greencardigan/TC4-shield/trunk/hardware/LCDapter/P1000953-BARE-800.jpg

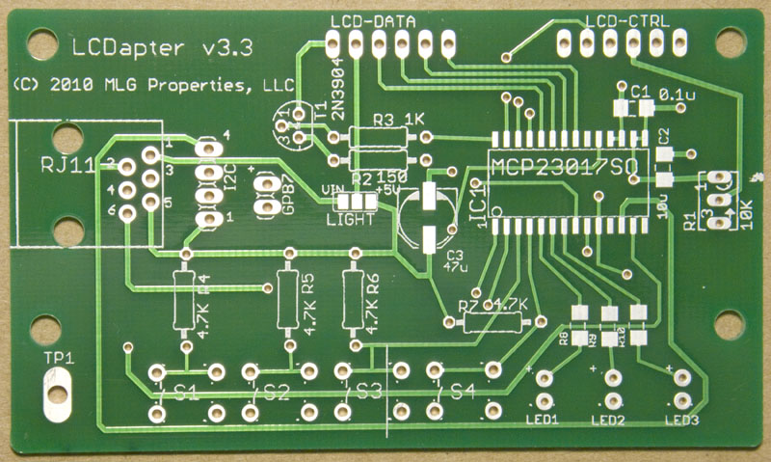
trunk/hardware/LCDapter/P1000953-BARE-800.jpg
