greencardigan/TC4-shield/trunk/README.txt

README.txt for /svn/trunk

/svn/trunk and subfolders have been superseded by a
new Subversion repository organization as of April 4, 2011.

For historical and references purposes, the old folder tree is left
intact.

No new development work should be done in this tree.  Current versions
of all project documents can be found as follows:

/svn/applications:  applications software
/svn/hardware:  PCB designs and related information
/svn/wiki:  various wiki files
