greencardigan/TC4-shield/applications/Bourbon/docs/README.txt

Bourbon 2_3 Arduino 0022 Win 7 Setup
------------------------------------

Kindly contributed by Larry Lofthouse (LoftyNotions on Homeroasters.org). Updates
and supersedes the original guide written by Randy T.

Jim Gallt
31-Jan-2012
