greencardigan/TC4-shield/trunk/arduinosoftware/sketches/demo1/README.TXT

this demo uses 18-bit samples and reports every 2 seconds
channels 0-3 assume K-type thermocouples and report temps in F.
