greencardigan/TC4-shield/applications/util/pCOMlist/trunk/pCOMlist/README.txt

pCOMlist
--------

Processing sketch that reads system information
and returns a list of the current active COM
ports.

Nothing fancy, but handy when using Arduino boards
connected remotely.

Executable versions located in the application.* folders
for various platforms.

Jim Gallt
4/16/2011
