greencardigan/TC4-shield/trunk/arduinosoftware/sketches/aGesha/cal/Readme.txt

wdw 8 mar '11

With JimG's help, we've tracked down the major cause for the non-linearity --
the two diode drops in the full-wave bridge.

So, with any luck the files in this directory will become obsolete.
