greencardigan/TC4-shield/hardware/TC4/docs/TC4-pins.pdf

5/12/2014

Pin | Descrip. | TC4 Use
D0 | RX
D1 | TX
D2 | INT0 | IO2
D3 | PWM / INT1 | IO3 & Jee3-6
D4
D5** | PWM
D6** | PWM | Jee3-2 | Note: Many Jee devices are 3.3V
D7 | | | and will not be compatible with
D8 | | | the 5V signals from Arduino.
D9 | PWM | OT1 | JeePort header
D10* | PWM | OT2
D11* | PWM | | Header | Pin | Signal
D12* | | | Jee3 | 1 | VIN
D13* | | | | 2 | D6
| | | | 3 | GND
A0 | | ANLG1 | | 4 | +3.3V
A1 | | ANLG2 | | 5 | A2
A2 | | Jee3-5 | | 6 | D3
A3
A4 | | I2C (SDA)
A5 | | I2C (SCL)

* These pins support SPI communication, which, although provided
by the underlying hardware, is not currently included in the Arduino language.

** These pins support PWM provided by timer0. Timer0 is also used
for the millis() and analogWrite() functions.
Arduino pin descriptions | Updated 5/12/14
