greencardigan/TC4-shield/applications/Bourbon/aBourbon/tags/REL-200/pBourbon/logs/roast201104072021-4435.jpg

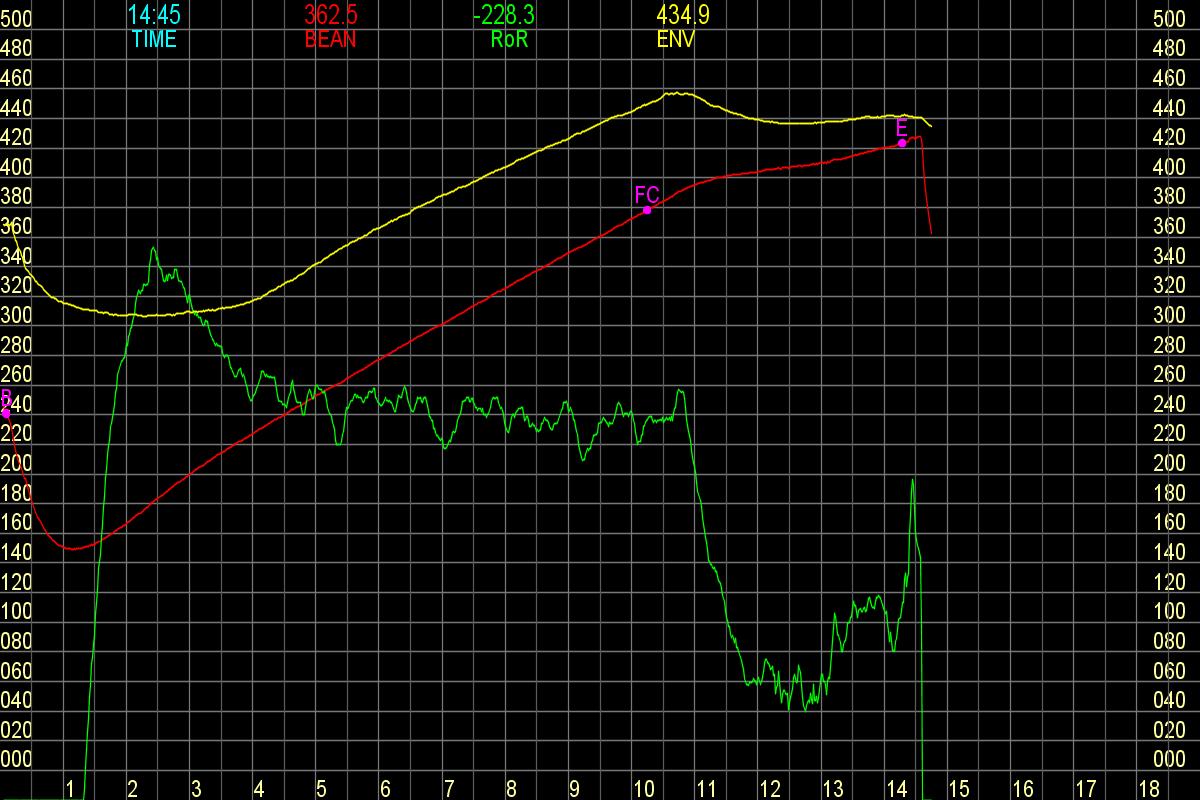
applications/Bourbon/aBourbon/tags/REL-200/pBourbon/logs/roast201104072021-4435.jpg
