greencardigan/TC4-shield/applications/Bourbon/aBourbon/tags/REL-200/pBourbon/logs/roast201104072110-3110.jpg

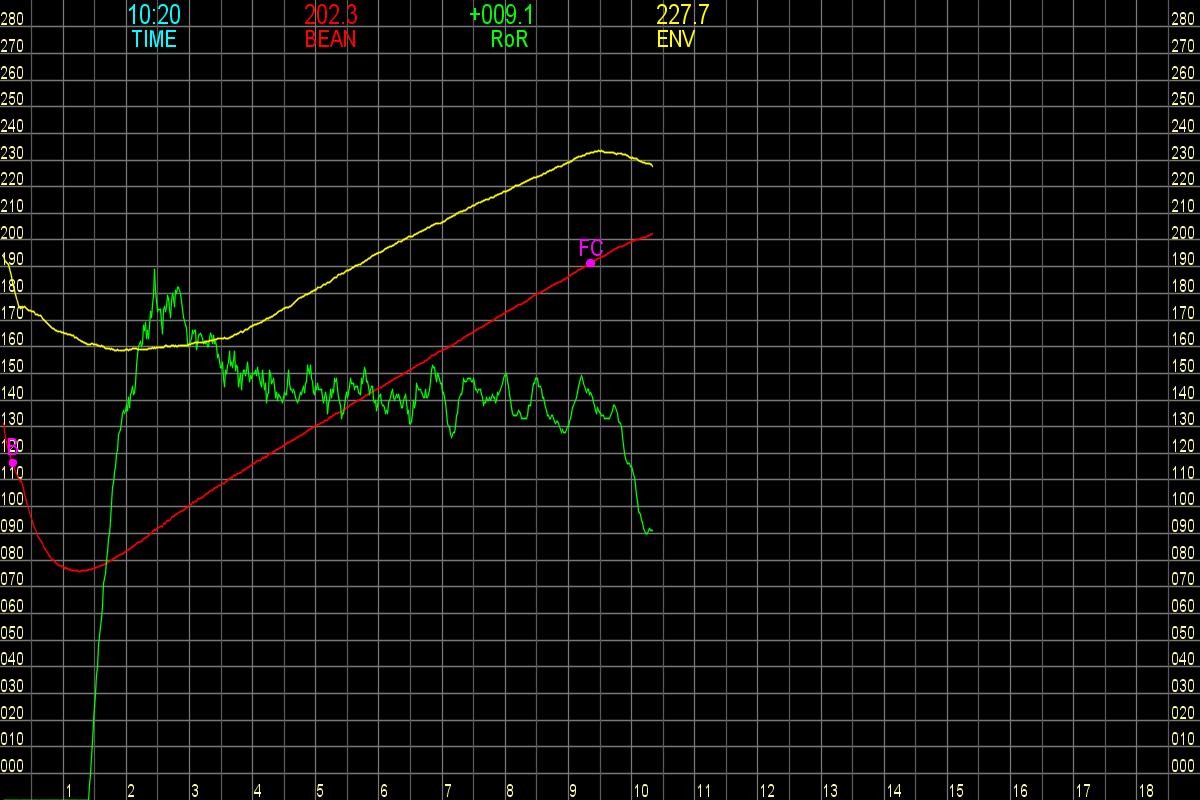
applications/Bourbon/aBourbon/tags/REL-200/pBourbon/logs/roast201104072110-3110.jpg
