greencardigan/TC4-shield/hardware/TC4C/V1.33/tc4c133-800.jpg

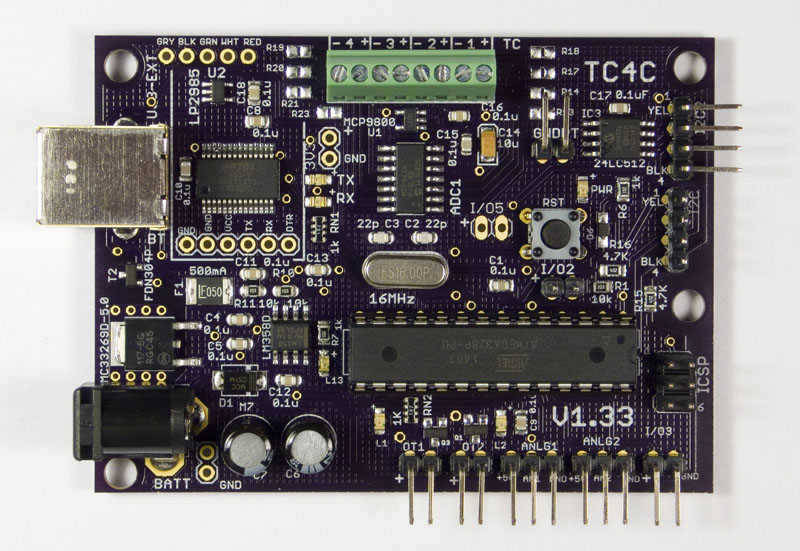
hardware/TC4C/V1.33/tc4c133-800.jpg
