greencardigan/TC4-shield/trunk/arduinosoftware/sketches/aGesha/juice_monitor.jpg

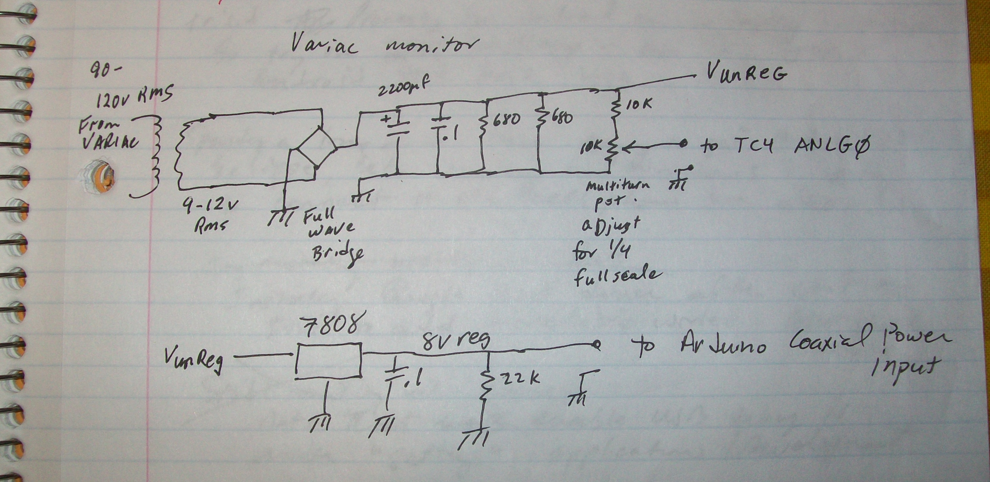
trunk/arduinosoftware/sketches/aGesha/juice_monitor.jpg
