greencardigan/TC4-shield/trunk/hardware/LCDapter/LCDcable-800.jpg

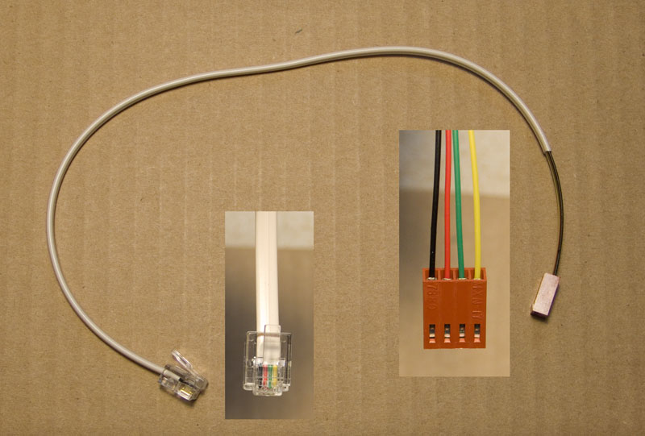
trunk/hardware/LCDapter/LCDcable-800.jpg
