greencardigan/TC4-shield/trunk/hardware/LCDapter/P1000949-SMD-800.jpg

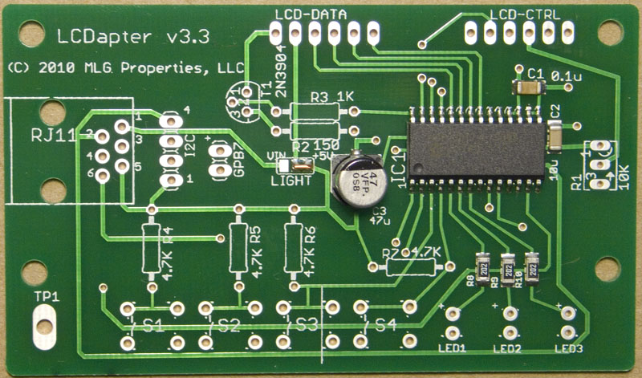
trunk/hardware/LCDapter/P1000949-SMD-800.jpg
