greencardigan/TC4-shield/trunk/hardware/LCDapter/P1000961-800.jpg

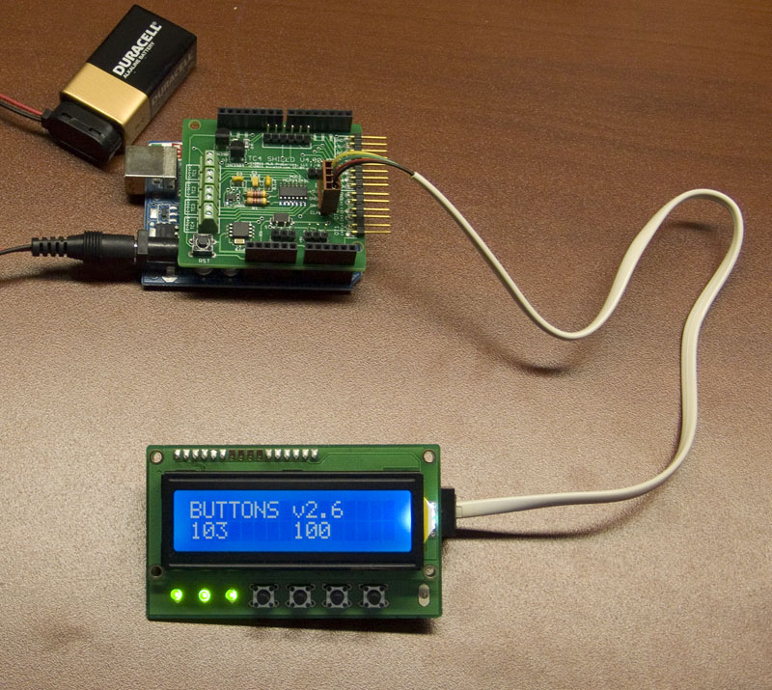
trunk/hardware/LCDapter/P1000961-800.jpg
