greencardigan/TC4-shield/trunk/hardware/TC4 V400/P1000915-600.jpg

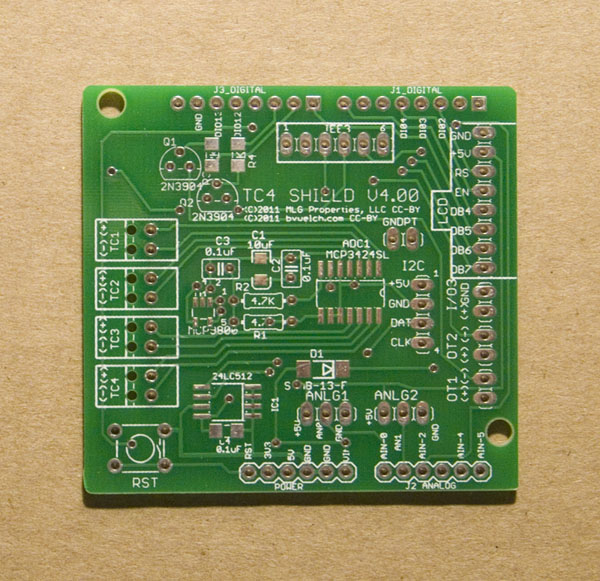
trunk/hardware/TC4 V400/P1000915-600.jpg
