greencardigan/TC4-shield/trunk/hardware/TC4 V400/P1000938-SMD.jpg

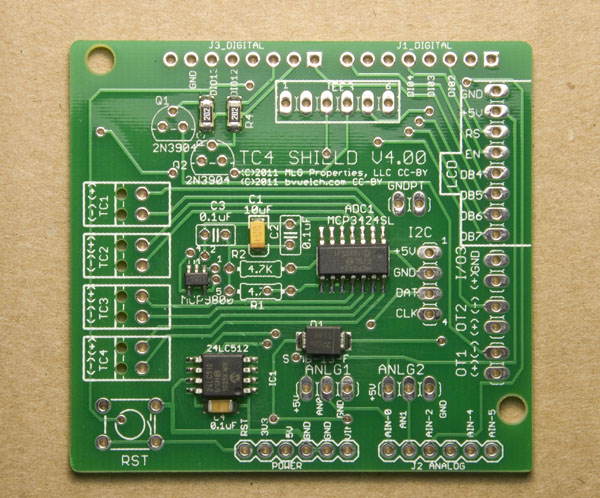
trunk/hardware/TC4 V400/P1000938-SMD.jpg
