greencardigan/TC4-shield/trunk/hardware/docs/TC4-pins.xlsx

Arduino pin assignments |  |  | LCD pin header
Pin | Descrip. | TC4 Use | Header | Pin | Signal
D0 | RX |  | LCD | 1 | GND
D1 | TX |  |  | 2 | 5V
D2 | INT0 | LCD 4 RS |  | 3 | D2
D3 | PWM / INT1 | I/O3 & Jee3-6 |  | 4 | D4
D4 |  | LCD 6 EN |  | 5 | D7
D5 | PWM/millis() |  |  | 6 | D8
D6 | PWM/millis() | Jee3-2 |  | 7 | D12
D7 |  | LCD 11 DB4 |  | 8 | D13
D8 |  | LCD 12 DB5
D9 | PWM | OT1 | JeePort header
D10* | PWM | OT2
D11* | PWM |  | Header | Pin | Signal
D12* |  | LCD 13 DB6 | Jee3 | 1 | VIN
D13* |  | LCD 14 DB7 |  | 2 | D6
 |  |  |  | 3 | GND
A0 |  | ANLG1 |  | 4 | +3.3V
A1 |  | ANLG2 |  | 5 | A2
A2 |  | Jee3-5 |  | 6 | D3
A3 |  | button interface
A4 |  | I2C
A5 |  | I2C
* These pins support SPI communication, which, although provided
by the underlying hardware, is not currently included in the Arduino language.
16 x 2 LCD pin assignments
 |  | Arduino | Jumper - Pin | LCD board
1 | VSS | GND | LCD-1 | ground, POT-1
2 | VDD | 5V | LCD-2 | Vdd, POT-3
3 | V0 |  |  | POT-2 (wipe)
4 | RS | D2 | LCD-3
5 | R/W | GND |  | ground
6 | EN | D4 | LCD-4
7 | DB0 |  |  | nc
8 | DB1 |  |  | nc
9 | DB2 |  |  | nc
10 | DB3 |  |  | nc
11 | DB4 | D7 | LCD-5
12 | DB5 | D8 | LCD-6
13 | DB6 | D12 | LCD-7
14 | DB7 | D13 | LCD-8
15 | (optional) |  |  | Vdd (backlight)
16 | (optional) |  |  | ground (backlight)
POT = 10K LCD contrast adjustment potentiometer
Current TC-4 shield v1.06R shown in normal text.
Proposed TC-4 shield v2.00 shown in italics text.
