greencardigan/TC4-shield/hardware/TC4C/V1.32/tc4c132.dxf

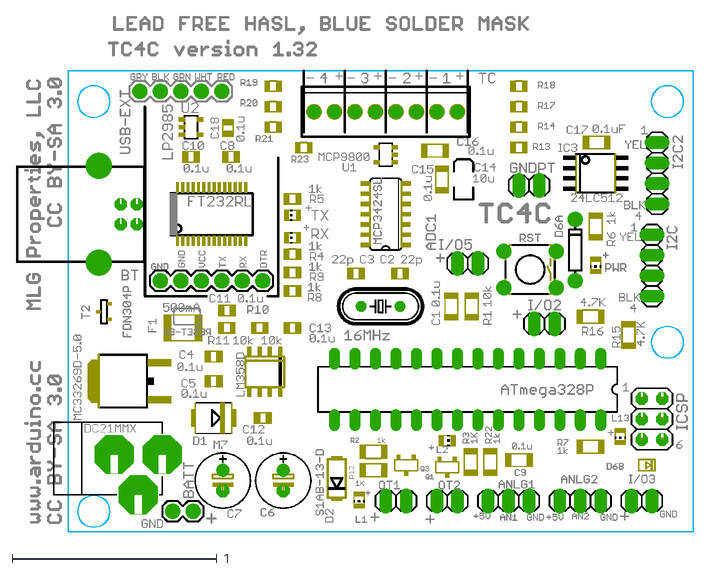
[picture p14: CAD file, 2015-12-07, an earlier design]
hardware/TC4C/V1.32/tc4c132.dxf
3.30 x 2.52
