greencardigan/TC4-shield/applications/Artisan/aArtisan_PID/branches/aArtisanQ_PID 6.5 IO11 Test/aArtisanQ_PID/tc4-wiring-small-20111120.jpg

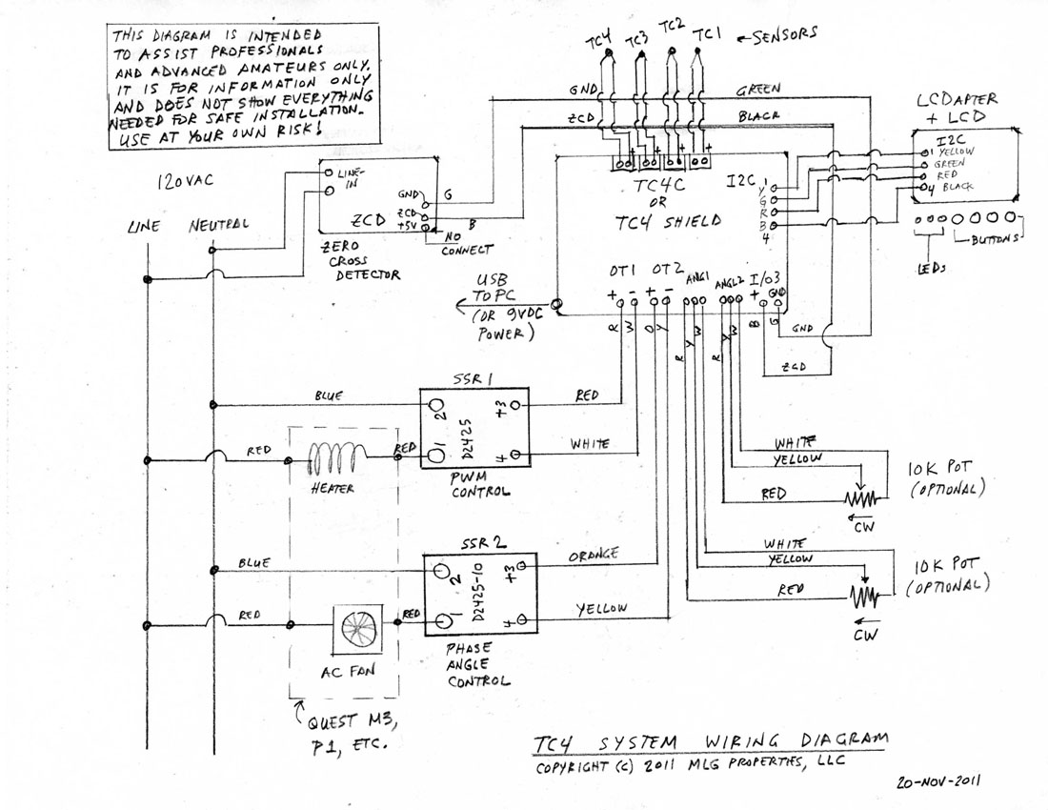
applications/Artisan/aArtisan_PID/branches/aArtisanQ_PID 6.5 IO11 Test/aArtisanQ_PID/tc4-wiring-small-20111120.jpg
