greencardigan/TC4-shield/trunk/hostsoftware/pj_logger/testlog001.csv

# time | ambient | T0 | T1 | T2 | T3
# mcp9800 Config reg OK
10 | 73 | 32 | 71 | 71 | 72
12 | 73 | 32 | 71 | 71 | 72
13 | 73 | 32 | 71 | 71 | 72
14 | 73 | 32 | 71 | 71 | 72
15 | 73 | 32 | 71 | 71 | 72
17 | 73 | 32 | 71 | 71 | 72
18 | 73 | 200 | 71 | 72 | 72
19 | 73 | 200 | 71 | 71 | 72
20 | 73 | 200 | 71 | 71 | 72
21 | 73 | 200 | 71 | 71 | 72
23 | 73 | 200 | 71 | 71 | 72
24 | 73 | 200 | 71 | 72 | 72
25 | 73 | 200 | 71 | 72 | 73
26 | 73 | 200 | 71 | 71 | 73
28 | 73 | 200 | 71 | 71 | 73
29 | 73 | 200 | 71 | 71 | 73
30 | 73 | 200 | 71 | 71 | 73
31 | 73 | 200 | 71 | 71 | 73
32 | 73 | 200 | 71 | 71 | 72
34 | 73 | 200 | 71 | 71 | 72
35 | 73 | 200 | 71 | 71 | 82
36 | 73 | 200 | 71 | 72 | 86
37 | 73 | 200 | 71 | 71 | 87
39 | 73 | 200 | 71 | 71 | 88
40 | 73 | 200 | 71 | 71 | 89
41 | 73 | 200 | 71 | 71 | 89
42 | 73 | 200 | 71 | 71 | 90
44 | 73 | 200 | 78 | 71 | 90
45 | 73 | 200 | 87 | 71 | 90
46 | 73 | 200 | 88 | 71 | 91
47 | 73 | 200 | 90 | 72 | 91
48 | 73 | 200 | 90 | 72 | 91
50 | 73 | 200 | 91 | 72 | 91
51 | 73 | 200 | 91 | 72 | 91
52 | 73 | 200 | 92 | 72 | 90
53 | 73 | 200 | 92 | 72 | 89
55 | 73 | 200 | 92 | 85 | 88
56 | 73 | 200 | 92 | 87 | 87
57 | 73 | 200 | 92 | 88 | 86
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
