greencardigan/TC4-shield/(threads)

Thread 1 (2017-01-12):

Disabling pwmio3 variable may effect PWM prescaler setup for DC Fan

James-NZ, 2017-01-12:
Could you please check if the following commit means that the PWM prescaler is no longer configured when using CONFIG_PWM (DC Fan):
https://github.com/greencardigan/TC4-shield/commit/1a43b605e0eeed1d8f1c8d5bd6899b52d568b04e

As far as I can tell, calling pwmio3.Setup is the only way that the prescaler is configured which is still relevant for analogWrite() as this is equivalent to pwmio3.Out().

Just to be sure, I have changed my fork to :
#ifndef CONFIG_PAC3
  pwmio3.Setup( IO3_PCORPWM, IO3_PRESCALE_128 ); // setup pwm frequency on IO3
#endif

And used pwmio3.Out() instead of analogWrite() in outIO3() just to be consistent. Refer to this merge:
https://github.com/James-NZ/TC4-shield/commit/e5bec38d448a953b3f53fba392a26abc10d823d0

This commit for bumpless PID transfer may also be of interest:
https://github.com/James-NZ/TC4-shield/commit/82f7914ceee186b2ed3b74054522580cb488c435

Cheers,
James

greencardigan, 2017-01-12:
Thanks James,
I might forward this to Jim to look at.
Cheers,
Brad

greencardigan, 2017-03-21:
Hi James,
Does this commit address your issue?
https://github.com/greencardigan/TC4-shield/commit/6602013d9a99aa43e575d62d287cea674e6788f0

Closed 2017-08-04.

Thread 5 (2021-11-09):

Conflict between CONFIG_PAC2 or CONFIG_PAC2_IO3HTR, and parallel LCD

timbarnes, 2021-11-09:
This issue has been seen with version aArtisanQ_PID 6_3, installed in a genuine Arduino UNO.

Line IO2 is assigned to Arduino D2, and is used to read the ZCD in the case that CONFIG_PAC2 or CONFIG_PAC2_IO3HTR have been selected.

The same Arduino D2 line is used for RS in the configuration of the parallel LCD display.

The CONFIG_PWM and CONFIG_PAC3 work correctly with the parallel LCD display.

The result of the conflict is incorrect data being written to the display.

One tested workaround is to redefine the LCD's RS line to use D5: this removes the conflict and will work in the case that the LCD is hand-wired to the Arduino.

greencardigan, 2021-12-15:
https://github.com/greencardigan/TC4-shield/commit/6405a10419cd8967fb9f39c79285bbbecf306dd1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

Closed 2021-12-15.

Thread 6 (2021-12-10):

PID profile number

renatoa, 2021-12-10:
Why is the parsed value of profile number incremented by one at the line below?
https://github.com/greencardigan/TC4-shield/blob/master/applications/Artisan/aArtisan_PID/trunk/src/aArtisanQ_PID/cmndreader.cpp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
This increment led to strange behavior in my practice... for example if I want to set manual mode, I have to send PID;P;-1 command, which is weird...

Also, I think that profile_number_new variable should be synced with profile_number, because it is used in many places instead.
For example, if the user switch LCD_mode to 1, after a PID;P;x command is issued, will have the screen initialized with former profile_number, instead the new profile_number x, modified by PID;P;x command.

greencardigan, 2021-12-14:
I don’t recall why I had incremented the profile number. Maybe it was old code prior to adding the PID feature and using profile 0. I will remove the increment.

I think I will sync profile_number and profile_number_new in cmndreader after line 577. That should work? However, most users that are using eeprom profiles and buttons would be in standalone mode and would not be using roasting software or the PID;P command.

renatoa, 2021-12-14:
Yes, it's ok after 577, same location added in my code too.

Closed 2021-12-15.

Thread 7 (2022-02-23):

Setpoint used instead SV, out of visibility scope

renatoa, 2022-02-23:
Trying today to debug something, activated ACKS_ON, and got the following compile error:

```
sketch\cmndreader.cpp: In member function 'virtual boolean pidCmnd::doCommand(CmndParser*)':
cmndreader.cpp:636:60: error: 'Setpoint' was not declared in this scope
       Serial.print(F("# PID setpoint = ")); Serial.println(Setpoint);

```

...at this line:
https://github.com/greencardigan/TC4-shield/blob/master/applications/Artisan/aArtisan_PID/trunk/src/aArtisanQ_PID/cmndreader.cpp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

My guess is that the author intended to print SV, not Setpoint, which is not declared External in cmndreader.cpp
And nobody used ACKS_ON since then :)

greencardigan, 2022-02-25:
https://github.com/greencardigan/TC4-shield/commit/1af3a99a78ed36d4f7126ab66c72f3f1bc9e5203

Closed 2022-02-25.

Thread 8 (2022-02-23):

Wrong parameter index in PID;P command

renatoa, 2022-02-23:
Please check here:
https://github.com/greencardigan/TC4-shield/blob/master/applications/Artisan/aArtisan_PID/trunk/src/aArtisanQ_PID/cmndreader.cpp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

paramStr(1) is not the profile number, but the P command
Should be paramStr(2)

greencardigan, 2022-02-24:
This command was originally intended to be used as per the documentation PID,Px.

However, I think it makes sense to change it to PID,P,x so it is consistent with the other command formats.

greencardigan, 2022-02-25:
https://github.com/greencardigan/TC4-shield/commit/1af3a99a78ed36d4f7126ab66c72f3f1bc9e5203

Closed 2022-02-25.

Thread 9 (2022-06-25):

'P_ON_M' was not declared in this scope

haidermri, 2022-06-25:
Trying to compile latest aArtisanQ_PID for TC4+ and running into this error

Arduino: 1.8.19 (Windows Store 1.8.57.0) (Windows 10), Board: "Arduino Uno"
D:\git\TC4-shield\applications\Artisan\aArtisan_PID\trunk\src\aArtisanQ_PID\cmndreader.cpp: In member function 'virtual boolean pidCmnd::doCommand(CmndParser*)':

cmndreader.cpp:601:39: error: 'P_ON_M' was not declared in this scope

         myPID.SetTunings( kp, ki, kd, P_ON_M ); // Proportional on Measurement

                                       ^~~~~~

cmndreader.cpp:603:39: error: 'P_ON_E' was not declared in this scope

         myPID.SetTunings( kp, ki, kd, P_ON_E ); // Proportional on Error

                                       ^~~~~~

aArtisanQ_PID:256:46: error: 'P_ON_E' was not declared in this scope

   PID myPID(&Input, &Output, &Setpoint,2,5,1,P_ON_E,DIRECT);

                                              ^~~~~~

D:\git\TC4-shield\applications\Artisan\aArtisan_PID\trunk\src\aArtisanQ_PID\aArtisanQ_PID.ino: In function 'void setup()':

aArtisanQ_PID:1488:35: error: 'P_ON_E' was not declared in this scope

   myPID.SetTunings(PRO, INT, DER, P_ON_E); // set initial PID tuning values and set Proportional on Error mode

                                   ^~~~~~

exit status 1

'P_ON_M' was not declared in this scope

renatoa, 2022-06-25:
PID library is not updated to the Proportional On Measurement version V1.2.1
You can get it from: https://github.com/br3ttb/Arduino-PID-Library

haidermri, 2022-06-25:
Thank you
That fixed it

Closed 2022-06-27.

Thread 10 (2022-08-19):

Probes not recognized?

oliverschirmer, 2022-08-19:
Hi,
long time since something happend here. Hope i'm not disturbing the silence :)
Got my setup a while ago and wanted to resume roasting...

TC4Shield + Arduino UNO
via USB to Artisan Roaster Scope (via Ubuntu 22.04 LTS)
3 working Type-K probes with the socket removed. (Tested on an other temp device)

I got a valid read out if the TC4 with the probes disconnected. 26-27°C ambient temp.. Touching the green clamps for probes makes the read out rise to 30°C... as expected.

Connecting the probes and activating the data collection still shows the ambient temp. Touching the green clamps makes the temp rise. Touching the probes end won't make a change.
I tested all channels with both polarities and different probes.

How do I debug from here?

Thanks a lot!
Oliver

greencardigan, 2022-08-24:
Hi, If your thermocouples are definitely working, the only thing I can think of is the ADC chip isn't working properly.

oliverschirmer, 2022-08-24:
Thanks for writing back! Can you elaborate? Why is it sending correct temp data from the "socket" (where the probes get connected to the TC4) if the chip is not working? The ADCs function is to convert analog to digital, right?

How can i verify the status of the components on the board?

I thought it could be a setup issue or because it's version 4.0 (which i forgot to mention...)
Replacing the chip is out of my skill level. Maybe I can use it to automatically open the door of the roasters drum if the drop event is triggered...

Is there a better plattform to continue? This is for coding issues, not a repairing forum, right?

greencardigan, 2022-08-24:
The cold junction/ambient temperature is measured the small temperature sensor chip with 5 pins located just behind the thermocouple connectors. Then the voltage across the thermocouple is measured by the ADC and is converted to a temperature, then added to the cold junction temperature to get the thermocouple temperature. So getting ambient temperature readings only confirms that the cold junction temperature sensor is working.

Version 4 may not have the small capacitors that help protect the ADC.

It seems strange that all channels aren't working. Have you got any different thermocouples to try?

Probably best to ask on the homeroasters.org forum. Maybe this thread. https://homeroasters.org/forum/viewthread.php?thread_id=2180

renatoa, 2022-08-24:
What you mean by " Touching the green clamps"... is this the same as  "the "socket" (where the probes get connected"?
What's the point to test by touching that area, are you trying to induce a shift the cold junction temperature ?

Is not strange that all behave the same, it's only a single ADC and an input mux.

Thread 12 (2023-07-02):

Can you please add functionality for a second DC fan?

arash-ops, 2023-07-02:
Hi, I've redesigned a TC4 type of shield which includes two DC fan outputs and ESP01 wifi module. Everything else stays the same as the current TC4 shield. I need the second DC fan capability for exhaust setup on my DIY coffee roaster using Artisan. Any chance you are able to update your code to add functionality for the second DC fan please? I can try to figure out the ESP01 wifi module programming separately myself. Thank you for all your work on this code

GRIMORIO, 2023-07-02:
tc4 is obsolete, I replaced it with phidgets

arash-ops, 2023-07-02:
I meant I’ve designed a board similar to TC4+ except it has two dc fan motors. How much work would it be to add a second dc fan into your code?

MAKOMO, 2023-07-03:
The TC4 protocol does not support two fans, but only one fan and one heater. We have no intention to extend that protocol any further or change its implementation on the Artisan side. Either use the heater data for your second fan or use a different protocol like MODBUS.

renatoa, 2023-07-03:
> tc4 is obsolete, I replaced it with phidgets

This was your choice, but this not make TC4 is obsolete.
An open source project lives as long as his users decide.
You can't write code for phidgets, for TC4 it's possible.
Added a lot of additional hardware to my TC4, foe example Pt sensors and pressure measurement support are the most noticeable I am remember atm.
Even a second fan addition is possible, there are examples of a second IO3 additions in the HRO forum, coded by me and others.

renatoa, 2023-07-03:
> The TC4 protocol does not support two fans, but only one fan and one heater. We have no intention to extend that protocol any further or change its implementation on the Artisan side. Either use the heater data for your second fan or use a different protocol like MODBUS.

He didn't asked for Artisan support, but for TC4.

greencardigan, 2023-07-03:
Correct, control of a second fan can be added to the TC4 code.  You can even have it work with serial commands sent from Artisan to control it.  You just can't plot the additional fan value on the Artisan graph unless you do a work around like Marko mentioned.

It wouldn't take long to add some basic control of a second fan, but I do not have the time available to do it for you unfortunately.

arash-ops, 2023-07-04:
Ok thanks all for the comments. @renatoa - can you send a link to the HRO forum you are referring to please?
Also I’m curious, do you use pt sensors for coffee roasting?

@greencardigan - I’m not looking to plot the second fan in Artisan. I just need to be able to operate it from artisan. Do you have any general guidance on what I need to update in the code? I can have a go and see if I can get it to work. I have basic enough knowledge to be able to have a go at it if I have some direction and with a lot of google help!

greencardigan, 2023-07-04:
@arash-ops - If you're using CONFIG_PAC2 mode, then you might already be able to use a second fan on the IO3 output and use the IO3;xxx serial command in Artisan.

Otherwise you would have to modify the code for an existing command (in cmndreader.cpp) or create a new command to do an analogWrite.

renatoa, 2023-07-04:
> Ok thanks all for the comments. @renatoa - can you send a link to the HRO forum you are referring to please?
Also I’m curious, do you use pt sensors for coffee roasting?

Ask @timbarnes here:
https://homeroasters.org/forum/viewthread.php?thread_id=6683&highlight=IO4&pid=74502#post_74502
...if no reply will send you my (untested) code

Yes, Pt support was been added for a coffee roaster, to replace TC, in a setup where TC don't perform very well.

arash-ops, 2023-07-11:
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

@greencardigan - I am using the Config_pwm mode. Would I still be able to use AWRITE;ppp;ddd command with this for a second DC fan?

greencardigan, 2023-07-11:
@arash-ops
I think so. The AWRITE command should just be doing a standard arduino analogwrite to the chosen arduino pin.

renatoa, 2023-07-11:
Sent you a PM with a solution on HR forum, noticed ?

arash-ops, 2023-07-13:
@renatoa - only got an email this morning from you. It didn't send me a notification when you send the PM, sorry. Let me see if I can change my email preferences on there.

Thread 13 (2024-02-07):

Setting up artisan with EMKO TCE

JugoOriginal, 2024-02-07:
Hey,
i am trying to setup a EMKO TCE with an arduino and TC4+ in artisan but i am kind of struggling and i stumbled on your page and you seem to know quite a bit about this topic.
My end goal is to send the measured temperature via WiFi to artisan.
Could you help me out please?
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

JugoOriginal, 2024-02-08:
first of all,  thanks for the fast reply!

1. i would like to get the measurements from the sensor into artisan... i never used this before and couldnt get this setup

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

2. in the second step, i would like to send the data remotely to artisan.. basically establish a wireless communication... initially i wanted to use wifi but apparently that is not a good idea.

3. does anyone have experience with such a setup or are there anywhere detailed instructions that i can simply follow? which bluetooth device i need to buy, arduino code etc.

Thank you for your help!

renatoa, 2024-02-09:
BT module is good, it is known also as HC-05. Tons of resources if you search by this name and Arduino. For example:
https://www.instructables.com/Arduino-Bluetooth-Remote-Control-Part-1-Bluetooth-/

For TC4 the main rsources are hosted here:
https://homeroasters.org/forum/viewforum.php?forum_id=133
Just browse the threads about install and setup.

JugoOriginal, 2024-02-09:
thank you very much i´ll do my best to figure this out!

Closed 2024-02-09.

Thread 14 (2024-02-11):

HC-05 modul not discoverable and no resonse in serial monitor

JugoOriginal, 2024-02-11:
Hey there!
I followed the bluetooth configuration sheet online and uploaded the sketch to my arduino mega 2560 but when i type in for example "AT" in my serial monitor i dont get the respose "OK". Furthermore, even though the HC-05 is blinking rapidly, my laptop cant find it. Is there something wrong with the module or is it something else?
Thank you!

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

Thread 15 (2025-01-06):

How to change the frequency on io3

ziomina, 2025-01-06:
I want to replace DCFAN with brushless motor.it need to change PWM frequency to 50Hz on io3. I know it can be changed but I don’t know how.thanks

renatoa, 2025-01-06:
Check PWM_IO3 class for prescaler values for various pwm frequencies.

greencardigan, 2025-01-07:
And then adjust the pwmio3.setup line [here](https://github.com/greencardigan/TC4-shield/blob/20af771463f8a5691169e29d02a686a4cd54e224/applications/Artisan/aArtisan_PID/trunk/src/aArtisanQ_PID/aArtisanQ_PID.ino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)

50Hz is not an option, see below.

```
PWM Frequencies

fast = 16,000,000 / prescale / 256
pcor = 16,000,000 / prescale / 2 / 255

Mode        Prescale              Frequency
----        --------              ---------
fast            1                  62.5kHz
fast            8                  7.8125kHz
fast           32                  1.953125kHz
fast           64                  976.5625Hz
fast          128                  488.28125Hz
fast          256                  244.140625Hz
fast         1024                  61.03515625Hz (PWM16 library default)

pcor            1                  31.37kHz
pcor            8                  3.922kHz
pcor           32                  980.4Hz
pcor           64                  490.2Hz (arduino default)
pcor          128                  245.1Hz
pcor          256                  122.5Hz
pcor         1024                  30.64Hz
```

```
#define IO3_FASTPWM _BV(COM2A1) | _BV(COM2B1) | _BV(WGM21) | _BV(WGM20) // fast PWM
#define IO3_PCORPWM _BV(COM2A1) | _BV(COM2B1) | _BV(WGM20) // phase correct PWM

// BOTTOM to TOP 00 to TOP, setting TOP value in OCR2A:
#define IO3_FASTPWM_TOP _BV(COM2A0) | _BV(COM2B1) | _BV(WGM21) | _BV(WGM20) // fast PWM
#define IO3_PCORPWM_TOP _BV(COM2A0) | _BV(COM2B1) | _BV(WGM20) // phase correct PWM

#define IO3_PRESCALE_1 _BV(CS20) // 0x01, divide by 1
#define IO3_PRESCALE_8 _BV(CS21) // 0x02, divide by 8
#define IO3_PRESCALE_32 _BV(CS21) | _BV(CS20) // 0x03, divide by 32
#define IO3_PRESCALE_64 _BV(CS22) // 0x04, divide by 64
#define IO3_PRESCALE_128 _BV(CS22) | _BV(CS20) // 0x05, divide by 128
#define IO3_PRESCALE_256 _BV(CS22) | _BV(CS21) // 0x06, divide by 256
#define IO3_PRESCALE_1024 _BV(CS22) | _BV(CS21) | _BV(CS20) // 0x07, divide by 1024
```

renatoa, 2025-01-07:
What about this...

```
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
```

Thread 16 (2025-01-23):

Errors in Artisan logger section when not using PID

renatoa, 2025-01-23:
The section starting here:
https://github.com/greencardigan/TC4-shield/blob/master/applications/Artisan/aArtisan_PID/trunk/src/aArtisanQ_PID/aArtisanQ_PID.ino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

... should be conditionally compiled, i.e. enclosed in a PID related #ifdef, else errors about my PID and setpoint not defined are issued when PID is not used.

Thread 17 (2025-03-17):

RC Brushless and 50Hz ESC

ser872, 2025-03-17:
Hello, I am using Arduino UNO + TC4plus + ESC 50Hz + RC Brushless 2200KV (Used in aeromedalism) on modified popcorn roasting machine.
On the OT1 port I use an SSR Relay for the heater, on the IO3 port instead I use the ESC that controls the brushless motor.
At the moment I can have a difference in RPM of the motor for each click on the Artisan slider of about 180 - 200 rpm, I would like to reduce this number to a maximum of 100 rpm. To do this I necessarily have to use a PWM frequency of 50Hz. My question is: how can I implement this frequency, are there any updates planned in the future that will allow it to be added? Or is it possible to add the Servo Library that in theory would allow it to be done?
Many thanks to anyone who can help me!

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

renatoa, 2025-03-17:
As already explained in issue #15, back in January, the best you can get is 60 HZ
https://github.com/greencardigan/TC4-shield/issues/15#issuecomment-2574404974

ser872, 2025-03-19:
Thank you Renato, unfortunately if I use prescale 1024 then the rpm difference increase significantly, instead of decreasing.

ser872, 2025-03-19:
I'm using a 2200KV motor with 12V, usually I'm starting the roasting with 17.100rpm and finishing with 14.000rpm (I use an optic rpm reader).
I also have modified the Artisan Fan slider scale to 0 - 150.

Thread 18 (2025-08-15):

Attempt to port aArtisanQ_PID to esp8266 or esp32

StrobesAV, 2025-08-15:
Hi, can you please give some pointers how to port this code to ESP platform?
I just compiled the code for Arduion Uno to realize that there is no inventory of TC4+ on entire Web.

Are these errors because  GPIO is not correctly defined to match ESP board?
Thank you.

```
C:\Users\pilot\Documents\Arduino\aArtisanQ_PID_copy_esp8266\phase_ctrl.cpp:103:3: error: 'TIMSK1' was not declared in this scope
  103 |   TIMSK1 = 0; // disable all interrupts
      |   ^~~~~~
C:\Users\pilot\Documents\Arduino\aArtisanQ_PID_copy_esp8266\phase_ctrl.cpp:104:3: error: 'TCCR1A' was not declared in this scope
  104 |   TCCR1A =  0; // put timer1 in normal mode; output pins under sketch control
      |   ^~~~~~
C:\Users\pilot\Documents\Arduino\aArtisanQ_PID_copy_esp8266\phase_ctrl.cpp:105:3: error: 'TCCR1B' was not declared in this scope
  105 |   TCCR1B = _BV(TCCR1B_CS11); // set prescaler to clk/8 (1 count = 0.5 uS)
      |   ^~~~~~
C:\Users\pilot\Documents\Arduino\aArtisanQ_PID_copy_esp8266\phase_ctrl.cpp:106:3: error: 'OCR1A' was not declared in this scope
  106 |   OCR1A = 0xFFFF; // initialize output compare register A to max value
      |   ^~~~~
C:\Users\pilot\Documents\Arduino\aArtisanQ_PID_copy_esp8266\phase_ctrl.cpp:108:3: error: 'TCNT1' was not declared in this scope
  108 |   TCNT1 = 0; // set the timer to zero
      |   ^~~~~
C:\Users\pilot\Documents\Arduino\aArtisanQ_PID_copy_esp8266\phase_ctrl.cpp: In function 'void ISR_ZCD()':
C:\Users\pilot\Documents\Arduino\aArtisanQ_PID_copy_esp8266\phase_ctrl.cpp:113:3: error: 'TCNT1' was not declared in this scope
  113 |   TCNT1 = 0;  // reset timer1 counter
      |   ^~~~~
C:\Users\pilot\Documents\Arduino\aArtisanQ_PID_copy_esp8266\phase_ctrl.cpp:121:3: error: 'OCR1A' was not declared in this scope

c:\Users\pilot\Documents\Arduino\libraries\PWM16/PWM16_FAST.h:173:31: note: in expansion of macro 'IO3_FASTPWM'
  173 |     void Setup( uint8_t pwm = IO3_FASTPWM, uint8_t prescale = IO3_PRESCALE_1024 );
      |                               ^~~~~~~~~~~
c:\Users\pilot\Documents\Arduino\libraries\PWM16/PWM16_FAST.h:156:66: error: 'WGM20' was not declared in this scope
  156 | #define IO3_FASTPWM _BV(COM2A1) | _BV(COM2B1) | _BV(WGM21) | _BV(WGM20) // fast PWM
      |                                                                  ^~~~~
C:\Users\pilot\AppData\Local\Arduino15\packages\esp32\hardware\esp32\3.0.7\cores\esp32/Arduino.h:111:25: note: in definition of macro '_BV'
  111 | #define _BV(b) (1UL << (b))
      |                         ^
c:\Users\pilot\Documents\Arduino\libraries\PWM16/PWM16_FAST.h:173:31: note: in expansion of macro 'IO3_FASTPWM'
  173 |     void Setup( uint8_t pwm = IO3_FASTPWM, uint8_t prescale = IO3_PRESCALE_1024 );
      |                               ^~~~~~~~~~~
c:\Users\pilot\Documents\Arduino\libraries\PWM16/PWM16_FAST.h:169:31: error: 'CS22' was not declared in this scope
  169 | #define IO3_PRESCALE_1024 _BV(CS22) | _BV(CS21) | _BV(CS20) // 0x07, divide by 1024
      |                               ^~~~
C:\Users\pilot\AppData\Local\Arduino15\packages\esp32\hardware\esp32\3.0.7\cores\esp32/Arduino.h:111:25: note: in definition of macro '_BV'
  111 | #define _BV(b) (1UL << (b))
      |                         ^
c:\Users\pilot\Documents\Arduino\libraries\PWM16/PWM16_FAST.h:173:63: note: in expansion of macro 'IO3_PRESCALE_1024'
  173 |     void Setup( uint8_t pwm = IO3_FASTPWM, uint8_t prescale = IO3_PRESCALE_1024 );
```

greencardigan, 2025-08-16:
Sorry I can not provide advice on how to port to Esp, but maybe have a look at Renatoa's fork for ESP.

https://github.com/renatoa/TC4-shield/tree/master/applications/Artisan/aArtisanESP

StrobesAV, 2025-08-16:
Just wanted to mention: If I download zip from here: https://github.com/greencardigan/TC4-shield it is missing aArtizaESP.
If I try to clone using Git Desktop I'm getting this error:

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

StrobesAV, 2025-08-17:
Hi, I'm happy to report that code compiled fine with esp8266 board core 2.4.2.
I see in documents that WiFI was causing problems. Is this the same for ESP32?
The code show that ESP32 was considered?
