greencardigan/TC4-shield/trunk/hostsoftware/pj_logger/testlog001.pdf

## Test of TC‐4 Arduino Shield

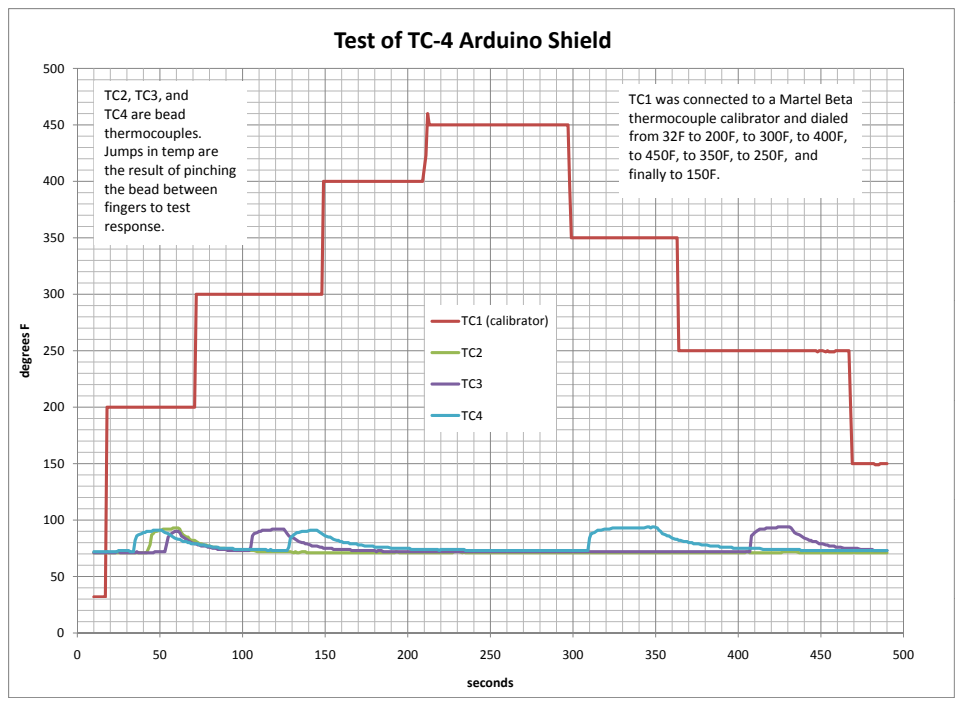
[picture p27: page 1]
degrees; FTC1 (calibrator); seconds

TC2 | TC1 was connected to a Martel Beta , TC3, and TC1 was connected to a Martel Beta
TC4 are bead
thermocouples. | from 32F to 200F, to 300F, to 400F,
Jumps in temp are | to 450F, to 350F, to 250F, | and
the result of pinching
the bead between
fingers to test
response.

thermocouple calibrator and dialed

finally to 150F.
