greencardigan/TC4-shield/hardware/LCDapter/LCDapterC V122/LCDapterC-122-sch.pdf

A

A

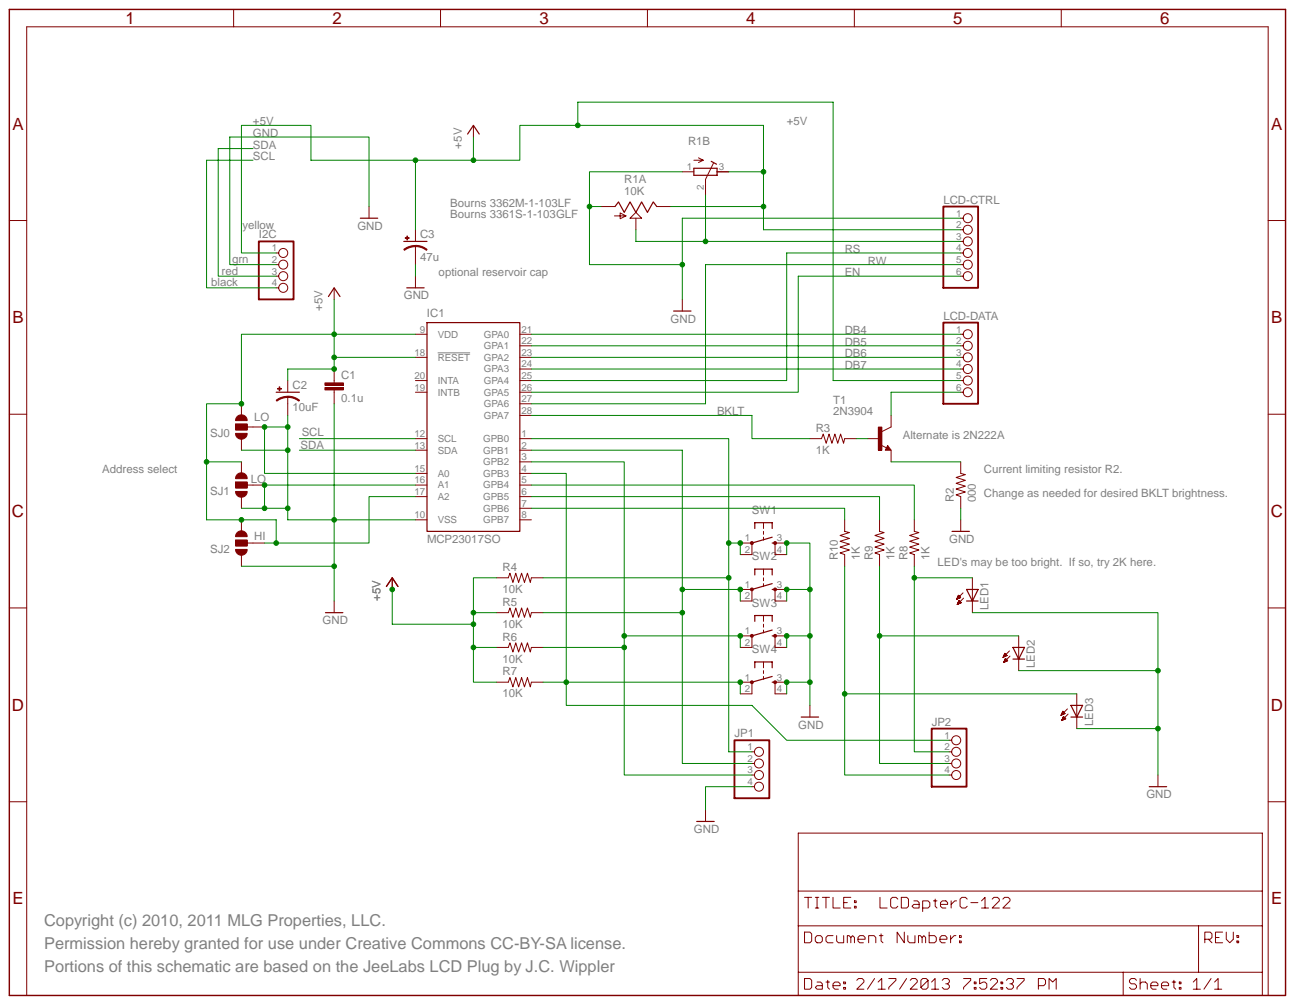
[picture p28: page 1]

Current limiting resistor R2.
Change as needed for desired BKLT brightness.

LED's may be too bright. If so, try 2K here.

Copyright (c) 2010, 2011 MLG Properties, LLC.
Permission hereby granted for use under Creative Commons CC-BY-SA license.
Portions of this schematic are based on the JeeLabs LCD Plug by J.C. Wippler
