greencardigan/TC4-shield/hardware/TC4/TC4 V600/tc4-controller-0600-sch.pdf

## TC inputs

## RESET

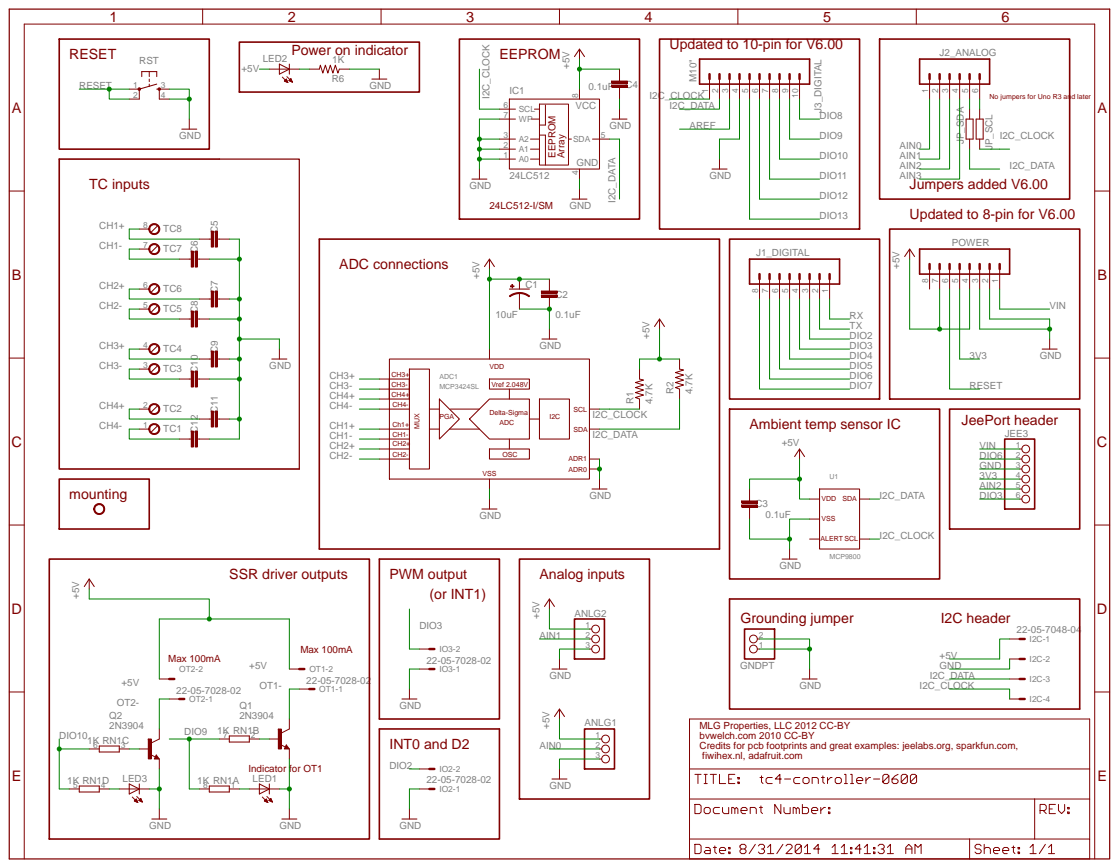
[picture p29: page 1]

Updated to 10-pin for V6.00

No jumpers for Uno R3 and later

Updated to 8-pin for V6.00

Ambient temp sensor IC

MLG Properties, LLC 2012 CC-BY
bvwelch.com 2010 CC-BY
Credits for pcb footprints and great examples: jeelabs.org, sparkfun.com,
fiwihex.nl, adafruit.com
