greencardigan/TC4-shield/trunk/hardware/LCDapter/LCD01v200.sch.pdf

A

A

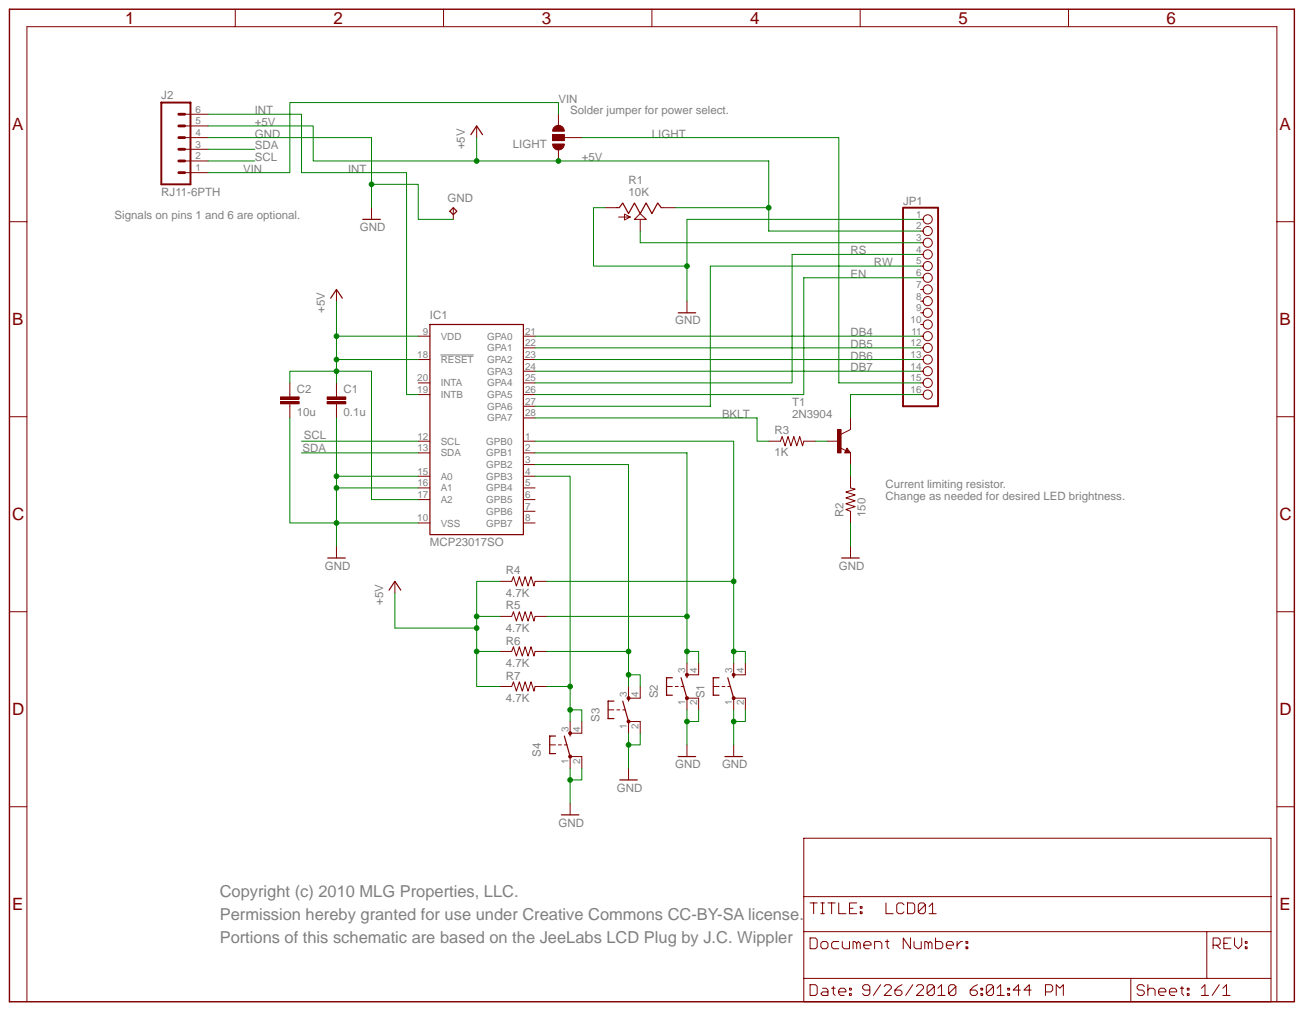
[picture p32: page 1]

VIN
Solder jumper for power select.

Signals on pins 1 and 6 are optional.

Current limiting resistor.
Change as needed for desired LED brightness.

Copyright (c) 2010 MLG Properties, LLC.
Permission hereby granted for use under Creative Commons CC-BY-SA license.
Portions of this schematic are based on the JeeLabs LCD Plug by J.C. Wippler
