greencardigan/TC4-shield/trunk/hardware/TC4 V400/tc4-controller-0400-brd.pdf

### GND

+5V

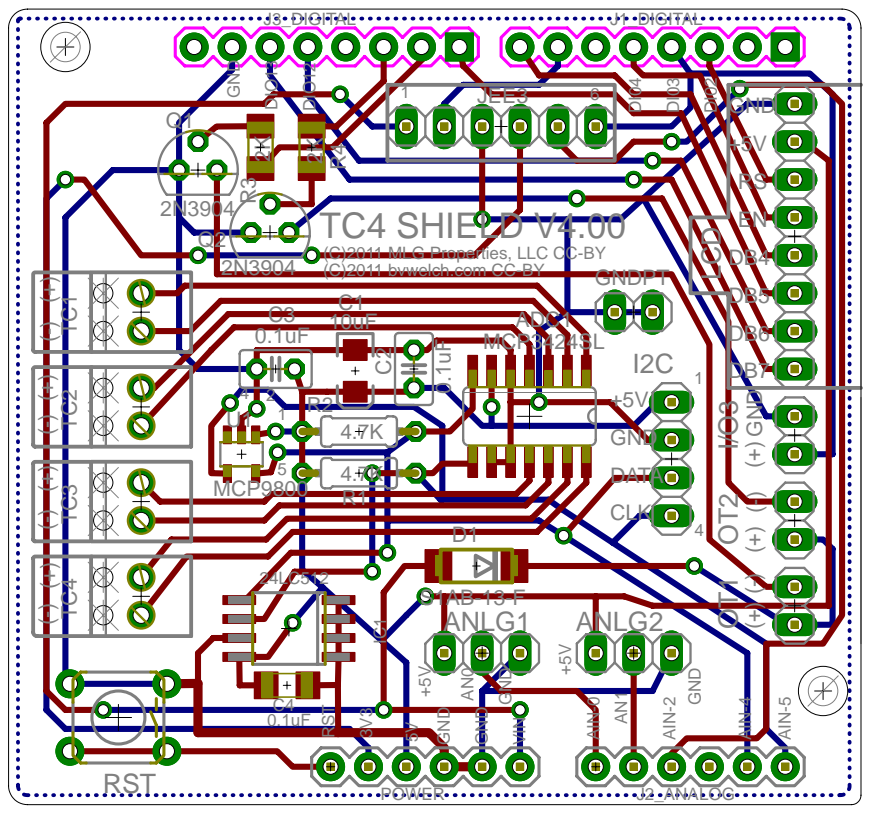
[picture p33: page 1]

(C)2011 MLG Properties, LLC CC-BY
(C)2011 bvwelch.com CC-BY
