greencardigan/TC4-shield/trunk/hardware/TC4 V400/tc4-controller-0400-sch.pdf

## TC inputs

RESET | Ambient temp sensor IC

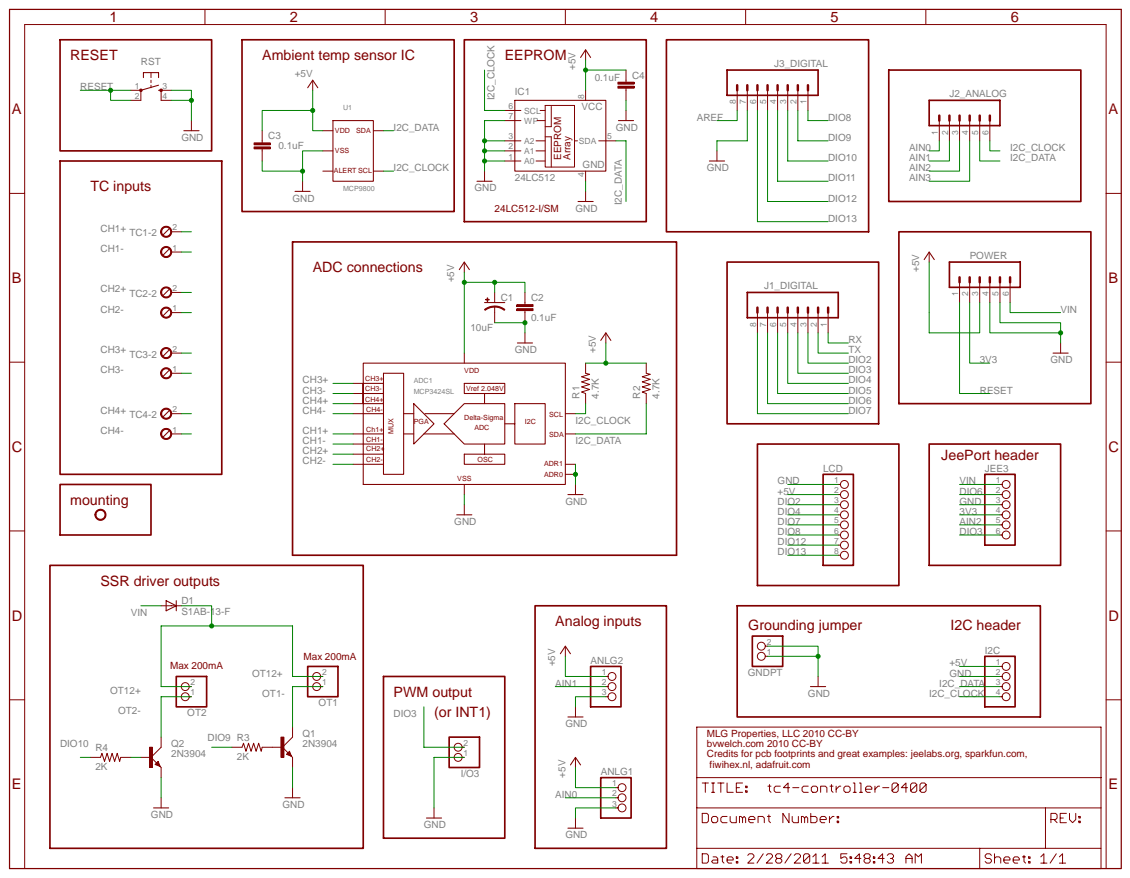
[picture p34: page 1]

8 4 SCL 6 SDA 5 A0 1 A1 2 A2 3 WP 7 VCC GND IC1

MLG Properties, LLC 2010 CC-BY
bvwelch.com 2010 CC-BY
Credits for pcb footprints and great examples: jeelabs.org, sparkfun.com,
fiwihex.nl, adafruit.com
