greencardigan/TC4-shield/hardware/LCDapter/LCDapterC V122/LCDapterC-122-brd.pdf

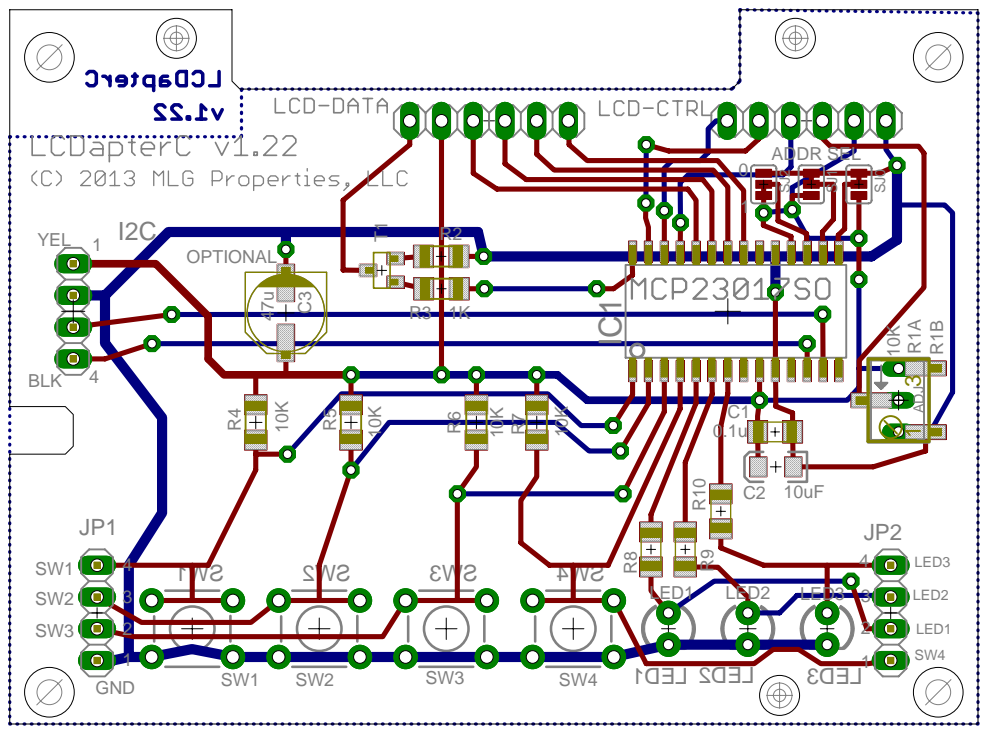
[picture p35: page 1]
