greencardigan/TC4-shield/hardware/TC4/TC4 V600/tc4-controller-0600-brd.pdf

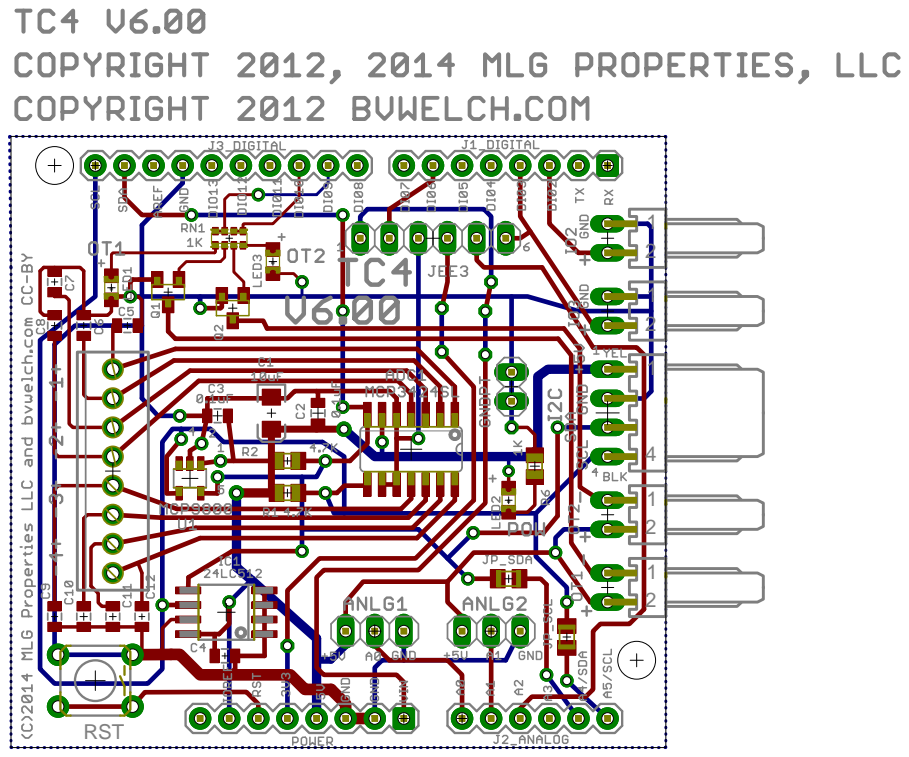
[picture p36: page 1]
RST
