greencardigan/TC4-shield/hardware/TC4C/V1.33/tc4c133-brd.pdf

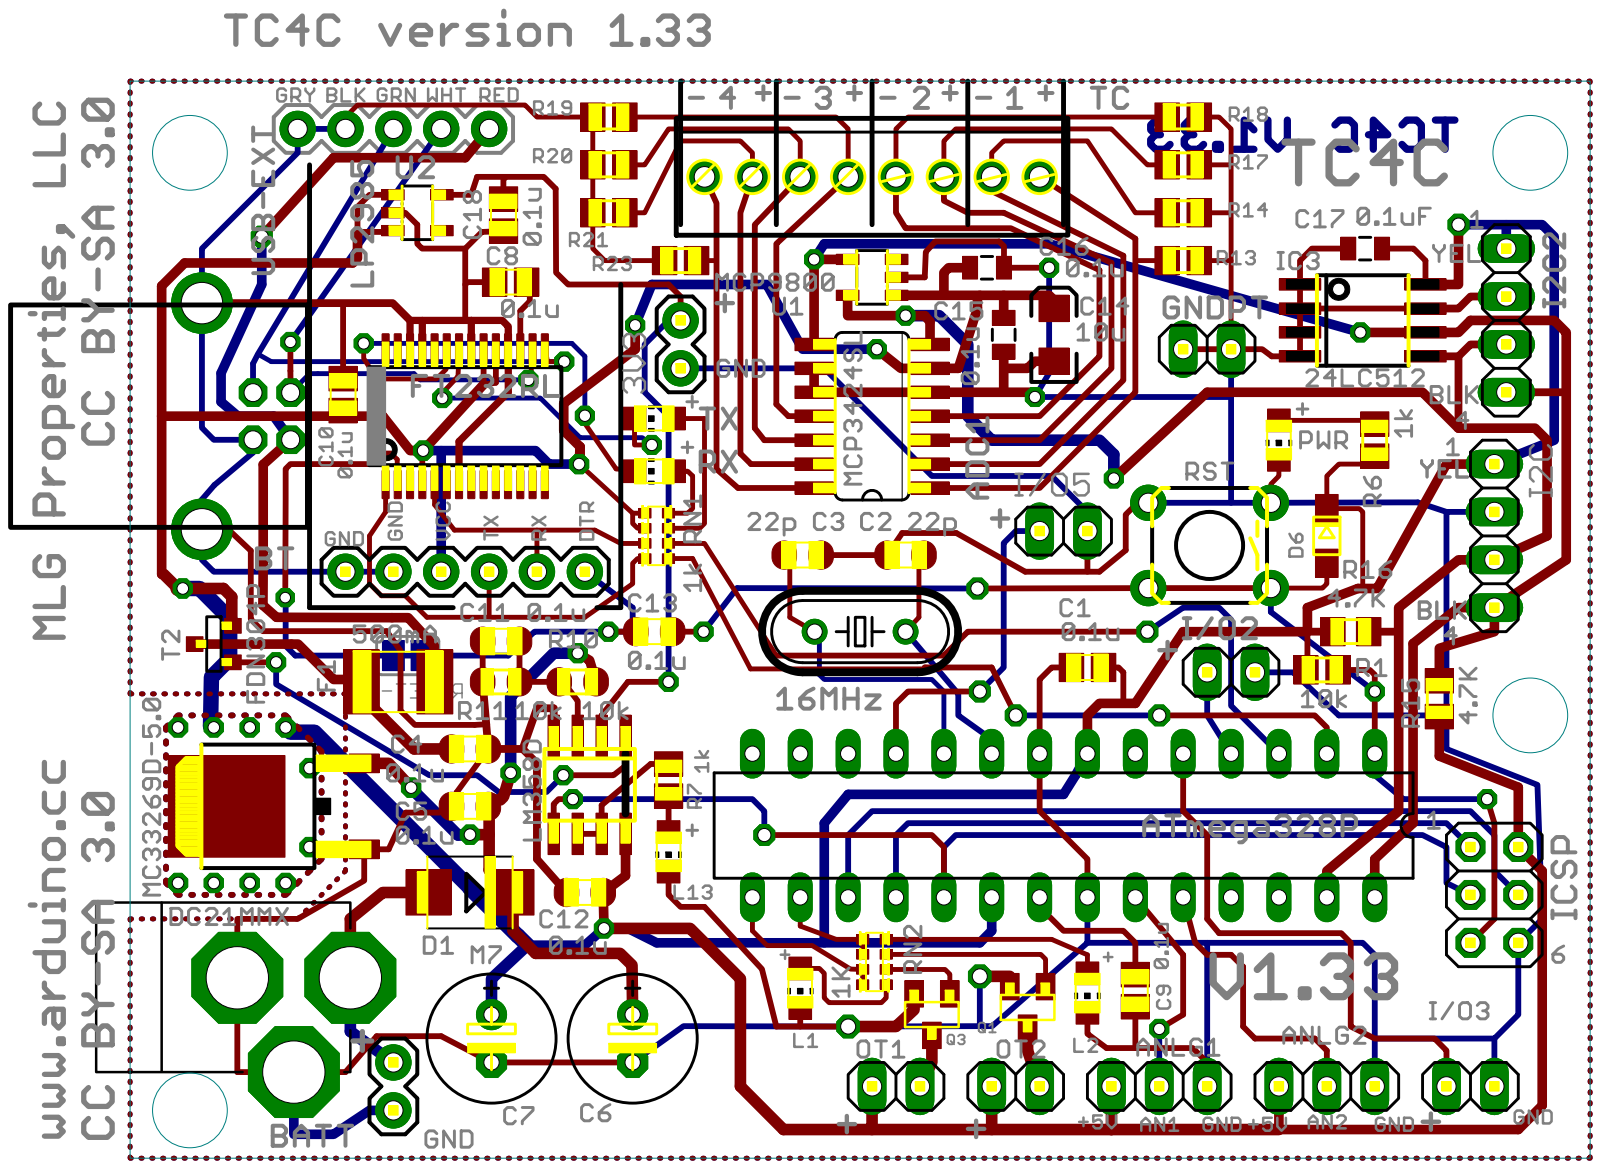
[picture p37: page 1]
