greencardigan/TC4-shield/trunk/hardware/LCDapter/LCD01v200.brd.pdf

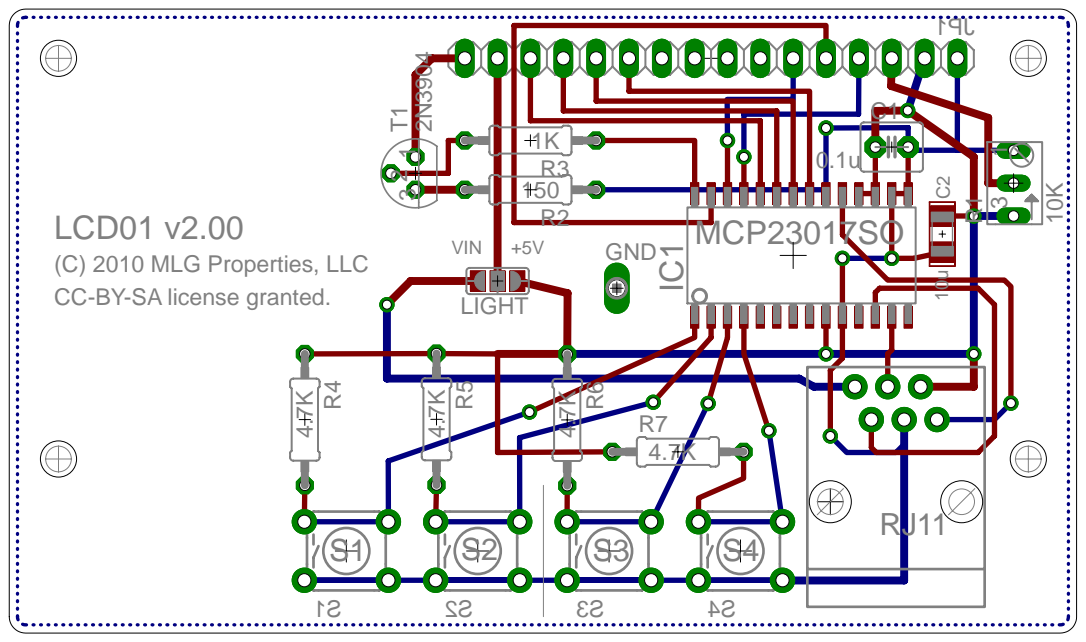
[picture p38: page 1]

LCD01 v2.00
(C) 2010 MLG Properties, LLC
CC-BY-SA license granted.
