greencardigan/TC4-shield/trunk/hardware/LCDapter/LCDapter-330-brd.pdf

## LCDapter v3.3

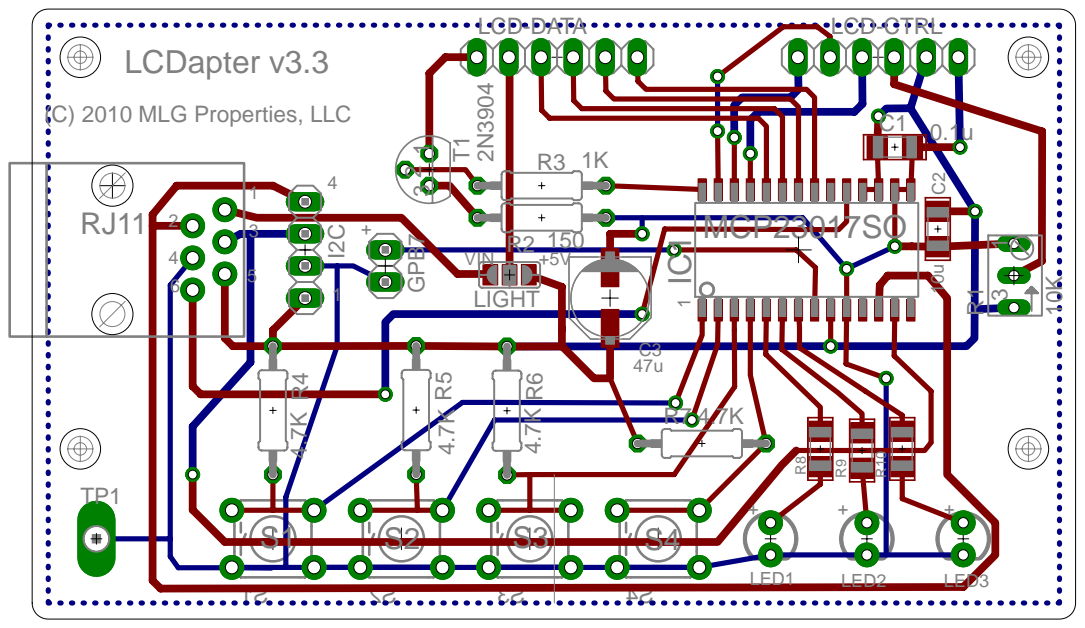
[picture p39: page 1]
