greencardigan/TC4-shield/hardware/TC4C/V1.10/tc4c110-sch.pdf

A

A

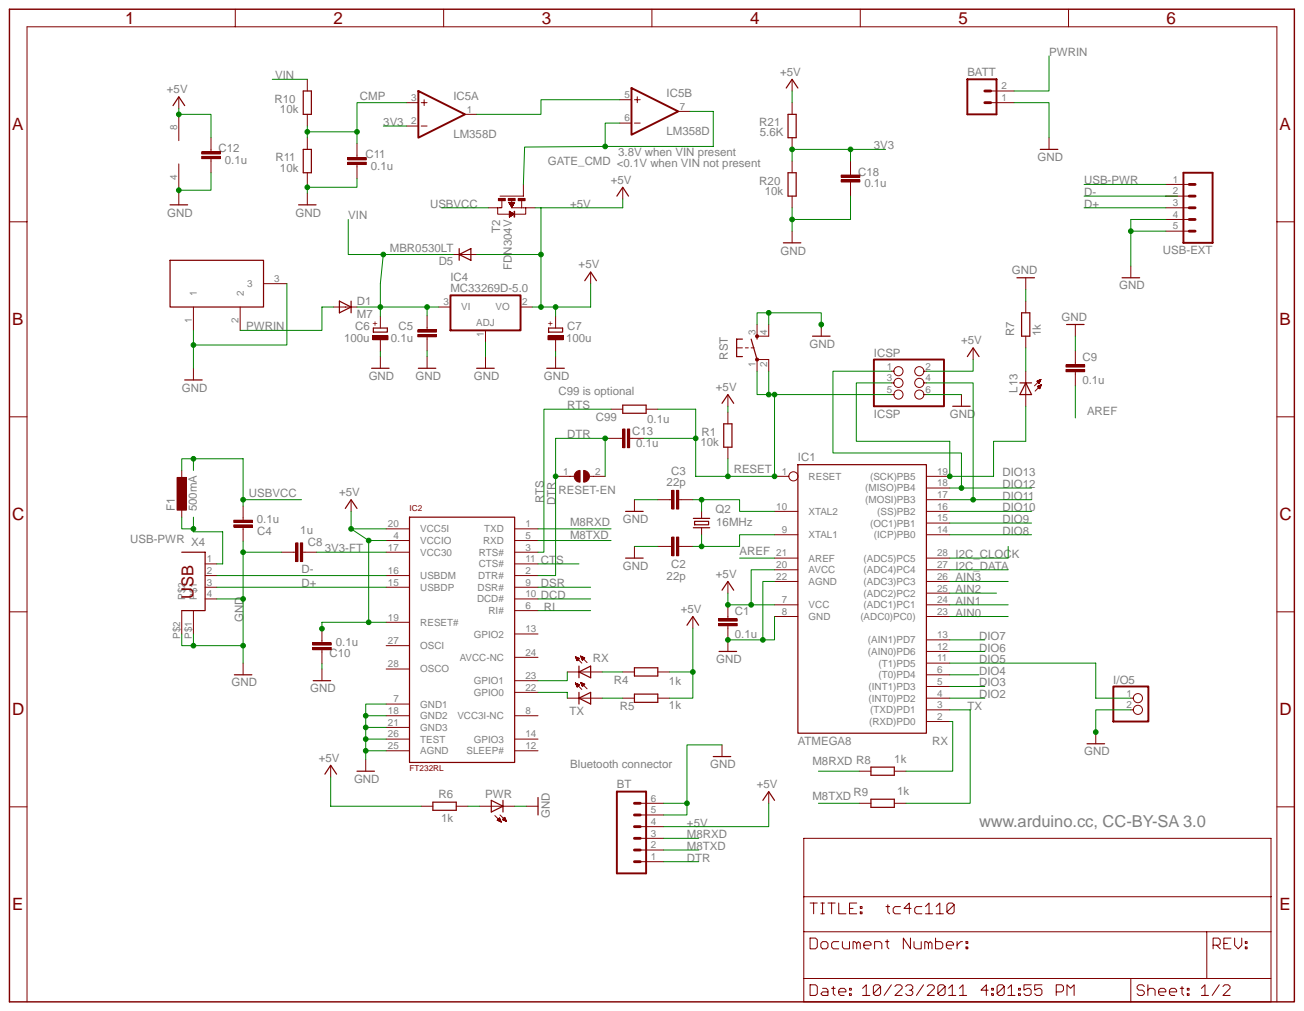
[picture p40: page 1]

3.8V when VIN present <0.1V when VIN not present

www.arduino.cc, CC-BY-SA 3.0

Ambient temp sensor IC | EEPROM
Grounding jumper | I2C header

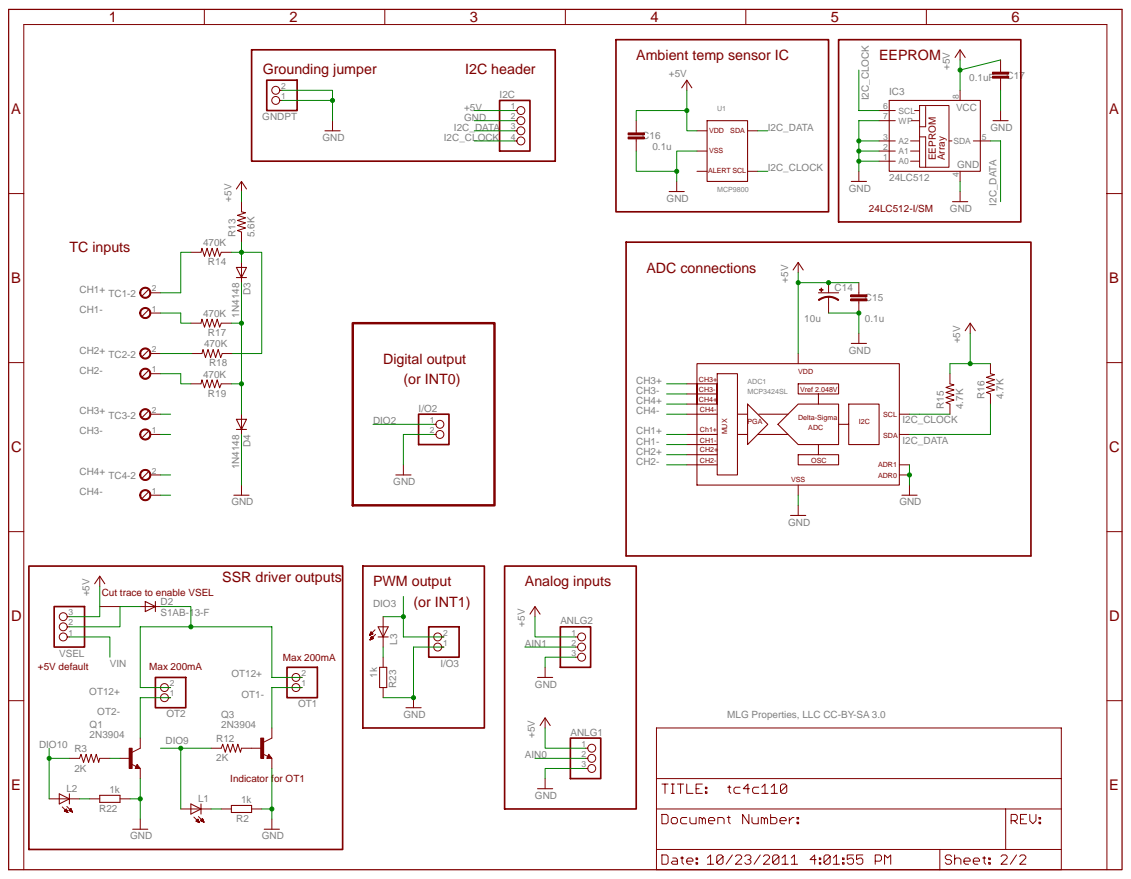
[picture p41: page 2]

Cut trace to enable VSEL

MLG Properties, LLC CC-BY-SA 3.0
