greencardigan/TC4-shield/hardware/TC4C/V1.32/tc4c132-sch.pdf

A

A

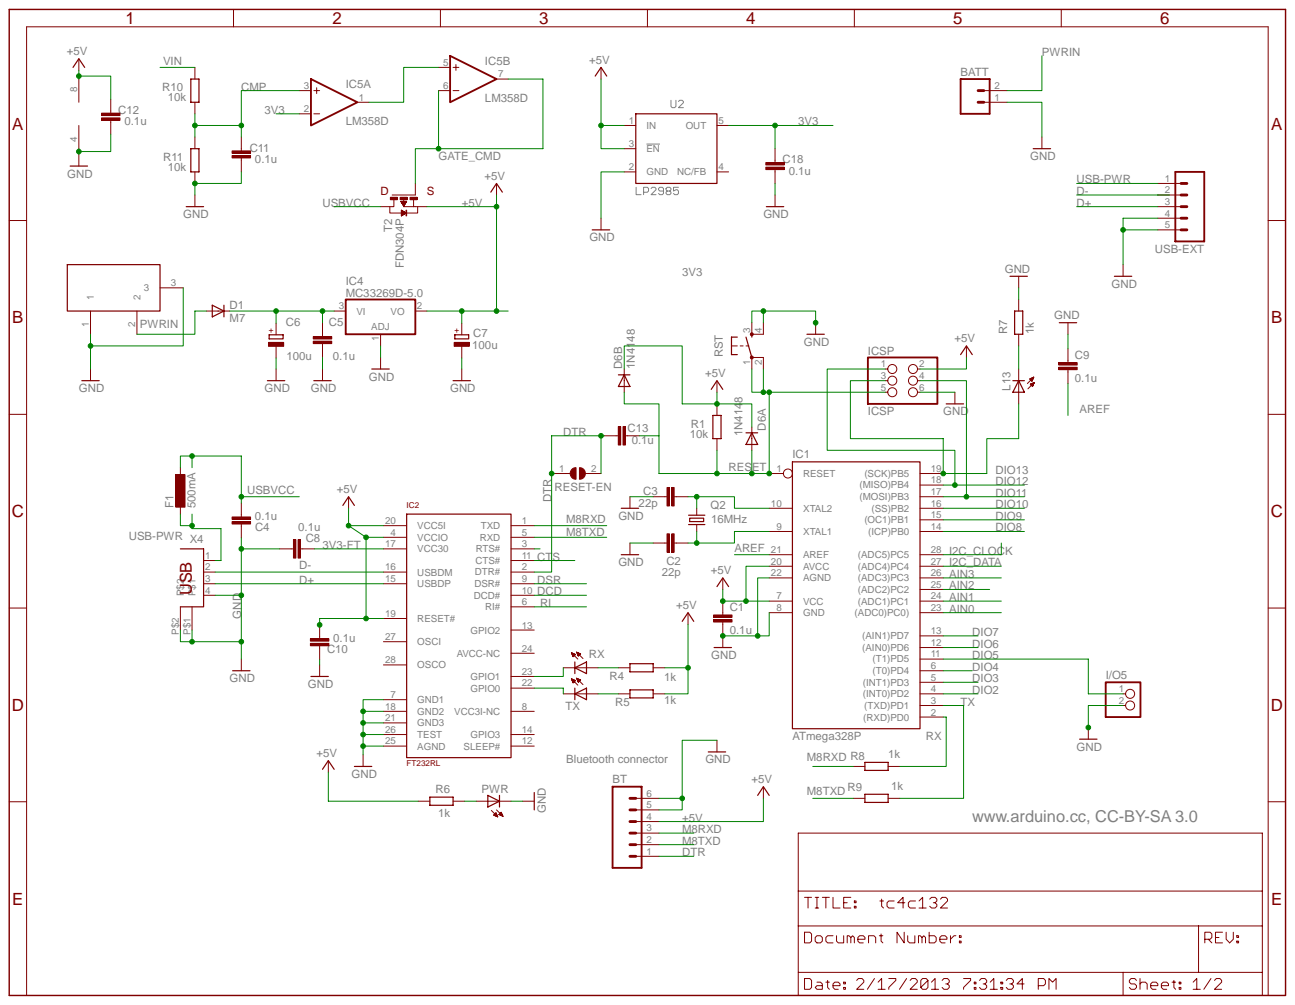
[picture p44: page 1]

www.arduino.cc, CC-BY-SA 3.0

Ambient temp sensor IC | EEPROM
Grounding jumper | I2C header

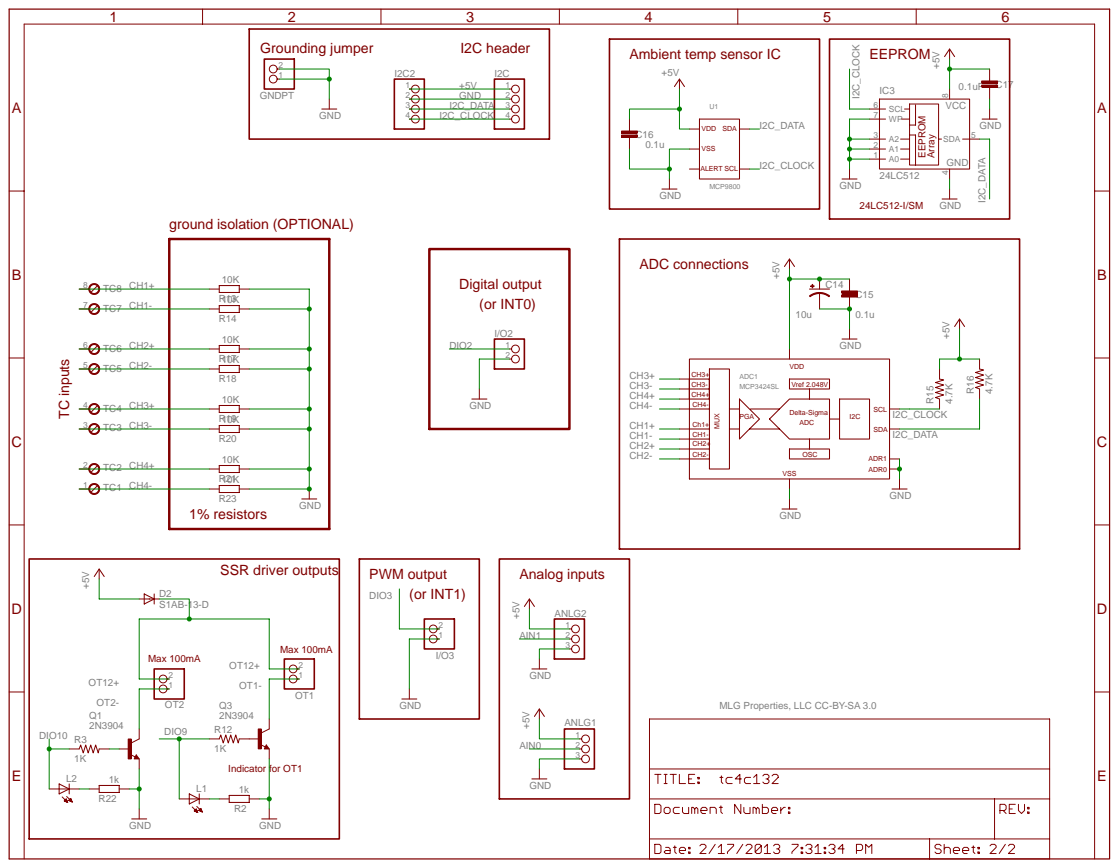
[picture p45: page 2]

MLG Properties, LLC CC-BY-SA 3.0
