greencardigan/TC4-shield/hardware/LCDapter/LCDapterC V121/LCDapterC-121-brd.pdf

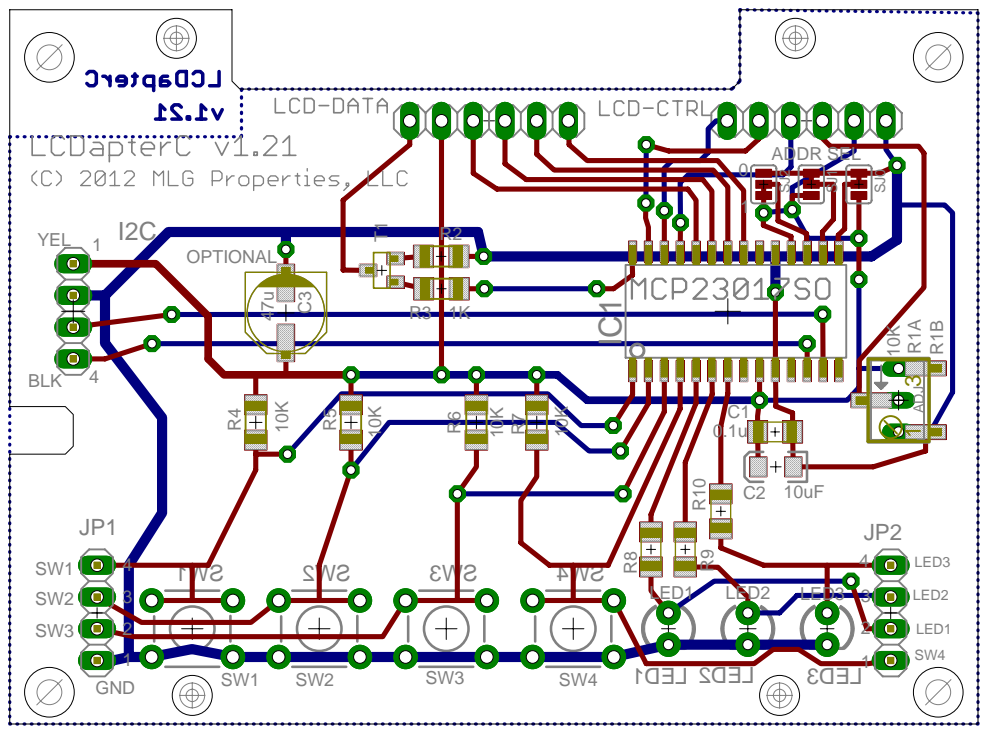
[picture p46: page 1]
