greencardigan/TC4-shield/hardware/TC4/TC4 V520/tc4-controller-0520-brd.pdf

### JEE3

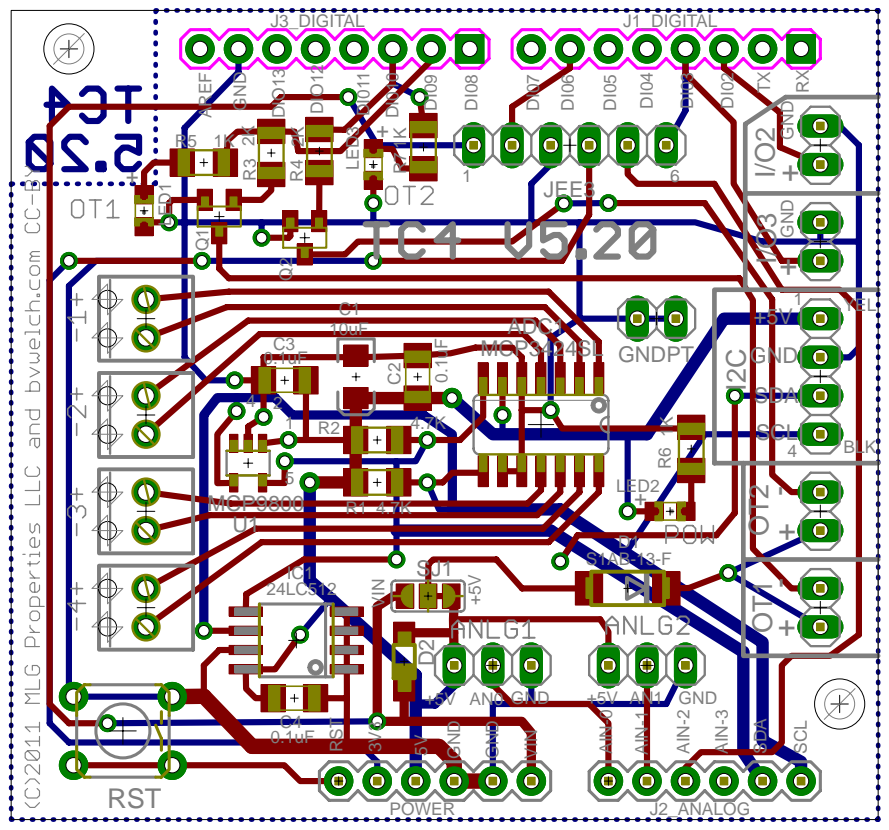
[picture p47: page 1]
