greencardigan/TC4-shield/hardware/TC4/TC4 V530/tc4-controller-0530-brd.pdf

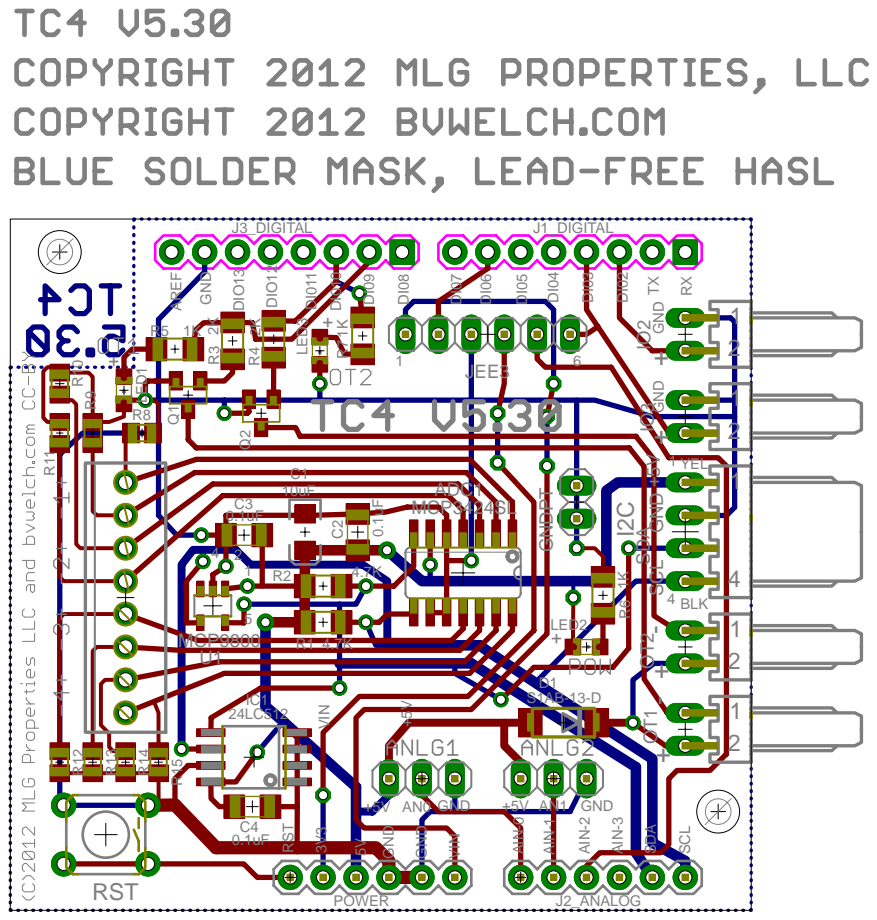
[picture p48: page 1]
