greencardigan/TC4-shield/hardware/TC4/TC4 V531/tc4-controller-0531-brd.pdf

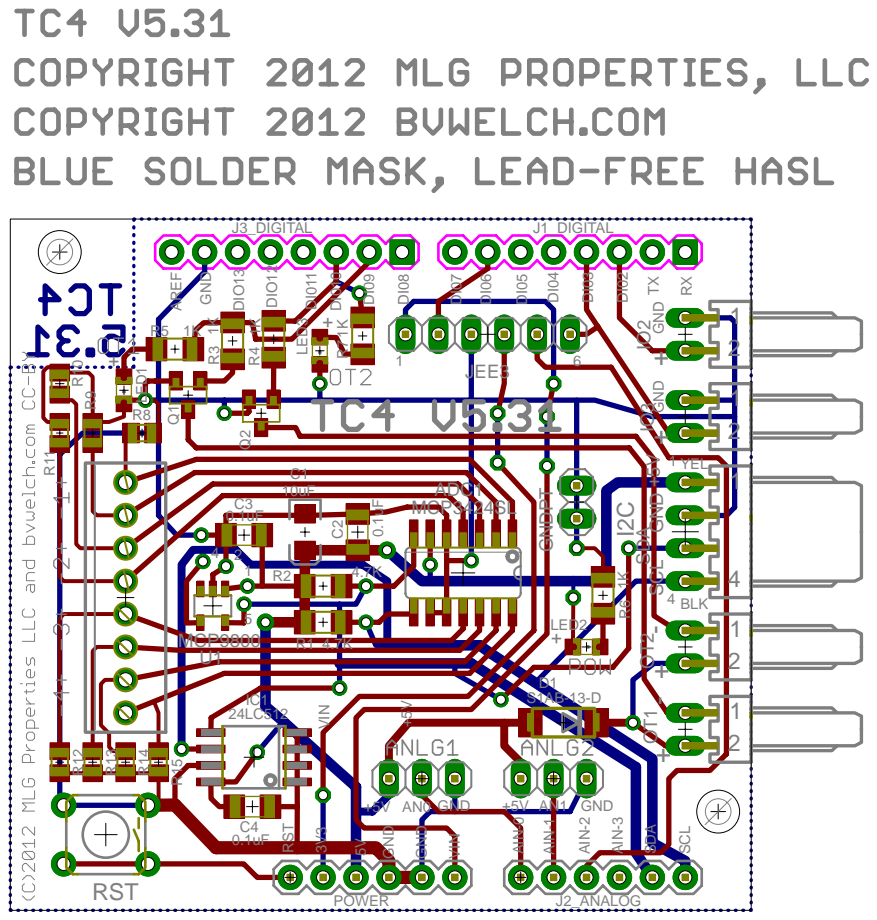
[picture p49: page 1]
