greencardigan/TC4-shield/hardware/TC4C/V1.10/tc4c110-brd.pdf

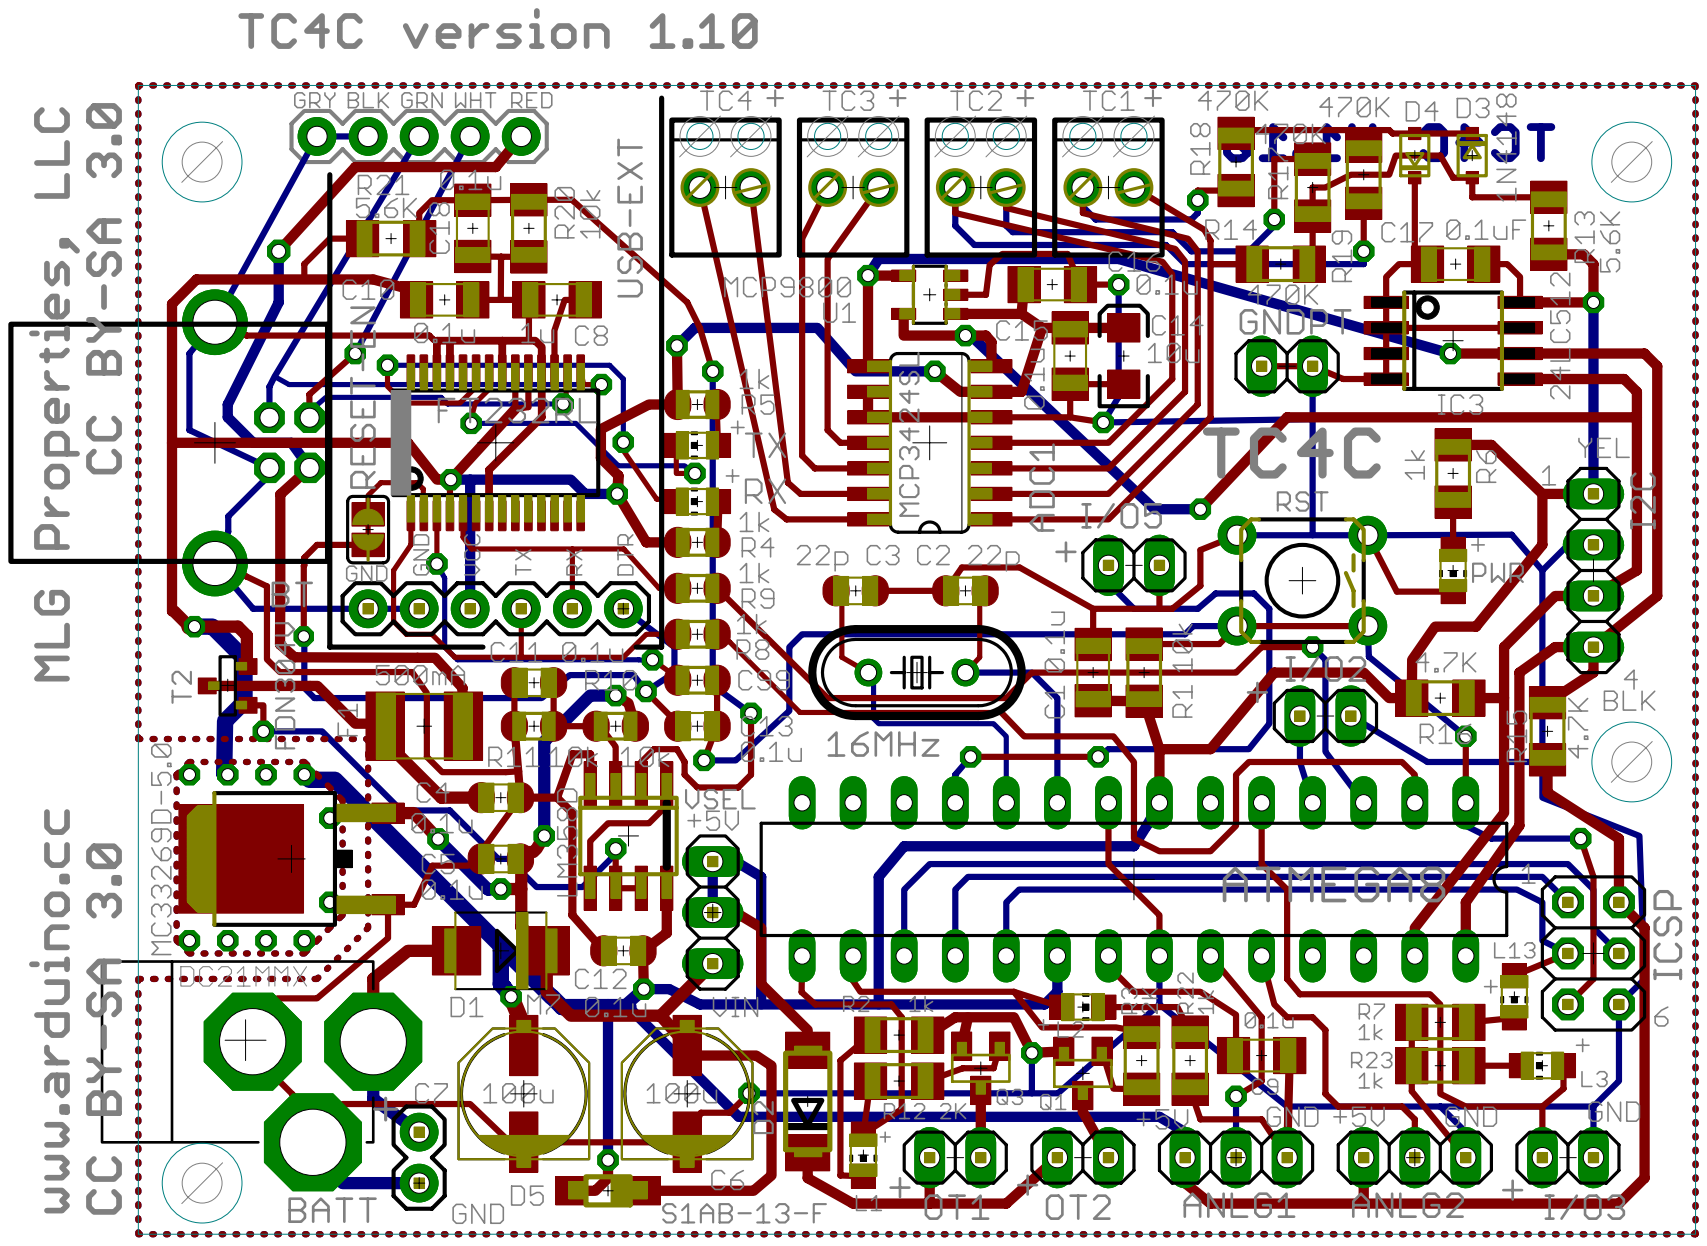
[picture p50: page 1]
