greencardigan/TC4-shield/hardware/TC4C/V1.31/tc4c131-brd.pdf

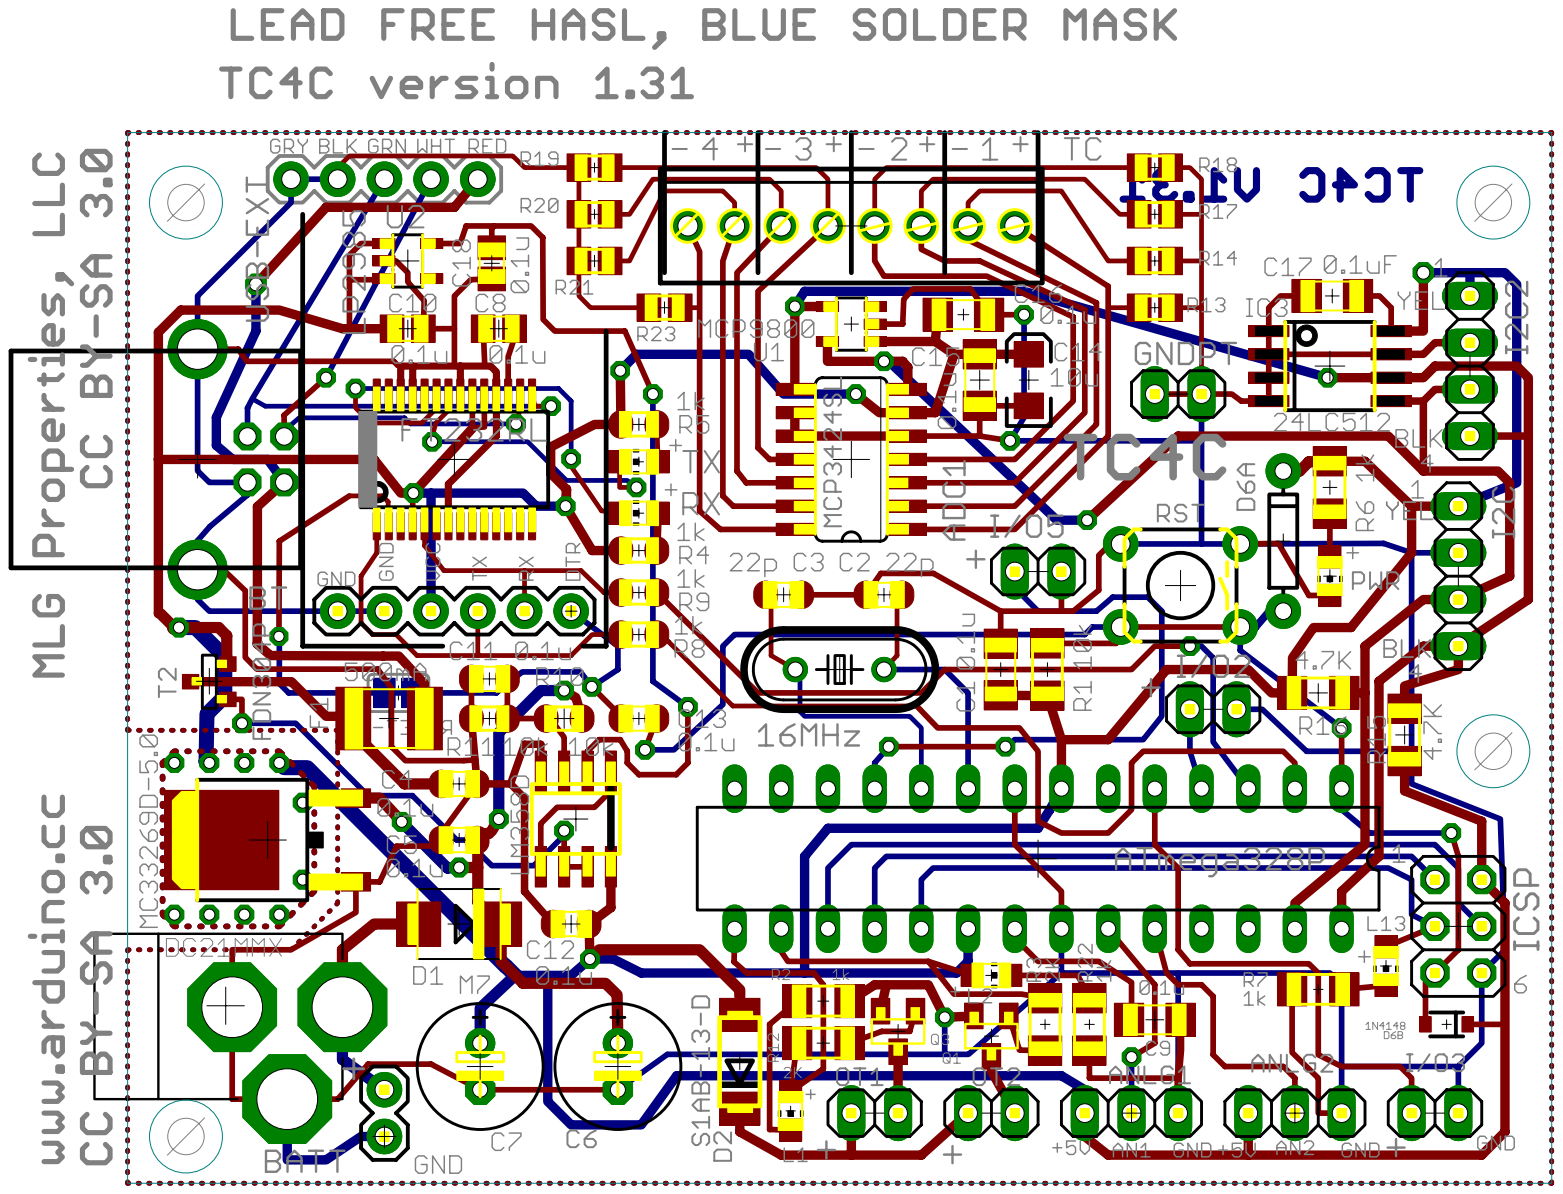
[picture p51: page 1]
