greencardigan/TC4-shield/hardware/TC4C/V1.32/tc4c132-brd.pdf

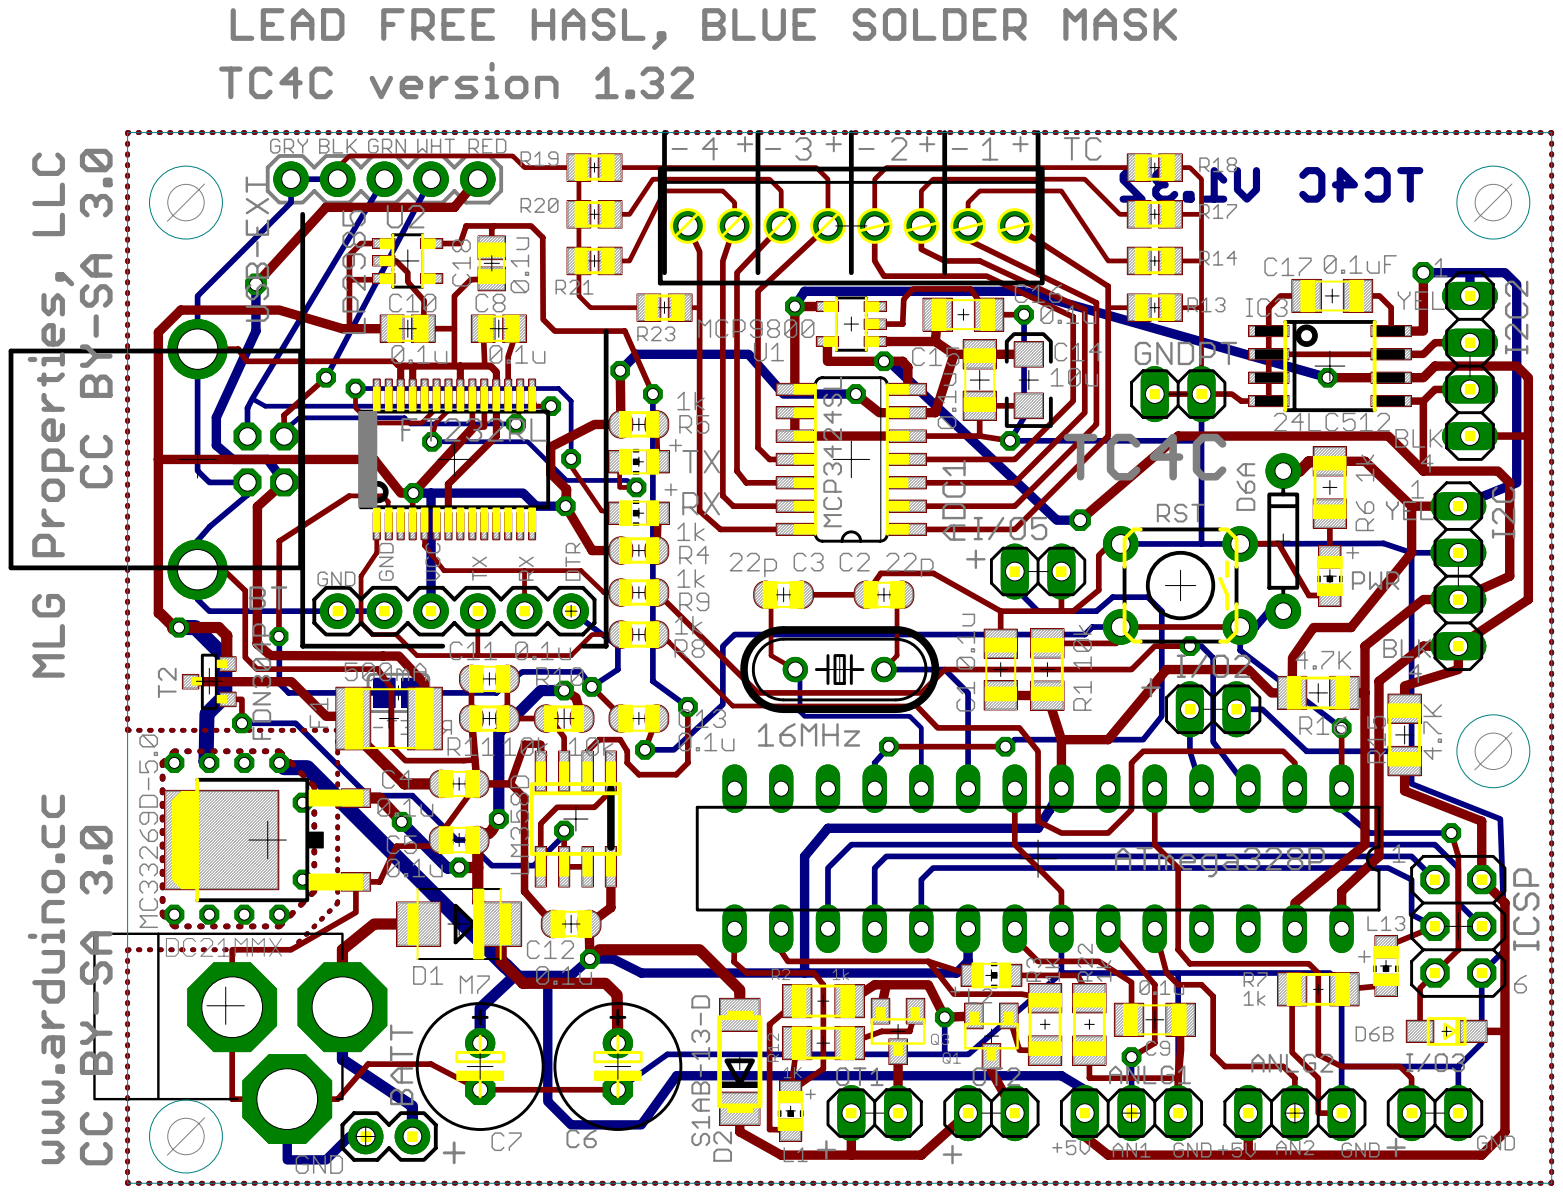
[picture p52: page 1]
