greencardigan/TC4-shield/trunk/hardware/TC4 V106/tc4-controller-01-brd.pdf

J3_DIGITAL | J1_DIGITAL
JP10

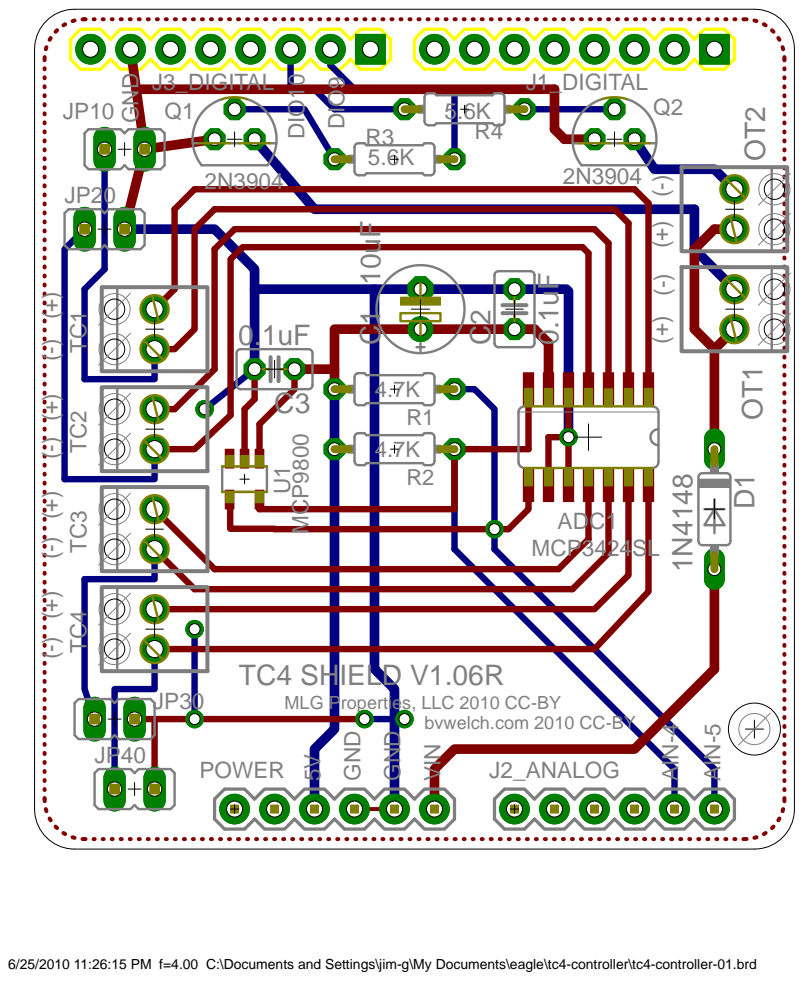
[picture p53: page 1]

TC4 SHIELD V1.06R
MLG Properties, LLC 2010 CC-BY

bvwelch.com 2010 CC-BY VIN
