greencardigan/TC4-shield/trunk/hardware/TC4 V300/tc4-controller-brd-03.pdf

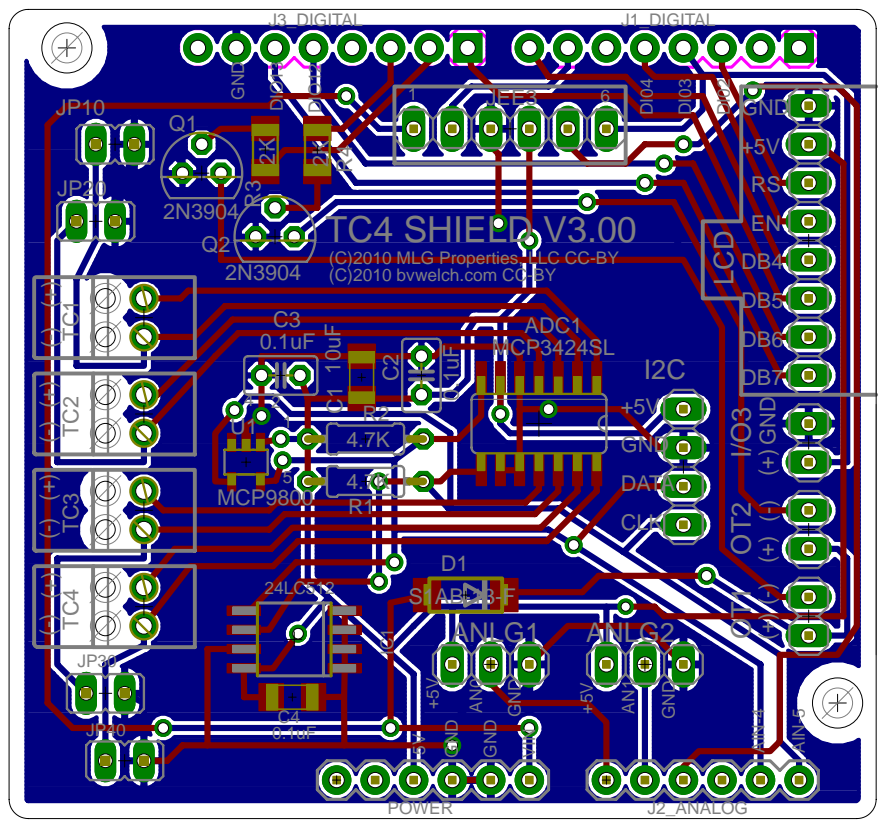
[picture p54: page 1]

(C)2010 MLG Properties, LLC CC-BY
(C)2010 bvwelch.com CC-BY
