greencardigan/TC4-shield/applications/RoastLoggerTC4/tags/REL-2.0/RoastLoggerTC4/RoastLoggerTC4.ino

/********************************************************************************************
 *  RoastLoggerTC4.ino  by GreenBean and Jim Gallt (see revision history below)
 *  
 *  TC4 Arduino sketch for use with Roast Logger by GreenBean http://www.toomuchcoffee.com/
 *  For information on the RoastLogger see:
 * 
 *        http://homepage.ntlworld.com/green_bean/coffee/roastlogger/roastlogger.htm
 *
 *  This version modified to compile/verify on Arduino IDE version 1.0.
 *  Compiles on Arduino Duemilanove 328 and Uno boards.
 *
 *  Based on aBourbon.pde:
 *  Bourbon-REL-300  downloaded from http://code.google.com/p/tc4-shield/downloads/list
 *  Quote
 *  aBourbon, as a standalone application, displays elapsed roast time, ET, BT, and BT-RoR on 
 *  LCD.  When connected to LCDapter board, buttons provide ability to identify 4 roast 
 *  markers (start, first crack, second crack, eject).
 *  Unquote
 *
 *  Modified to be compatible with the Roast Logger and renamed RoastLoggerTC4.pde
 *  Changed baud rate in user.h to 115200
 *  Default output is Celsius - add jumper on ANLG2 to output in Fahrenheit.
 *  Added communication for heater power control for OT1 
 *  Changed serial output to report T1, T2, rorT1, rorT2 and power level.
 *  
 *
 ********************************************************************************************/
/********************************************************************************************

 Please note that you must install the included libraries (in the libraries folder) before 
  the sketch will verify/compile.

  See the "Contributed Libraries" section of http://www.arduino.cc/en/Reference/Libraries
  for details of how to install them.

 ********************************************************************************************/

// *** BSD License ***
// ------------------------------------------------------------------------------------------
// Copyright (c) 2011, 2012, MLG Properties, LLC
// All rights reserved.
//
// Contributor:  Jim Gallt
//
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
//   Neither the name of the MLG Properties, LLC nor the names of its contributors may be 
//   used to endorse or promote products derived from this software without specific prior 
//   written permission.
//
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
//#define LOGIC_ANALYZER 

#define BANNER_RL1 "RoastLoggerTC4"
#define BANNER_RL2 "version 2.0"

// Revision history: - of RoastLoggerTC4
//  20120112:  Version 0.3 - Released for testing
//  20120127:  Version 0.4 - Modified to compile under Arduino IDE 1.0
//  20120312:  Version 0.5 - Modified by Jim Gallt to use standard PWM outputs on OT1 and IO3
//                           Added fan output command capability
//  20120403:  Version 0.6 - Minor modification to logger method to change order of output and clean up RoR output
//  20120425:  Version 0.7 - Select F units using jumper on ANLG2 port (IN -- GND)
//  20120511:  Version 0.8 - Turn fan, heater off by default in setup; 
//                           use 4 sec timebase for heater PWM;
//                           allow mapping of physical input channels;
//                           round heater, fan output levels to nearest 5%;
//                           enable use of LCDapter, if present;
//                           set default filter level to 90% for ambient sensor;
//                           enabled button functions (in standalone mode)
//  20120513   Version 0.9x  Standalone user interface
//  20120516   Version 0.9y  Respond to LOAD command from host (resets timer)
//                           Split LCD display refreshes into two cycles
//  20120517                 Eliminated the banner display delay
//                           Moved hid.refresh() out of logger() and into loop()
//  20120518                 Optimizations for display
//  20120518   Version 1.0b  beta release for firmware with standalone option
//  20120607                 Changed PWM frequency for fan to 7808Hz
//  20120710   Version 2.0   Release supports standalone operation using LCDapter buttons
//                           Set default fan PWM frequency to 61Hz (7808 is too fast for HTC controller)

// This code was adapted from the a_logger.pde file provided
// by Bill Welch.

// The user.h file contains user-definable compiler options
#include "user.h"
#include "basicHID.h" // standard interface

// this library included with the arduino distribution
#include <Wire.h>

// these "contributed" libraries must be installed in your sketchbook's arduino/libraries folder
#include <thermocouple.h>
#include <cADC.h>
#include <PWM16.h>
#include <mcEEPROM.h>
#include <cLCD.h>
#include <cButton.h>

// ------------------------ other compile directives
#define MIN_DELAY 300   // ms between ADC samples (tested OK at 270)
#define NCHAN 2   // number of TC input channels
#define DP 1  // decimal places for output on serial port
#define D_MULT 0.001 // multiplier to convert temperatures from int to float
#define MAX_COMMAND 80 // max length of a command string
#define LOOPTIME 1000 // cycle time, in ms

#define ANLG2 A1 // arduino pin A1
#define UNIT_SEL ANLG2 // select temperature scale

#define CMD_POWER "POWER"
#define CMD_FAN "FAN"
#define CMD_PCCONTROL "PCCONTROL"
#define CMD_ARDUINOCONTROL "ARDUINOCONTROL"
#define CMD_LOAD "LOAD"

#ifdef LOGIC_ANALYZER
#define BLIP_PIN 2  
#endif

// --------------------------------------------------------------
// global variables

mcEEPROM eeprom;
calBlock caldata;

// class objects
cADC adc( A_ADC ); // MCP3424
ambSensor amb( A_AMB ); // MCP9800
filterRC fT[NCHAN]; // filter for displayed/logged ET, BT
filterRC fRise[NCHAN]; // heavily filtered for calculating RoR
filterRC fRoR[NCHAN]; // post-filtering on RoR values
HIDbase hid; // interface

tcBase* tc[NCHAN]; // array of pointers to thermocouples

TC_TYPE1 tc1; // input 1
TC_TYPE2 tc2; // input 2

// arrays to store temperatures, times for each channel
int32_t temps[NCHAN]; //  stored temperatures are divided by D_MULT
int32_t ftemps[NCHAN]; // heavily filtered temps
int32_t ftimes[NCHAN]; // filtered sample timestamps
int32_t flast[NCHAN]; // for calculating derivative
int32_t lasttimes[NCHAN]; // for calculating derivative

// allows choice of TC4 input channels (see user.h for mapping)
uint8_t chan_map[NCHAN] = { LOGCHAN1, LOGCHAN2 };

//RoastLogger global variables for heater, fan power %
int8_t heater; // power for 1st output (heater)
int8_t fan; // power for 2nd output (fan)
PWM16 output1; // 16-bit timer for SSR output on Ot1 and Ot2
PWM_IO3 io3; // 8-bit timer for fan control on IO3

// used in main loop
float timestamp;
boolean first;
uint32_t lastLoop;
uint32_t thisLoop;
float reftime; // reference for measuring elapsed time

// current values are needed globally
float RoR_cur,t1_cur,t2_cur;

// temperature units selection
boolean celsius = true;

char command[MAX_COMMAND+1]; // input buffer for commands from the serial port

#ifdef LOGIC_ANALYZER
uint8_t blip_state;
void blip() {
  digitalWrite( BLIP_PIN, blip_state );
  blip_state = !blip_state;
}
#endif

// T1, T2 = temperatures x 1000
// t1, t2 = time marks, milliseconds
// ---------------------------------------------------
float calcRise( int32_t T1, int32_t T2, int32_t t1, int32_t t2 ) {
  int32_t dt = t2 - t1;
  if( dt == 0 ) return 0.0;  // fixme -- throw an exception here?
  float dT = (T2 - T1) * D_MULT;
  float dS = dt * 0.001; // convert from milli-seconds to seconds
  return ( dT / dS ) * 60.0; // rise per minute
}

// ------------------------------------------------------------------
void logger()
{
  uint8_t i;
  float rx;

  String rorT1,rorT2;

  t1_cur = D_MULT * temps[0];
  t2_cur = D_MULT * temps[1];  

  // print temperature, rate for each channel
  i = 0;
  if( NCHAN >= 1 ) {
    Serial.print("rorT1=");
    RoR_cur = calcRise( flast[i], ftemps[i], lasttimes[i], ftimes[i] );
    RoR_cur = fRoR[i].doFilter( RoR_cur /  D_MULT ) * D_MULT; // perform post-filtering on RoR values
    Serial.println( RoR_cur , DP );
    Serial.print("T1=");
    Serial.println( t1_cur, DP );
    i++;
  };

  if( NCHAN >= 2 ) {
    Serial.print("rorT2=");
    rx = calcRise( flast[i], ftemps[i], lasttimes[i], ftimes[i] );
    rx = fRoR[i].doFilter( rx / D_MULT ) * D_MULT; // perform post-filtering on RoR values
    Serial.println( rx , DP );
    Serial.print("T2=");
    Serial.println( t2_cur, DP );
    i++;
  };

  //print heater power and fan output level 
  Serial.print("Power%=");
  Serial.println(heater);
  Serial.print("Fan=");
  Serial.println(fan);
}

// -------------------------------------
void append( char* str, char c ) { // reinventing the wheel
  int len = strlen( str );
  str[len] = toupper(c);
  str[len+1] = '\0';
}

// -------------------------------------
void processCommand() {  // a newline character has been received, so process the command
  char *val, *c;
  String key = strtok_r(command, "=", &c);
  hid.setSlaveMode(); // disable local user input after first newline character received from serial
  if (key != NULL && key.equals(CMD_POWER)) {
    val = strtok_r(NULL, "=", &c);
    if (val != NULL) {
      heater = atoi(val);   
      // heater = roundOutput( heater );   
      if (heater >= 0 && heater <101) {  
        output1.Out( heater, 0 ); // update the power output on the SSR drive Ot1
      }
    }
  }
  else if (key != NULL && key.equals(CMD_FAN)) {
    val = strtok_r(NULL, "=", &c);
    if (val != NULL) {
      fan = atoi(val); 
      // fan = roundOutput( fan );    
      if (fan >= 0 && fan <101) {  
        float pow = 2.55 * fan;  // output values are 0 to 255
        io3.Out( round( pow ) );   
      }
    }
  }
  else if (key != NULL && key.equals(CMD_PCCONTROL)) { // placeholder
  }
  else if (key != NULL && key.equals(CMD_ARDUINOCONTROL)) { // placeholder
  }
  else if (key != NULL && key.equals(CMD_LOAD)) {
    resetTimer();  // reset the timer in response to message from host
  }
}

// -------------------------------------
void checkSerial() {  // buffer the input from the serial port
  char c;

#ifdef LOGIC_ANALYZER
  blip();
#endif
  
  while( Serial.available() > 0 ) {
    c = Serial.read();
    if( ( c == '\n' ) || ( strlen( command ) == MAX_COMMAND ) ) { // check for newline, or buffer overflow
      processCommand();
      strcpy( command, "" ); // empty the buffer
    } // end if
    else {
      append( command, c );
    } // end else
  } // end while
}

// --------------------------------------------------------------------------
void get_samples() // this function talks to the amb sensor and ADC via I2C
{
  int32_t v;
  float tempC;
  uint32_t tod;

  for( int j = 0; j < NCHAN; j++ ) { // one-shot conversions on both chips
    adc.nextConversion( chan_map[j] ); // start ADC conversion on channel j
    amb.nextConversion(); // start ambient sensor conversion

    // wait for conversions to take place
    tod = millis();
    while( millis() - tod < MIN_DELAY ) {
      checkSerial(); // check for serial input
      HIDevents(); // check for interface events
    }

    ftimes[j] = millis(); // record timestamp for RoR calculations
    amb.readSensor(); // retrieve value from ambient temp register
    v = adc.readuV(); // retrieve microvolt sample from MCP3424
    tempC = tc[j]->Temp_C( 0.001 * v, amb.getAmbC() ); // convert to Celsius
    if( celsius )
      v = round( tempC / D_MULT ); // store results as integers
    else
      v = round( C_TO_F( tempC ) / D_MULT ); // store results as integers
    temps[j] = fT[j].doFilter( v ); // apply digital filtering for display/logging
    ftemps[j] =fRise[j].doFilter( v ); // heavier filtering for RoR
  }
};

// ----------------------------
void resetTimer() {
  reftime = 0.001 * thisLoop; // reset the reference point for timestamp
  return;
}

// ------------------- process interface events (not active when connected to PC)
void HIDevents() {
  if( hid.processEvents() ) { // something changed
    if( hid.resetTimer() )
      resetTimer();
    if( hid.chgLevel_1() ) {
      heater = hid.getLevel_1();
      output1.Out( heater, 0 );
    }
    if( hid.chgLevel_2() ) {
      fan = hid.getLevel_2();
      io3.Out( 2.55* fan ); // output values range from 0 to 255
    }
  }
}

// ------------------------------------------------------------------------
// MAIN
//
void setup()
{
  delay(10); // short delay for startup
  Serial.begin(BAUD); // enable serial right away to avoid buffer overflows

#ifdef LOGIC_ANALYZER
  pinMode( BLIP_PIN, OUTPUT );
#endif

  lastLoop = millis();
  Wire.begin(); 

  // initialize values
  heater = 0;
  fan = 0;
  t1_cur = 0.0;
  t2_cur = 0.0;
  RoR_cur = 0.0;
  
// initialize the display/input device
  hid.begin( 16, 2, 4 ); // default is 16 x 2 LCD with 4 buttons
  hid.backlight();
  hid.setCursor( 0, 0 );
  hid.print( BANNER_RL1 ); // program name
  hid.setCursor( 0, 1 );
  hid.print( BANNER_RL2 ); // version
  hid.ledAllOff();

  amb.init( AMB_FILTER );  // initialize ambient temp filtering

  // read calibration and identification data from eeprom
  if( readCalBlock( eeprom, caldata ) ) {
    Serial.println("# EEPROM data read: ");
    Serial.print("# ");
    Serial.print( caldata.PCB); Serial.print("  ");
    Serial.println( caldata.version );
    Serial.print("# ");
    Serial.print( caldata.cal_gain, 4 ); Serial.print("  ");
    Serial.println( caldata.K_offset, 2 );
    adc.setCal( caldata.cal_gain, caldata.cal_offset );
    amb.setOffset( caldata.K_offset );
  }
  else { // if there was a problem with EEPROM read, then use default values
    Serial.println("# Failed to read EEPROM.  Using default calibration data. ");
    adc.setCal( CAL_GAIN, UV_OFFSET );
    amb.setOffset( AMB_OFFSET );
  }   

  fT[0].init( BT_FILTER ); // digital filtering on BT
  fT[1].init( ET_FILTER ); // digital filtering on ET
  fRise[0].init( RISE_FILTER ); // digital filtering for RoR calculation
  fRise[1].init( RISE_FILTER ); // digital filtering for RoR calculation
  fRoR[0].init( ROR_FILTER ); // post-filtering on RoR values
  fRoR[1].init( ROR_FILTER ); // post-filtering on RoR values

  tc[0] = &tc1; // allow different thermocouple types on outputs
  tc[1] = &tc2;
  
  output1.Setup( TIME_BASE );
  output1.Out( heater, 0 ); // heater is off by default
  
  io3.Setup( PWM_MODE, PWM_PRESCALE );
  io3.Out( fan ); // fan is off by default
  
  // set up ANLG2 input pin for temperature units selection
  pinMode( UNIT_SEL, INPUT );
  digitalWrite( UNIT_SEL, HIGH ); // enable pullup
  
  first = true;
}

// -----------------------------------------------------------------
void loop() {
  float idletime;

  checkSerial();
  HIDevents();
  thisLoop = millis();

  if( thisLoop - lastLoop >= LOOPTIME ) { // time to take another sample
    celsius = digitalRead( UNIT_SEL ) == HIGH;  // use jumper to drive low and select fahrenheit
    if( first )
      resetTimer();
    lastLoop += LOOPTIME;
    timestamp = 0.001 * float( thisLoop ) - reftime; // system time, seconds, for this set of samples
    get_samples(); // retrieve values from MCP9800 and MCP3424
    if( first ) { // use first samples for RoR base values only
      first = false;
    }
    else {
      logger(); // output results to serial port
    }
    hid.refresh( t1_cur, t2_cur, RoR_cur, timestamp, heater, fan ); // updates values for display

    for( int j = 0; j < NCHAN; j++ ) {
      flast[j] = ftemps[j]; // use previous values for calculating RoR
      lasttimes[j] = ftimes[j];
    }

    idletime = LOOPTIME - ( millis() - thisLoop );
    // arbitrary: complain if we don't have at least 50mS left
    if (idletime < 50 ) {
      Serial.print("# idle: ");
      Serial.println(idletime);
    }
  }
}
