greencardigan/TC4-shield/applications/Gesha/aGesha/trunk/src/aGesha.pde

// aGesha.pde
//
// 'fork' of aCatuai by Jim Gallt

// 2-channel Rise-o-Meter and manual roast controller
// output on serial port:  timestamp, BT, ET, RoR, juice
// output on LCD :
//                  0123456789012345
//                  09:30 R+08 120.7
//                  BT 400F  ET 460F
//                  0123456789012345

// Support for pBourbon.pde and 16 x 2 LCD
// MIT license: http://opensource.org/licenses/mit-license.php
// Jim Gallt and Bill Welch
// Derived from aCatuai.pde by Jim Gallt
// Derived from aBourbon.pde by Jim Gallt and Bill Welch
// Originally adapted from the a_logger.pde by Bill Welch.

#define BANNER_G "aGesha 20110323" // version

// this library included with the arduino distribution
#include <Wire.h>

// these "contributed" libraries must be installed in your sketchbook's arduino/libraries folder
#include <TypeK.h>
#include <cADC.h>
//#include <PWM16.h>
#include <cLCD.h>
#include <cButton.h>
// #include <mcEEPROM.h>

// *************************************************************************************
// NOTE TO USERS: the following parameters should be
// be reviewed to suit your preferences and hardware setup.  
// First, load and edit this sketch in the Arduino IDE.
// Next compile the sketch and upload it to the Duemilanove.

// ------------------ optionally, use I2C port expander for LCD interface
#define I2C_LCD //comment out to use the standard parallel LCD 4-bit interface

#define BAUD 57600  // serial baud rate
#define BT_FILTER 10 // filtering level (percent) for displayed BT
#define ET_FILTER 10 // filtering level (percent) for displayed ET
#define JUICE_FILTER 95 // filtering level (percent) for juice reading

// use RISE_FILTER to adjust the sensitivity of the RoR calculation
// higher values will give a smoother RoR trace, but will also create more
// lag in the RoR value.  A good starting point is 70%, but for air poppers
// or other roasters where BT might be jumpy, then a higher value of RISE_FILTER
// will be needed.  Theoretical max. is 99%, but watch out for the lag when
// you get above 85%.
#define RISE_FILTER 90 // heavy filtering on non-displayed BT for RoR calculations
#define ROR_FILTER 90 // post-filter

// future versions will read all calibration values from EEPROM
#define CAL_GAIN 1.00 // substitute known gain adjustment from calibration
#define UV_OFFSET 0 // subsitute known value for uV offset in ADC
#define AMB_OFFSET 0 // substitute known value for amb temp offset (Celsius)

// ambient sensor should be stable, so quick variations are probably noise -- filter heavily
#define AMB_FILTER 85 // filtering on ambient sensor readings

#define JUICE_LOSS 2.81 // lump constant for losses -- full-wave bridge, I-squared-R, etc.

// *************************************************************************************


// ------------------------ other compile directives
#define MIN_DELAY 300   // ms between ADC samples (tested OK at 270)
#define NCHAN 2   // number of TC input channels
#define TC_TYPE TypeK  // thermocouple type / library
#define DP 1  // decimal places for output on serial port
#define D_MULT 0.001 // multiplier to convert temperatures from int to float

// --------------------------------------------------------------
// global variables

// class objects
cADC adc( A_ADC ); // MCP3424
ambSensor amb( A_AMB ); // MCP9800
filterRC fT[NCHAN]; // filter for displayed/logged ET, BT
filterRC fRise[NCHAN]; // heavily filtered for calculating RoR
filterRC fjuice;
filterRC fRoR;

int32_t temps[NCHAN]; //  stored temperatures are divided by D_MULT
int32_t ftemps[NCHAN]; // heavily filtered temps
int32_t ftimes[NCHAN]; // filtered sample timestamps
int32_t flast[NCHAN]; // for calculating derivative
int32_t lasttimes[NCHAN]; // for calculating derivative

int32_t aval = 0; // analog input value -- juice
uint8_t juice_pin = 1; // analog input pin
float juice = 0.0;

// LCD output strings
char smin[3],ssec[3],st1[6],st2[6],sRoR1[7];

// ---------------------------------- LCD interface definition
#ifdef I2C_LCD

#define BACKLIGHT lcd.backlight();
cLCD lcd; // I2C LCD interface
cButtonPE16 buttons; // button array on I2C port expander

#else

#define BACKLIGHT ;
#define RS 2
#define ENABLE 4
#define D4 7
#define D5 8
#define D6 12
#define D7 13
LiquidCrystal lcd( RS, ENABLE, D4, D5, D6, D7 ); // standard 4-bit parallel interface

#endif

// used in main loop
float timestamp = 0;
uint32_t time0 = 0;  // ms value when we want to start recording
boolean first;
uint32_t nextLoop;

// declarations needed to maintain compatibility with Eclipse/WinAVR/gcc
void updateLCD( float t1, float t2, float RoR );
void resetTimer();

// --------------------------------------------------- returns RoR
// T1, T2 = temperatures x 1000
// t1, t2 = time marks, milliseconds
float calcRise( int32_t T1, int32_t T2, int32_t t1, int32_t t2 ) {
  int32_t dt = t2 - t1;
  if( dt == 0 ) return 0.0;  // fixme -- throw an exception here?
  float dT = (T2 - T1) * D_MULT;
  float dS = dt * 0.001;
  return fRoR.doFilter( dT / dS * 1000.) * .060; // rise per minute (doFilter is integer)
}

// ------------------------------------------------------------------
void logger()
{
  float RoR,t1,t2;

  // print timestamp from when samples were taken
  Serial.print( timestamp, DP );
  Serial.print(",");

  // BT
  Serial.print( t1 = D_MULT*temps[0], DP );
  Serial.print(",");
  
  // ET
  Serial.print( t2 = D_MULT * temps[1], DP );
  Serial.print(",");

  RoR = calcRise( flast[0], ftemps[0], lasttimes[0], ftimes[0] );
  Serial.print( RoR , DP );
  Serial.print(",");
  
  Serial.print( juice, DP );
  Serial.println();

  updateLCD( t1, t2, RoR, juice );  
};

// --------------------------------------------
//  Farmroast's preferred layout
//  16x2 layout
//  0123456789012345
//  09:30 R+08 120.7
//  BT 400F  ET 460F
//  0123456789012345
void updateLCD( float t1, float t2, float RoR, float juice ) {
  // form the timer output string in min:sec format
  int itod = round( timestamp );
  if( itod > 3599 ) itod = 3599;
  sprintf( smin, "%02u", itod / 60 );
  sprintf( ssec, "%02u", itod % 60 );
  lcd.setCursor(0,0);
  lcd.print( smin );
  lcd.print( ":" );
  lcd.print( ssec );

#if 1
  // channel 2 "ET" temperature 
  int it02 = round( t2 );
  if( it02 > 999 ) it02 = 999;
  else if( it02 < -999 ) it02 = -999;
  sprintf( st2, "%3d", it02 );
  lcd.setCursor( 9, 1 );
  lcd.print( "ET " );
  lcd.print( st2 ); 
  lcd.print( "F" );

  // channel 1 "BT" RoR
  int iRoR = round( RoR );
  if( iRoR > 99 ) 
    iRoR = 99;
  else
   if( iRoR < -99 ) iRoR = -99; 
  sprintf( sRoR1, "%0+3d", iRoR );
  lcd.setCursor(6,0);
  lcd.print( "R");
  lcd.print( sRoR1 );

  // channel 1 "BT" temperature
  int it01 = round( t1 );
  if( it01 > 999 ) 
    it01 = 999;
  else
    if( it01 < -999 ) it01 = -999;
  sprintf( st1, "%3d", it01 );
  lcd.setCursor( 0, 1 );
  lcd.print("BT ");
  lcd.print(st1);
  lcd.print("F");

// juice
  lcd.setCursor(11,0);
  lcd.print( juice, DP );

#else
// diagnostic
  lcd.setCursor(0,1);
  sprintf( st1, "%3d", aval );
  lcd.print(st1);
  lcd.setCursor( 11, 1 );
  lcd.print( juice, DP );
#endif
}

// ---------------------------------

/*

The readjuice() routine is closely tied to the circuit (see juice_monitor-1.jpg).
If you modify the circuit, you will almost certainly need to modify this routine.

The circuit uses a transformer with a 10:1 turns ratio, so, for example,  100 VAC 
on the variac equals 10 VAC on the transformer output.

The full-wave rectifier is heavily filtered, and so the output is roughly Vpeak,
minus the losses from the full-wave bridge -- diode voltage drop, etc.

In my system, the maximum variac output is 140 VAC, so the maximum transformer
output is 14 VAC, but note this is approximately 20 Vpeak.

The Arduino's ADC (analog input pin) is limited to 5 volts max -- we must be very
careful never to exceed this, especially at the maximum setting of the variac.

The multi-turn pot divides down the output to 1/4 of full-scale, to make sure the
ADC pin does not exceed 5 volts.

In the equation, we scale the 0-1023 reading to 0-5 volts. Then we multiply by 4
to compensate for the 1/4 setting of the trim pot.

JUICE_LOSS takes into account the losses in the full-wave bridge -- diode voltage
drop, etc.

The " * 10. " takes into account the turns ratio (FIXME: we should not hard-code this)

Finally the 1.414 converts from Vpeak to VAC (RMS)

*/

void readjuice() {
  aval = analogRead( juice_pin );
  aval = fjuice.doFilter( aval );
  juice = (( float(aval) * 5./1024. * 4.) + JUICE_LOSS) * 10. / 1.414;
}

#ifdef I2C_LCD
// ----------------------------------
void checkButtons() { // take action if a button is pressed
  if( buttons.readButtons() ) {
    if( buttons.keyPressed( 3 ) && buttons.keyChanged( 3 ) ) {// left button = start the roast
      resetTimer();
      Serial.println( "# STRT (timer reset)");
    }
    else if( buttons.keyPressed( 2 ) && buttons.keyChanged( 2 ) ) { // 2nd button marks first crack
      resetTimer();
      Serial.println( "# FC (timer reset)");
    }
    else if( buttons.keyPressed( 1 ) && buttons.keyChanged( 1 ) ) { // 3rd button marks second crack
      resetTimer();
      Serial.println( "# SC (timer reset)");
    }
    else if( buttons.keyPressed( 0 ) && buttons.keyChanged( 0 ) ) { // 4th button marks eject
      resetTimer();
      Serial.println( "# EJCT (timer reset)");
    }
  }
}
#endif

// ----------------------------------
void checkStatus( uint32_t ms ) { // this is an active delay loop
  uint32_t tod = millis();
  while( millis() < tod + ms ) {
    readjuice();
#ifdef I2C_LCD
    checkButtons();
#endif
  }
}

// --------------------------------------------------------------------------
void get_samples() // this function talks to the amb sensor and ADC via I2C
{
  int32_t v;
  TC_TYPE tc;
  float tempC;
  
  for( int j = 0; j < NCHAN; j++ ) { // one-shot conversions on both chips
    // workaround for bad chan0
    if (j == 0) {
      adc.nextConversion( 2 ); // start ADC conversion on channel 2
    } else {
      adc.nextConversion( j ); // start ADC conversion on channel j
    }
    amb.nextConversion(); // start ambient sensor conversion
    checkStatus( MIN_DELAY ); // give the chips time to perform the conversions
    ftimes[j] = millis(); // record timestamp for RoR calculations
    amb.readSensor(); // retrieve value from ambient temp register
    v = adc.readuV(); // retrieve microvolt sample from MCP3424
    tempC = tc.Temp_C( 0.001 * v, amb.getAmbC() ); // convert to Celsius
    v = round( C_TO_F( tempC ) / D_MULT ); // store results as integers
    temps[j] = fT[j].doFilter( v ); // apply digital filtering for display/logging
    ftemps[j] =fRise[j].doFilter( v ); // heavier filtering for RoR
  }
};
  
// resets the timestamp origin
void resetTimer() {
  time0 = millis();
  timestamp = 0.0;
  nextLoop = 1000;
}

// ------------------------------------------------------------------------
// MAIN
//
void setup()
{
  delay(100);
  Wire.begin(); 
  lcd.begin(16, 2);
  BACKLIGHT;
  lcd.setCursor( 0, 0 );
  lcd.print( BANNER_G ); // display version banner
#ifdef I2C_LCD
  buttons.begin( 4 );
  buttons.readButtons();
#endif

  Serial.begin(BAUD);

  adc.setCal( CAL_GAIN, UV_OFFSET );
  amb.setOffset( AMB_OFFSET );

  // write header to serial port
  Serial.print("# ");
  Serial.println(BANNER_G);
  Serial.println("# time, BT, ET, RoR, juice");
 
  amb.init( AMB_FILTER );  // initialize ambient temp filtering
  for( int j = 0; j < NCHAN; j++ ) { // initialize digital filters for each channel
    if( j == 1 )
      fT[j].init( ET_FILTER ); // special value for channel 2 (ET)
    else
      fT[j].init( BT_FILTER ); // digital filtering on BT
    fRise[j].init( RISE_FILTER ); // digital filtering for RoR calculation
  }

  fjuice.init(JUICE_FILTER);
  fRoR.init(ROR_FILTER);

  first = true;
  delay( 3000 ); // display banner for a while
  lcd.clear();
  resetTimer();
}

// -----------------------------------------------------------------
void loop() {
  float idletime;

  // update on even 1 second boundaries
  while ( ( millis() - time0 ) < nextLoop ) { // delay until time for next loop
    if( !first ) {
      readjuice();
#ifdef I2C_LCD
      checkButtons();
#endif
    }
  }
  
  nextLoop += 1000; // time mark for start of next update 
  timestamp = float( millis() - time0 ) * 0.001;
  get_samples(); // retrieve values from MCP9800 and MCP3424
  if( first ) // use first samples for RoR base values only
    first = false;
  else {
    logger(); // output results to serial port
  }

  for( int j = 0; j < NCHAN; j++ ) {
   flast[j] = ftemps[j]; // use previous values for calculating RoR
   lasttimes[j] = ftimes[j];
  }

  idletime = float( millis() - time0 ) * 0.001;
  idletime = 1.0 - (idletime - timestamp);
  // arbitrary: complain if we don't have at least 10mS left
  if (idletime < 0.010) {
    Serial.print("# idle: ");
    Serial.println(idletime);
  }

}
