greencardigan/TC4-shield/trunk/hostsoftware/p_logger/p_logger.pde

// Title: Datalogger and real-time display
// Author: William Welch Copyright (c) 2009, all rights reserved.
// MIT license: http://opensource.org/licenses/mit-license.php
// Inspired by Tom Igoe's Grapher Pro: http://www.tigoe.net/pcomp/code/category/Processing/122
// and Tim Hirzel's BCCC Plotter: http://www.arduino.cc/playground/Main/BBCCPlotter

// version 0.5  1 July 2010

String logfilename = "roast_" + year()+"_"+month()+"_"+day()+"_"+hour()+"_"+minute()+"_"+second()+".csv";
PrintWriter logfile;

String PROFILE = "myprofile.csv";
String profile_data[];
String kb_note = "";
int whichport = -1;
int baudrate = 57600;
import processing.serial.*;
Serial comport;
String error_msg;

int MAX_TEMP = 500; // fixme: support both F and C on plots.
int MAX_TIME = 1200;
// int MAX_TEMP = 800; // fixme: support both F and C on plots.
// int MAX_TIME = 30*60;
int idx = 0;
float timestamp = 0;
float [][] ambient = new float[2][MAX_TIME];
float [][] T0 = new float[2][MAX_TIME];
float [][] T1 = new float[2][MAX_TIME];
float [][] T2 = new float[2][MAX_TIME];
float [][] T3 = new float[2][MAX_TIME];

PFont labelFont;
PFont menuFont;

void setup() {
  frame.setResizable(true);
  labelFont = createFont("Courier", 18 );
  menuFont = createFont("Courier", 12 );
  
  println(logfilename);
  logfile = createWriter(logfilename);

  // size(screen.width, screen.height);
  size(800, 600);
  frameRate(5);
  smooth();
  background(0);

  try {
    profile_data = loadStrings(PROFILE);
  } catch (Exception e) {
    println("guide/desired profile not found. OK.");
  }
}

void do_error_msg()
{
  if (error_msg == null) return;
    fill(255,0,0);
    text(error_msg, 100, 100);
}
  
void drawgrid(){
  textFont(labelFont);
  stroke(128,128,128);
  for (int i=100; i<MAX_TEMP; i+=100) {
    text(str(i), 0, MAX_TEMP-i);
    line(0, MAX_TEMP-i, MAX_TIME, MAX_TEMP-i);
  }
  for (int i=1*60; i<MAX_TIME; i+=1*60) {
    text(str(i), i, MAX_TEMP);
    line(i, 0, i, MAX_TEMP);
  }
}

void drawchan(float [][] T, color c) {
  for (int i=1; i<idx; i++) {
    float x1 = T[0][i-1];
    float y1 = T[1][i-1];
    float x2 = T[0][i];
    float y2 = T[1][i];
    
    // sanity-check for noisy sensor data
    if (y1 > MAX_TEMP) y1 = MAX_TEMP;
    if (y2 > MAX_TEMP) y2 = MAX_TEMP;
    if (y1 < 0) y1 = 0;
    if (y2 < 0) y2 = 0;
    
    stroke(c);
    line(x1, MAX_TEMP-y1, x2, MAX_TEMP-y2);
  }
}

void drawprofile() {
  if (profile_data == null) return;
  int x1, y1, x2, y2;
  stroke(200,200,200);
  x1 = 0;
  y1 = 0;
  for (int i=0; i<profile_data.length; i++) {
    String[] rec = split(profile_data[i], ',');
    x2 = int(rec[0]);
    y2 = int(rec[1]);
    // println("x1,y1,x2,y2 " + x1 + " " + y1 + " " + x2 + " " + y2 );
    line(x1, MAX_TEMP-y1, x2, MAX_TEMP-y2);
    x1 = x2;
    y1 = y2;
  }
}

void keyPressed()
{
  if (( key == 13) || (key == 10) )  {
    if (kb_note.length() > 0) {
      println("# " + timestamp + " " + kb_note);
      logfile.println("# " + timestamp + " " + kb_note);
      kb_note = "";
    }
  } else if (key != CODED) {
    kb_note = kb_note + key;
  }
}

void drawnote() {
  if (kb_note.length() > 0) {
    textFont(labelFont);
    stroke(128,128,128);
    text(kb_note, 100, 100);
  }
}

void draw() {
  background(0);
  do_error_msg();
  comport_menu();
  float sx = 1.;
  float sy = 1.;
  sx = float(width) / MAX_TIME;
  sy = float(height) / MAX_TEMP;
  scale(sx, sy);
  drawgrid();
  drawprofile();

  drawchan(T0, color(255,0,0) );  
  drawchan(T1, color(0,255,0) );  
  drawchan(T2, color(0,0,255) );
  drawchan(T3, color(255,204,0) );  
  drawnote();
}

void serialEvent(Serial comport) {
  // grab a line of ascii text from the logger and sanity check it.
  String msg = comport.readStringUntil('\n');
  if (msg == null) return;
  msg = trim(msg);
  if (msg.length() == 0) return;

  // always store in file - good for debugging, version-tracking, etc.
  //logfile.println(msg);

  if (msg.charAt(0) == '#') {
    logfile.println(msg);
    println(msg);
    return;
  }
  
  String[] rec = split(msg, ",");
//  String[] rec = split(msg, "\t");
  if (rec.length != 6) {
    println("Ignoring unknown msg from logger: " + msg);
    return;
  }
  
  timestamp = float(rec[0]);
  ambient[0][idx] = timestamp;
  ambient[1][idx] = float(rec[1]);
  T0[0][idx] = timestamp;
  T0[1][idx] = float(rec[2]);
  T1[0][idx] = timestamp;
  T1[1][idx] = float(rec[3]);
  T2[0][idx] = timestamp;
  T2[1][idx] = float(rec[4]);
  T3[0][idx] = timestamp;
  // hack for line-voltage monitoring. scale uV to 100
  // rec[5] = str( float(rec[5]) / 10000.) ;
  T3[1][idx] = float(rec[5]);
  

  for (int i=0; i<6; i++) {
    print(rec[i]);
    logfile.print(rec[i]);
    if (i < 5) print(",");
    if (i < 5) logfile.print(",");
  }
  
  logfile.println();
  println();
  
  idx++;
  idx = idx % MAX_TIME;
}

void stop() {
  try {
    comport.stop();
  } catch (Exception e) {
    println("Can't stop serial port");
  }
  try {
    logfile.flush();
    logfile.close();
  } catch (Exception e) {
    println("Can't flush/close log file");
  }
  println("Data was written to: " + logfilename);
}

void mousePressed()
{
  comport_mousePressed();
}
