greencardigan/TC4-shield/(commit log)

2010-06-25 initial Eagle files
    [tc4-controller-01.brd, tc4-controller-01.sch]
2010-06-26 update with latest arduino and host example code
2010-06-26 Successful test of TC4 1.06R board connected to thermocouple calibrator + 3 type K bead sensors, running pj_logger without myprofile.csv.
2010-06-27 Added README.txt files to TypeK and PWM16 library folders.
2010-06-27 clean up demos - get rid of line voltage hacks on channel 3
2010-06-27 Added aj_logger sketch. Updated README's for PWM16 and ADCdvlp.
2010-06-27 Added link for ordering a bare PCB.
2010-06-27 cleaned up, added comments to PWM16.h
2010-06-28 example ET profile
    [myprofile.csv]
2010-06-28 Deleted myprofile.csv.
    [myprofile.csv]
2010-06-28 Added results of initial testing of the TC-4 shield.
    [testlog001.csv]
2010-06-28 Added testlog001.xlxs
    [testlog001.xlsx]
2010-06-28 back to continuous mode with a better workaround
    [demo2.pde]
2010-07-01 first cut at quick-start guide
2010-07-01 clean-up and catch some errors
    [p_logger.pde]
2010-07-02 Added alternative screw terminal information.
2010-07-02 Added pRiser
    [roast_2010_7_1_23_27_3.csv]
2010-07-02 Removed pRiser
    [roast_2010_7_1_23_27_3.csv]
2010-07-02 Increased maximum allowable samples in Riser from 16 to 20 (for air roasters)
2010-07-03 Fixed bug in get_samples() that did not allow 3 channel operation.
    [aRiser.pde]
2010-07-04 Corrected README.txt to reflect removal of channel 2 RoR trace.
2010-07-05 Sample pBourbon.cfg added.
2010-07-05 Shortened some delay times in aBourbon.pde. Was causing long lags in start of roast logging.
    [aBourbon.pde]
2010-07-07 First cut at creating LCD output strings. Needs testing.
2010-07-08 Worked around sprintf bugs (doesn't work for floats?). Switched to whole number outputs for LCD (no decimal places). Tested LCD string creation -- OK. Needs to be tested on 16 x 2 LCD.
2010-07-11 Revised LCD pin definitions. Tested operation -- OK.
2010-07-11 Added v2 schematic
2010-07-11 Added v2 board file
2010-07-11 Oops. Added wrong file.
    [tc4-controller-01.brd]
2010-07-11 Committed revised v2 board file.
2010-07-13 Added reset switch, analog input to V2.00 board.
2010-07-13 Added analog potentiometer input headers.
    [tc4-controller-02.brd, tc4-controller-02.sch]
2010-07-20 Added 24LC512-I/SM EEPROM to PCB.
    [tc4-controller-02.brd, tc4-controller-02.sch]
2010-07-20 Added PDF version of V2.0 schematic.
2010-07-20 Renamed board PDF file.
2010-07-20 added Randys arduino sketch
2010-07-20 experimental tcp socket version
2010-07-20 added profile guide and line-oriented keyboard entry
    [myprofile.csv]
2010-07-20 Added decoupling capacitor for EEPROM. Cleaned up schematic.
    [tc4-controller-02.brd, tc4-controller-02.sch]
2010-07-20 Added documentation for Arduino pin assignments associated with TC4 shield design.
    [TC4-pins.xlsx]
2010-07-20 Fixed printing format on TC4-pins.xlsx
    [TC4-pins.xlsx]
2010-07-20 Added note about SPI pins.
    [TC4-pins.xlsx]
2010-07-21 Changed diode and base resistors for OT1 and OT2. Increased current capacity to 200mA per output.
    [tc4-controller-02.brd, tc4-controller-02.sch]
2010-07-21 more tweaks to conform to Bourbon
    [pBugisu.cfg]
2010-07-22 Removed RESET switch from V2 board. Moved 512K EEPROM to front of board.
    [tc4-controller-02.brd, tc4-controller-02.sch]
2010-07-23 Changed C1 to surface mount.
    [tc4-controller-02.brd, tc4-controller-02.sch]
2010-07-23 Revised ground plane (now on bottom only).
    [tc4-controller-02.brd]
2010-07-24 Added temperature offset correction.
    [aBourbon.pde]
2010-07-24 Added method to override default temp offset correction (temporary fix until EEPROM calibration information is implemented.
2010-07-27 Minor revision to traces.
    [tc4-controller-02.brd]
2010-07-29 Added digital RC filtering class to cADC library
2010-08-01 Added filtering to input signals. NOT TESTED YET.
2010-08-03 Minor changes to cADC library to support calibration.
2010-08-03 Uploaded demoEEPROM3 sketch. Uses mcEEPROM library and demonstrates writing/reading of struct to 24LC512. Calibration EEPROM header defined in this sketch.
2010-08-03 Uploaded cal50 sketch. Facilitates calibration of ADC at 50.000mV input level.
2010-08-03 Uploaded calTypeK. This sketch facilitates temperature offset calibration for type K thermocouples.
2010-08-04 Changed aBourbon for compatibility with cADC filter class changes.
2010-08-06 Addressed the lag caused by COM library startup.
    [pBourbon.cfg]
2010-08-14 Uploaded draft version 3.00 of the TC4 shield. Increased the board size, added I2C header for remote LCD, split the analog input headers into two separate 1 x 3 pin headers.
    [tc4-controller-03.brd, tc4-controller-03.sch]
2010-08-15 Final versions uploaded of V3.00 of TC4 shield as sent to GoldPhoenix on 8/15/2010. Added via's around the MCP9800 to allow use of flywires if you want to mount the MCP9800 on a heat sink.
    [tc4-controller-03.brd]
2010-08-15 Copy eagle files into V300 folder.
    [tc4-controller-03.brd]
2010-08-15 Copy eagle files into V300 folder. Erase from sandbox folder.
    [tc4-controller-03.brd, tc4-controller-03.sch]
2010-08-20 Uploaded looper sketch (experiments with parallel conversions on the ADC and ambient sensor)
2010-08-21 Significant changes made to cADC library. Converted everything to one-shot mode on the MCP9800 and MCP3424 for better control and less battery drain.
2010-08-21 Revised cADC to remove filtering from the ADC class. Doesn't work well for multiple channels.
2010-08-21 Revised aBourbon.pde to work with new cADC classes. Got rid of using multiple samples for calculating RoR, and instead using digital RC filtering on the BT signal.
2010-08-21 Added code to support manual control PWM output on the SSR drive Ot1. Works smoothly with 100K single turn potentiometer on the ANLG1 port (AIN0). General cleanup of the code, including comments.
2010-08-25 Revisions made to calibration sketches for compatibility with new cADC library.
2010-09-09 Added BOM for V3.00 PCB.
    [v3BOM.xlsx]
2010-09-18 added guide profile (disabled by default). fixed race in serialevent
    [pBourbon.pde]
2010-09-18 oops wrong file checked in. also added line-oriented keyboard notes
    [pBourbon.pde]
2010-09-18 example guide profile
    [myprofile.csv]
2010-09-18 added a mention of power to the initial banner printf
2010-09-18 added parse of power field. not displayed yet
2010-09-22 Added optional support for I2C port expander for LCD display. This version of aBourbon requires use of the cLCD library.
2010-09-22 Uploaded cLCD library. Provides support for both I2C port expander interface with LCD and for standard 4-bit parallel interface.
2010-09-27 Cleaned up aBourbon.pde. Removed manual heater control option and keypad options, and moved them to the new aCatuai application. Changes made because aBourbon was getting a little out of control with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
2010-09-27 Uploaded new aCatuai.pde application. Similar to aBourbon, except aCatuai provides keypad interface and heater output control.
2010-09-28 Added LCD01 board file (Eagle)
    [LCD01.brd]
2010-09-28 Added LCD01 schematic file (Eagle)
    [LCD01.sch]
2010-09-28 Added LCD board hardware PDF file
2010-09-28 Added LCD board hardware schematic PDF
2010-09-29 Updated aBourbon application to utilize the 64K EEPROM on the Version 3.00 boards. Calibration data can optionally be stored in the EEPROM and will be read by the program if the EEPROM_BRBN define is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
2010-09-29 Catuai now reads calibration info from EEPROM.
2010-09-30 Minor syntax revision to PWM16.cpp
2010-10-09 Updates to aCatuai.pde. Heater output now in 5% increments. Button presses mark roast start, FC, SC, and eject. MIT License info added.
2010-10-09 Added p_Kona for first time
    [p_Kona.cfg]
2010-10-10 Minor revision to aCatuai.pde to make filtering compatible with channels 3 and 4, if used.
2010-10-11 Deleted old aKone.pde (has been replaced).
    [aKona.pde]
2010-10-14 added RoR averaging to smooth fluctuations
    [pBourbon.cfg]
2010-10-15 Uploaded cButton library for use with LCD adapter and 4-button interface.
2010-10-15 Uploaded buttons.pde, demo program that uses cButton library.
2010-10-16 Uploaded writeCal.pde for writing default calibration block information into a new EEPROM.
2010-10-16 Uploaded readCal.pde for non-destructive reading of EEPROM calibration block information.
2010-10-18 Creating a branch of pBourbon
    [myprofile.csv, pBourbon.cfg]
2010-10-18 Renamed for testing
    [myprofile.csv, pBourbon.cfg]
2010-10-23 Changed default filter level to 85% for RoR calculations.
2010-10-23 Changed pBourbon.pde to support default value of 1 (i.e. no averaging) for number of samples for averaging BT for RoR calculation.
    [pBourbon.cfg]
2010-10-28 Changed aBourbon.pde to use 85% filter level by default.
2010-10-30 Added support for MCP23008 port expander on I2C
2010-10-30 User options broken out into module
    [user.h]
2010-10-30 Remove test branch
    [myprofile.csv, pBourbon.cfg]
2010-10-30 Creating Release Candidate 1 for review
    [myprofile.csv, pBourbon.cfg]
2010-10-31 Fixed self inflicted problem with PWM
    [aCatuai.pde]
2010-11-06 Adding SendProfile, processing program to send profiles from PC to Kona
    [SendProfile.cfg]
2010-11-14 Creating RC2 branch
    [myprofile.csv, pBourbon.cfg]
2010-11-14 Guide profiles for RC2
    [Full City.csv, cityplus.csv, myprofile.csv]
2011-02-28 Uploaded V4.00 hardware schematic.
2011-02-28 Uploaded PDF of V4.00 board design.
2011-03-04 Updated buttons.pde to turn on LCD backlight.
2011-03-05 initial aGesha sketch -- just a cut/paste/fork of JimGg aBourbon
2011-03-05 Jim, is this correct? Added a note that when using this library, both pins DIO9 and DIO10 are dedicated for PWM use.
2011-03-06 add simplistic variac calibration support files
2011-03-07 Changed folder name for LCD adapter to LCDapter
    [LCD01.brd, LCD01.sch]
2011-03-07 Added LCDapter V3.3 board PDF
2011-03-07 Added LCDapter V3.3 schematic PDF
2011-03-07 Added LCDapter V3.3 Bill of Material
2011-03-07 first cut variac voltages
2011-03-07 open-frame ac transformer instead of dc wal-wart
2011-03-07 open-frame transformer instead of wal-wart
2011-03-08 open-frame tranny instead wall-wart
2011-03-08 try lumped-constant losses
    [variacmar08a.csv]
2011-03-09 Added Bill of Material for V4.00 TC4 shield.
2011-03-09 Uploaded image of TC4 version 4.00 board.
2011-03-09 Uploaded image of TC4 version 4.00 board
2011-03-10 Uploaded image of LCD cable.
2011-03-12 fork of pBourbon for Gesha
    [pGesha.cfg]
2011-03-13 Updated the BOM for TC4, version 4.00.
2011-03-15 increase filtering on both ambient and RoR
2011-03-17 change table to 5 sec update rate
    [pGesha.cfg]
2011-03-18 Uploaded Eagle board file for V4.00 PCB.
    [tc4-controller-0400.brd]
2011-03-18 Uploaded Eagle schematic file for V4.00 PCB.
    [tc4-controller-0400.sch]
2011-03-20 lastest juice box schematic
2011-03-23 quick workaround -- use TC3 for BT instead of TC1
    [aGesha.pde]
2011-04-03 Moved version 1 Eagle files into V106 folder for archiving.
    [tc4-controller-01.brd, tc4-controller-01.sch]
2011-04-03 Renamed hardware folders for clarity.
    [tc4-controller-01.brd, tc4-controller-01.sch]
2011-04-04 Copied current pBourbon source files into new trunk src folder.
    [myprofile.csv, pBourbon.cfg]
2011-04-04 Copied Patrick's pBourbon RC1 files into branch folder.
    [myprofile.csv, pBourbon.cfg]
2011-04-04 Copied Patrick's pBourbon RC2 files into branch folder.
    [Full City.csv, cityplus.csv, myprofile.csv, pBourbon.cfg]
2011-04-04 Minor changes to aCatuai. Changed "RoR" on LCD to "RT" to save a character. Added code so that power level pot is read immediately at start of sketch.
2011-04-04 Copied aGesha source files into reorganized repository folders.
    [variacmar08a.csv]
2011-04-04 Copied pGesha source files into reorganized repository folders.
    [pGesha.cfg]
2011-04-04 Deleted the sandbox folder from hardware. This contained the never-released version 2.00 of the TC4 PCB.
2011-04-04 Copied TC4 docs and PCB designs into new hardware folder in reorganized repository.
2011-04-04 Copied LCDapter folder into reorganized repository folder structure.
    [LCD01.brd, LCD01.sch]
2011-04-04 Created aBourbon folder so that working copy is compatible with Arduino IDE
2011-04-04 Added pBourbon.cfg to Brad's branch.
    [pBourbon.cfg]
2011-04-04 Renamed branch for Brad.
    [pBourbon.cfg]
2011-04-04 Renamed pBourbon branch folder.
    [myprofile.csv, pBourbon.cfg]
2011-04-04 Renamed pBourbon branch.
    [Full City.csv, cityplus.csv, myprofile.csv, pBourbon.cfg]
2011-04-04 Deleted Brad's branch (to get versioning working).
    [pBourbon.cfg]
2011-04-04 Copied pBourbon files into Brad's branch.
    [pBourbon.cfg]
2011-04-04 Committed Brad's pBourbon code (to get versioning to work).
    [pBourbon.cfg]
2011-04-04 Added Artisan folder in applications. Placeholder for development of Arduino sketch to support the Artisan roast monitor project.
2011-04-04 moved source files into pBourbon folder to facilitate checkout and development.
    [pBourbon.cfg]
2011-04-04 Moved source files into trunk/src/pBourbon folder to facilitate checkout and development.
    [myprofile.csv, pBourbon.cfg]
2011-04-04 Added trunk/src/pKona folder in the Kona application tree.
    [pKona.cfg]
2011-04-04 Added SendProfile folder tree to Kona application
    [SendProfile.cfg]
2011-04-04 Copied pKona into REL-20110319
    [pKona.cfg]
2011-04-04 Copied SendProfile source to REL-20110319
    [SendProfile.cfg]
2011-04-05 Moved buttons utility sketch to LCDapter folder. Use this sketch to test the operation of the LCDapter.
2011-04-05 Added README.txt to the buttons folder.
2011-04-06 Added button support to aBourbon. First button = roast start marker, turn on LED 1. Second button = first crack marker, turn on LED 2. Third button = second crack marker, turn on LED3. Fourth button 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
    [aBourbon.pde, user.h]
2011-04-06 Merged trunk revisions into branches/RB-200/aBourbon (button support for aBourbon).
2011-04-06 Committed Brad's changes to pBourbon in the branch. Updated to be compatible with roast markers coming from aBourbon.
    [myprofile.csv, myprofile_c.csv]
2011-04-06 Renamed Brad's branch for consistency with repository naming convention.
    [myprofile.csv, myprofile_c.csv, pBourbon.cfg]
2011-04-06 Renamed Patrick's branches for consistency with repository naming conventions.
    [myprofile.csv, pBourbon.cfg]
2011-04-06 Added RoR post-filtering to aBourbon RB-200
2011-04-08 Added logs from test roasts to Brad's pBourbon branch.
    [roast201104072014.csv, roast201104072021.csv, roast201104072110.csv]
2011-04-08 Added trial code to aBourbon trunk to respond to RESET command.
    [aBourbon.pde]
2011-04-08 Fixed a couple of oops in aBourbon trunk
    [aBourbon.pde]
2011-04-08 Committed revised aBourbon to trunk tree. Limited testing on RESET command -- appears to work well.
    [aBourbon.pde]
2011-04-09 Copied TRY-Brad branch to RB-200, preparing for release of pBourbon.
    [myprofile.csv, myprofile_c.csv, pBourbon.cfg, roast201104072014.csv, roast201104072021.csv, roast201104072110.csv]
2011-04-09 Committed Jim's RESET revision, and general cleanup for pBourbon, to RB-200
    [pBourbon.pde]
2011-04-09 Committed pBourbon with default settings for F units, no guide profile, 57600 baud, 16 minute max roast time. Edit pBourbon.cfg and pBourbon.pde to select custom values.
    [pBourbon.cfg]
2011-04-09 Small fixes to aArtisan.pde
    [aArtisan.pde]
2011-04-09 Minor correction to pBourbon.pde
    [pBourbon.pde]
2011-04-09 Moved current libraries source into tags/REL-100.
2011-04-09 Added LCDapter-330 eagle files.
    [LCDapter-330.brd, LCDapter-330.sch]
2011-04-13 Added backlight switching to util program buttons.pde.
2011-04-13 Committed revised aKona to the TRY branch (backlight issue).
    [aKona.pde]
2011-04-14 Revised filtering in aArtisan.pde. Improved robustness of serial command reader for stops and starts by Artisan.
2011-04-15 pBourbon RB-200: fixed a minor bug with screen capture; added some comments; added choice of background color. Ready for release.
    [logfile.csv, logfile_c.csv]
2011-04-15 Copied RB-200/pBourbon into tags/REL-200
    [logfile.csv, logfile_c.csv, myprofile.csv, myprofile_c.csv, pBourbon.cfg, roast201104072014.csv, roast201104072021.csv, roast201104072110.csv]
2011-04-15 Made a duplicate copy of Bourbon REL-200 in the pBourbon tree tags folder.
    [logfile.csv, logfile_c.csv, myprofile.csv, myprofile_c.csv, pBourbon.cfg, roast201104072014.csv, roast201104072021.csv, roast201104072110.csv]
2011-04-15 Fixed an oops.
    [logfile.csv, logfile_c.csv, myprofile.csv, myprofile_c.csv, pBourbon.cfg, roast201104072014.csv, roast201104072021.csv, roast201104072110.csv]
2011-04-15 Committed the RB-200 branch of pBourbon back to the main trunk.
    [logfile.csv, logfile_c.csv, myprofile_c.csv, pBourbon.cfg]
2011-04-16 Fixed some timing issues with serial comm's at startup of pBourbon when using the Uno.
    [pBourbon.pde]
2011-04-16 One more change to fix the pBourbon timing issue with Uno.
    [pBourbon.pde]
2011-04-16 Merged trunk revisions to RB-200 for pBourbon. Fixed the synchronizing problem with slow (Uno) serial communications.
    [pBourbon.pde]
2011-04-16 Revisions to pBourbon in trunk. Guide profile and saved logfile are now automatically read if they are present. Moving toward a standalone application that only requires a config file, and moving awa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
    [pBourbon.cfg]
2011-04-16 Renaming sample guide profiles and saved log files for pBourbon.
    [_logfile.csv]
2011-04-17 Revised pCOMlist to use a larger window. Device names for Linux and Mac OS X don't fit into small window.
2011-04-18 Minor revision to pBourbon startSerial() function.
    [pBourbon.cfg]
2011-04-18 Copied source code for pBourbon into REL-210 from branch.
    [logfile.csv, logfile_c.csv, myprofile.csv, myprofile_c.csv, pBourbon.cfg, roast201104072014.csv, roast201104072021.csv, roast201104072110.csv]
2011-04-20 Updated aKona to next rev for pKona serial commands, artisan support, bug fixes
    [aKona.pde]
2011-04-23 Minor revisions to COM port opening sequence in pBourbon
    [pBourbon.cfg]
2011-04-24 Revised pBourbon.pde for variable framerate.
2011-04-25 Added aPWM, a simple manual controller using PWM for an SSR drive or for DC fan control.
2011-05-10 Added photo of new purple board.
2011-05-15 Revised the BOM for TC4 version 4.00
2011-05-19 Revised TC4 version 4.00 BOM
2011-05-22 Copied current aCatuai trunk into TRY-reset-Jim
    [aCatuai.pde]
2011-05-22 Brought Catuai up to date with recent changes to aBourbon. Added DC fan control capability (for Hottop or other roasters with DC fans).
2011-05-23 Updates to aBourbon, aCatuai, and pBourbon. pBourbon will now sense whether or not output levels (OT1 and OT2) are in the data stream, and plot them if found. aBourbon no longer outputs a dummy value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
    [pBourbon.cfg]
2011-05-23 Copied pBourbon from trunk to REL-220
    [_logfile.csv, _logfile_c.csv, _profile.csv, _profile_c.csv, pBourbon.cfg]
2011-05-23 Copied pBourbon to aBourbon REL-220
    [_logfile.csv, _logfile_c.csv, _profile.csv, _profile_c.csv, pBourbon.cfg]
2011-05-23 Copied pBourbon to aCatuai REL-100
    [_logfile.csv, _logfile_c.csv, _profile.csv, _profile_c.csv, pBourbon.cfg]
2011-05-28 Reversed BT and ET in aArtisan for compatibility with 0.5 release.
    [aArtisan.pde]
2011-05-29 Fixed BT, ET order aArtisan.pde. Made commands case insensitive.
    [aArtisan.pde, user.h]
2011-05-30 Fixed code error with pinMode command.
    [aArtisan.pde]
2011-05-30 Created calibration folder.
2011-05-30 Moved cal_K to calibration folder.
2011-05-30 moved cal_mv to calibration folder
2011-05-31 Standardized applications/util/calibration/cal_K/cal_K.pde to use TC2, and applications/util/calibration/cal_mV/cal_mV.pde to use TC1.
2011-05-31 Fixed digitalWrite(LOW) problem with A0 to A5 pins.
    [aArtisan.pde]
2011-06-03 Copied current libraries into aArtisan tag REL-105
2011-06-03 Revision to TC4app getSamples for error checking; minor changes to appbase.pde demo.
    [appbase.pde]
2011-06-08 Copied trunk PWM16 into aArtisan REL-106beta library folder
2011-06-11 Revised cal_K calibration sketch. Added options to utilize selectable ADC and ambient sensor operating modes.
2011-06-11 Copied PWM16 library into tag REL-200
2011-07-22 Added TRY branch for variable frequency PWM on IO3
2011-07-22 Copy PWM16 trunk to TRY branch.
2011-07-22 Revisions to TRY branch PWM16 for IO3.
2011-07-22 Added frequency table to PWM16 for IO3
2011-07-23 Revisions to PWM16 library in TRY branch. Fixed frequency errors in timer1. Added PWM_IO3 class.
2011-07-23 Revisions to aCatuai trunk and aPWM to use new PWM_IO3 class.
2011-09-02 Merged PMW16 try branch code into trunk. This revision adds PWM control for IO3 and fixes small errors in frequencies for OT1 and OT2.
2011-09-03 aBourbon version 2.30. Stronger error checking on EEPROM data. Support for type J and type T.
    [aBourbon.pde, user.h]
2011-09-03 Added readCalBlock for better error checking on calibration data reads from EEPROM.
2011-09-03 Use readCalBlock() from mcEEPROM library for EEPROM calibration data.
2011-09-03 Copied pBourbon (rel. 220) to aBourbon rel 2.30
    [_logfile.csv, _logfile_c.csv, _profile.csv, _profile_c.csv, pBourbon.cfg]
2011-09-03 Copied PWM16 library into tag folder.
2011-09-03 Redefined STRT button for standalone mode (resets the timer).
    [aCatuai.pde]
2011-09-03 Copied pBourbon folder into Cataui tag REL-110
    [_logfile.csv, _logfile_c.csv, _profile.csv, _profile_c.csv, pBourbon.cfg]
2011-09-03 Copied PWM16 library into Cataui REL-110 tag folder.
2011-09-04 Corrected PWM frequencies for timer1.
2011-09-17 Moved IO3 output level updates into outer loop (aCatuai). Added version 5.20 board information in hardware.
2011-10-11 Revised aArtisan for multiple thermocouple types, better EEPROM error capture.
    [aArtisan.pde, user.h]
2011-10-12 Version 1.10 of aArtisan. Adds support for typeJ and typeT. Fixes problems with reading cal data from EEPROM.
    [aArtisan.pde, user.h]
2011-10-12 Copied current libraries into tag folder REL-110 for aArtisan.
2011-10-14 Update to writeCal.pde for board version.
2011-10-24 Added sketch to initialize EEPROM on TC4C boards.
2011-11-01 Revised writeCal_TC4C.pde for version 1.10. Added schematics and board drawing for TC4C version 1.10.
2011-11-02 Replaced TC4C schematic and board layout to agree with actual fabricated hardware.
2011-11-04 Added watchdog on AC power in aCatuaiQ
2011-11-22 Revisions to zero cross interrupt handler in aCatuaiQ. Tested successfully on P1 motor.
2011-11-22 Deleted obsolete timer1defs.h
2011-11-23 Added wiring diagram to aCatuaiQ folders.
2011-11-28 Put clean copy of original release 1.10 files in the TRY-Bhante branch.
    [_logfile.csv, _logfile_c.csv, _profile.csv, _profile_c.csv, pBourbon.cfg]
2011-11-30 Added phase correct PWM top values (per Bhante) to PWM16.h. Should not affect any existing applications.
2011-12-01 Revisions to aCatuai to fix overflowing integer timer values after 9 hours.
    [aCatuai.pde, user.h]
2011-12-16 Changed digital filtering level, added startup delay in cal_K.pde
2012-01-26 Created TRY branch for aArtisan conversion to Arduino 1.0
2012-01-26 Copied aArtisan trunk source to TRY branch for Arduino 1.0 conversion.
2012-01-26 Renamed aArtisan.pde to aArtisan.ino for Arduino 1.0 conversion.
2012-01-26 Created TRY branch for aBourbon, Arduino 1.0 compatible
2012-01-26 Copied aBourbon trunk source into TRY branch for Arduino 1.0 version
2012-01-26 Renamed aBourbon.pde to aBourbon.ino for Arduino 1.0 compatibility
2012-01-26 Created TRY-Arduino1.0 branch for aCataui
2012-01-26 Copied aCataui trunk source to Arduino 1.0 TRY branch.
2012-01-26 Renamed aCataui.pde to aCataui.ino in Arduino 1.0 TRY branch.
2012-01-26 Updated cADC library for Arduino 1.0 compatibility
2012-01-26 Updated cButton library for Arduino 1.0 compatibility
2012-01-26 Updated cLCD library for Arduino 1.0 compatibility
2012-01-26 Updated cmndproc library for Arduino 1.0 compatibility
2012-01-26 Updated mcEEPROM library for Arduino 1.0 compatibility
2012-01-26 Updated PWM16 library for Arduino 1.0 compatibility
2012-01-26 Updated thermocouple library for Arduino 1.0 compatibility
2012-01-26 Updated aArtisan, aBourbon, aCataui for Arduino 1.0 compatibility
2012-01-26 Updated README files for Arduino 1.0 versons of aBourbon, aCatuai
2012-01-26 Copied TRY branch version of aBourbon (Arduino 1.0 compatible) into tag folder.
2012-01-26 Copied TRY-Arduino1.0 code for aCataui into tag folder for 2.00 release.
2012-01-26 Copied TRY-Arduino1.0 source for aArtisan to REL-200 tag folder.
2012-01-27 Deleted aArtisan.ino from release 2.00 tag folder (to fix source code).
    [aArtisan.ino]
2012-01-27 Committed revise aArtisan.ino (corrected splash banner to version 2.00)
    [aArtisan.ino]
2012-01-27 Copied corrected aArtisan.ino, version 2.00, into tag folder.
    [aArtisan.ino]
2012-01-30 Ongoing improvements to pBourbon (better handling of remote not found, and add ability to plot power and fan outputs on guide profiles). Needs testing.
2012-01-31 Updated cal_K utility sketch for Arduino 1.0
2012-03-13 Added placeholders for pccontrol and arduinocontrol commands. Fixed reporting of fan output level on Serial.
    [RoastLoggerTC4.ino, user.h]
2012-04-26 Revised so that temperature scale is selectable by jumper on ANLG2 port.
2012-05-11 Heater, fan output 0 in setup; 4 sec PWM for heater.
2012-05-12 Fixed LCD display; ready for testing on live roast.
    [RoastLoggerTC4.ino]
2012-06-07 Tom's improvement to PWM frequency (7808Hz) for Hottop fan.
2012-07-01 Updated aArtisanQ to Arduino 1.0
2012-07-17 Added ZCD V006 board PDF
2012-07-17 Added ZCD V006 schematic PDF
2012-09-05 Fixed release number in banner RoastLoggerTC4 v. 2.0
    [RoastLoggerTC4.ino]
2012-09-12 Fixed banner on RoastLoggerTC4 trunk version.
    [RoastLoggerTC4.ino]
2012-09-22 Added PID_v1 library to repository. This code was downloaded from arduino.cc and is duplicated here for convenience of TC4 users only.
2012-09-23 Fixed incorrect release number.
    [Profile_Loader.ino, aArtisanQ_PID.ino, cmndreader.cpp, cmndreader.h, phase_ctrl.cpp, phase_ctrl.h, timer1defs.h]
2012-10-07 Fixed PID tuning command
    [aArtisanQ_PID.ino]
2013-01-14 Added schematics and board layouts for LCDapterC 1.21, TC4 5.30, and TC4C 1.31.
2013-01-16 Removed temporary debugging code and fixed(?) RoR calcs
    [aArtisanQ_PID.ino]
2013-01-21 Added code to allow for additional LCD display modes Added ability to change roast profile using LCD and buttons
2013-01-21 Modified code for button checks
2013-01-26 Copied TRY-Arduino 1.0 branch into trunk.
2013-02-03 Update to support user-selectable thermocouple types on each channel as in aArtisan 2.10 Also updated sample filtering to match aArtisan 2.10
2013-02-06 Updated TC4 pin definitions and uses.
2013-03-21 Added DXF drawing of TC4C board.
2013-05-27 Compatibility with Arduino 1.x
2014-01-28 Improved handling of heater and fan power limits
2014-01-28 Fixed error in aArtisanQ_PID Roastlogger code Fan=xx comand didn't send/n
    [aArtisanQ_PID.ino]
2014-02-13 Bug fixes in aArtisanQ_PID
    [aArtisanQ_PID.ino, cmndreader.cpp, cmndreader.h, user.h]
2014-03-23 Temperature scale selectable at compile time.
2014-03-23 Release 2.1 makes temperature scale selectable at compile time
2014-04-08 RoatLoggerTC4.ino, version 3RC. Implements slew rate control for DC fans, runtime-selectable temperature scale.
2014-04-10 RC2 re-enables hardware override of default temperature scale, but only checked at startup now.
2014-04-10 Added initialization of fan variables, changed banner to version 3.0. Ready for release.
2014-04-13 Add DCFAN command to address current inrush issues. Change baud to 115,200.
    [aArtisan.ino, cmndreader.cpp, cmndreader.h, user.h]
2014-04-17 Created try branch folder for PID code.
2014-04-17 Created try branch for adding PID code
2014-04-17 aArtisan updated to include basic PID functions. Ready for alpha testing.
2014-04-18 Added some revised/corrected comments about kp, ki, kd versus Watlow-style Pb, rE, and rA tuning parameters.
    [user.h]
2014-04-18 Added pid.txt, notes for PID control.
2014-04-18 Fixed an output string for ot2Cmnd
    [cmndreader.cpp]
2014-04-19 Makes PID cycle time user selectable.
2014-04-24 Minor edit to commands.txt for the PID CT command.
2014-04-26 Increases max token count to 5, max token size to 5 char. Needed for PID commands.
2014-05-12 Minor update to Arduino pin mapping for TC4 shields.
2014-05-12 Added PDF version of mapping of Arduino pins used by TC4 shield.
2014-08-20 Added schematic, board layout, and photo of TC4C version 1.33
2014-10-23 aArtisan 3P, RC3. Adds output for heater duty, fan duty, and SV when PID is running. Added some new, faster PWM frequency options for OT1 and OT2.
2014-10-25 Explicitly turn off LED 13 at startup.
2014-10-29 Add FILT command to aArtisan.ino. Permits runtime adjustment of digital filtering levels on thermocouple input channels.
2015-01-12 Added toast notifications for logging actions, enhanced crack marker logging, coloured button text, disabled some buttons initially.
2015-01-15 Added ability to customise the text and associated serial commands for most buttons, added new app icon.
2015-02-24 Updated cButton.cpp for compatibility with stricter boolean type definition in Arduino 1.60.
2015-03-08 Bug fix for aArtisanQ_PID. Disables LCDapter button checks when roasting with other software.
    [aArtisanQ_PID.ino, user.h]
2015-03-08 Added new app icon, settings screen, added shared preferences for read interval and button text/commands, fixed graph redraw bug, other bug fixes.
2015-04-03 Added PID;SV command to aArtisanQ. Reduced SRAM usage further
2015-04-04 Added PID;CHAN and PID;CT commands to aArtisanQ_PID
2015-04-09 Added FILT, PID;CHAN, and PIT;CT commands to aArtisanQ_PID Updated Artisan logger() send heater and fan duty and SV if PID is active Updated READ command to match aArtisan Removed PLOT_POWER option M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
    [aArtisanQ_PID.ino, cmndreader.cpp, cmndreader.h, user.h]
2015-04-26 Changes to reduce memory and prevent random crashing in Arduino mode
    [aArtisanQ_PID.ino, cmndreader.cpp, cmndreader.h]
2015-06-12 Added schemtic and board image for TC4 shield version 6.00
2016-04-07 Test commit
    [Full City.csv, _logfile.csv, _logfile_c.csv, _profile.csv, _profile_c.csv, cityplus.csv, logfile.csv, logfile_c.csv]
2016-04-07 Added new branch in aArtisanQ_PID
    Attempting to add PWM outputs similar to aArtisan. Slow PWM on OT1 and
    OT2 and normal analogue out on IO3. Selectable via define in user.h.
2016-04-07 Added trial PWM support to aArtisanQ_PID
    Controlled by defining PHASE_ANGLE_CONTROL in user.h. Slow PWM on OT1
    and OT2 and normal PWM on IO3.
2016-04-08 Added auto heater cutout in PMW mode + Tidied up variable names and user.h
2016-04-09 update LCD library to make it compatible with Arduino 1.6.7
2016-04-15 Added PWM out on IO5. Enable with IO5_PWM_OT1 in user.h
    Added classes to control outputs.
    Removed counter csv values sent in Arduino mode.
    Roast logger commands only loaded in roast logger mode.
2016-04-16 Added fast PWM to Phase Angle Control Mode on IO3
    Moved default zero-cross interrupt to IO2.
    Allows fast PWM (3.922kHz) available in Phase Angle Control Mode on
    IO3. Enable using IO3_HTR in user.h.
    Also does 3.922kHz PWM for DC fan on IO3 in PWM mode.
    Added Min and Max for IO3 output
    Added zip file for version 6_2 for testing
2016-11-08 Bug fix
    Fixed limits for analogue inputs
    [aArtisanQ_PID.ino]
2016-12-15 Jim's fix to disable pwmio3 constructor
    Added Jim’s fix to disable constructor of pwmio3 unless IO3_HTR is
    defined or PHASE_ANGLE_CONTROL is not defined.
    Changed default for HTR_CUTOFF_FAN_VAL in user.h
    [aArtisanQ_PID.ino, user.h]
2016-12-17 Added some compile directives to disable the pwmio3 variable when IO3_HTR_PAC is not defined (JGG)
    This was causing the pullup on IO3 to be disabled and interfered with
    use of IO3 as the ZCD input
    Changes to user.h (and others) to implement pre-defined configurations
    [aArtisanQ_PID.ino, cmndreader.cpp, cmndreader.h, phase_ctrl.cpp, phase_ctrl.h, user.h]
2016-12-17 Bug fix in heater cutoff code
    Heater power was not being automatically reinstated when using heater
    on OT1
    [aArtisanQ_PID.ino]
2017-03-21 Bug fix issue #1
    [aArtisanQ_PID.ino]
2017-09-24 Bug fix in aArtisanQ_PID_6_2_3
    pwmio3 was not being declared in some configurations
    [aArtisanQ_PID.ino, user.h]
2017-10-06 Change to PID;CHAN command and Logger() in aArtisanQ_PID
    Adjusted ROR_CHAN code to use physical channel rather then logical
    channel.
    Adjusted Logger() to send heater duty, fan duty and SV regardless of
    PID status
    Updated Commands.txt
2017-10-15 Change to PID;CHAN command and Logger() in aArtisan
    And added REL-311
2017-10-15 Minor fix to aArtisanQ_PID
    Minor update to change log, Logger() and commands.txt
    [aArtisanQ_PID.ino]
2017-10-15 Comment change in aArtisan 3.11 user.h
    Change to suit change in PID;CHAN command
2018-02-13 Adding support for cheap I2C LCDs
    Requires Newliquidcrystal_1.3.5 library.
    Also adds support for two buttons connected directly to input pins.
2018-02-13 Adding Newliquidcrystal_1.3.5 library
    Needed to support cheap I2C LCDs.
2018-05-29 Allow IO3 and DCFAN in CONFIG_PAC2 mode + support for 2 more buttons
    Changed compile directives to allow IO3 command and DCFAN command to be
    used in CONFIG_PAC2 mode.
    Added support for an additional 2 directly connected buttons to allow
    menu navigation in standalone mode.
    Minor bug fix in logger to add missing comma.
    [aArtisanQ_PID.ino, user.h]
2018-06-27 Creating branch to test AS726X color sensor
    Copy of aArtisanQ_PID 6_5 from trunk
2018-06-27 Adding code to support AS726X color sensor
    Adds new color comand and outputs color reading on channel 4 to Artisan.
2018-07-04 Adding aArtisanQ_PID_Stepper code
    Adds support for controlling a Clippard SCPV-1 valve/driver
2018-08-10 Adding aArtisanQ_PID branches for IO11 test and Fast PWM test
2018-09-13 Added updated PID library and aArtisanQ_PID support for updated library
    Modified serial command for PID tuning to support PID Mode.
    Added new compile directive in user.h to set P_ON_M PID Mode.
    Added new Serial command to set PID Limits
    Various code cleanups and typo fixes
    [aArtisanQ_PID.ino, cmndreader.cpp, phase_ctrl.cpp, phase_ctrl.h, user.h]
2018-11-30 Added compile directives to allow CONFIC_PAC3 mode to compile.
    Minor changes to user.h defaults.
    Replaced Configuration Options pdf with a more comprehensive guide.
    Added zip file for 6_7 release.
    [aArtisanQ_PID.ino, user.h]
2019-04-12 Added modified PWM16 library for fast pwm test branch
2021-12-15 Added new CONFIG_PAC2_IO3FAN mode + bug fixes
    Added new CONFIG_PAC2_IO3FAN mode wich uses ICC heater control on OT1 and PWM fan control on IO3
    Bug fix in PID;P;x command
    Bug fix for MAX_OT2 limit check in OT2 command
    Reassigned RS pin for parallel LCD connection from pin 2 to pin 5 to eliminate conflict between LCD and IO2
    [aArtisanQ_PID.ino, cmndreader.cpp, cmndreader.h, phase_ctrl.h, timer1defs.h, user.h]
2022-02-25 PID,Px command format change and bug fixes
    Changed PID profile selection command format from PID,Px to PID,P,x
    Bug fixes in PID,SV and PID,P,x commands
    [aArtisanQ_PID.ino, cmndreader.cpp]
2023-03-29 Bug fix in IO3;xxx command
    Bug fix in IO3;xxx command. MIN_IO3 and MAX_IO3 checks added.
    [aArtisanQ_PID.ino, cmndreader.cpp]
2024-12-16 Bug fix for thermocouple calibration
    Fixes thermocouple calibration in cADC library. Includes the missing UV_OFFSET calibration.
    Fixes calibration gain define issue in user.h. Renamed to CALIBRATION_GAIN as CAL_GAIN was already defined elsewhere.
    [aArtisanQ_PID.ino, user.h]
